okforth/1bICU/LU/LU.csv

Reference | Qty | Value | DNP | Exclude from BOM | Exclude from Board | Exclude from Simulation | Exclude from Position Files | Footprint | Datasheet
Q10,Q11,Q12,Q13,Q14,Q15,Q16,Q17,Q18,Q19,Q20,Q21,Q22,Q23,Q24,Q25,Q26,Q28,Q29,Q30,Q31,Q32,Q33,Q34,Q35,Q36,Q37,Q38,Q39,Q40,Q41,Q42,Q43,Q44,Q45,Q46,Q47,Q48,Q49,Q50 | 40 | NPN |  |  |  |  | ${EXCLUDE_FROM_POS_FILES} |  | https://ngspice.sourceforge.io/docs/ngspice-html-manual/manual.xhtml#cha_BJTs
R14,R16,R17,R19,R20,R21,R23,R25,R26,R27,R29,R31,R32,R34,R36,R37,R39,R43,R45,R47,R48,R50,R52,R53,R54,R56,R58,R59,R60,R62,R64,R65,R67,R69,R70,R72,R74,R75,R76,R78 | 40 | 22k |  |  |  |  | ${EXCLUDE_FROM_POS_FILES}
R15,R18,R22,R24,R28,R30,R33,R35,R38,R40,R44,R46,R49,R51,R55,R57,R61,R63,R66,R68,R71,R73,R77,R79 | 24 | 4.7k |  |  |  |  | ${EXCLUDE_FROM_POS_FILES}
