okforth/1bICU/main-list.csv

Reference | Qty | Value | DNP | Exclude from BOM | Exclude from Board | Exclude from Simulation | Exclude from Position Files | Footprint | Datasheet
D1,D2,D3 | 3 | YELLOW |  |  |  |  | ${EXCLUDE_FROM_POS_FILES}
Q1,Q2,Q3,Q4,Q5,Q6,Q7,Q8,Q9,Q10,Q11,Q12,Q13,Q14,Q15,Q16,Q17,Q18,Q19,Q20,Q21,Q22,Q23,Q24,Q25,Q26,Q27,Q28,Q29,Q30,Q31,Q32,Q33,Q34,Q35,Q36,Q37,Q38,Q39,Q40,Q41,Q42,Q43,Q44,Q45,Q46,Q47,Q48,Q49,Q50,Q51,Q52,Q53,Q54,Q55,Q56,Q57,Q58,Q59,Q60,Q61,Q62,Q63,Q64,Q65,Q66,Q67,Q68,Q69,Q70,Q71,Q72,Q73,Q74,Q75,Q76,Q77,Q78,Q79,Q80,Q81,Q82,Q83,Q84,Q85,Q86,Q87,Q88,Q89,Q90,Q91,Q92,Q93,Q94,Q95,Q96,Q97,Q98,Q99,Q100,Q101,Q102,Q106,Q107,Q108,Q110,Q112,Q113,Q114,Q115,Q116,Q117,Q118,Q119,Q120,Q121,Q122,Q129,Q130,Q131,Q132,Q133,Q134,Q135,Q136,Q137,Q138,Q139,Q140,Q141,Q143,Q147,Q148,Q149,Q150,Q151,Q152,Q153,Q154,Q155,Q156,Q161,Q163,Q164,Q165,Q166,Q167,Q168,Q169,Q170,Q171,Q172,Q173,Q174,Q175,Q176,Q177,Q178,Q179,Q180,Q181,Q182,Q183,Q245,Q246,Q261,Q262,Q263,Q264,Q265,Q266,Q267,Q268,Q269,Q270,Q272,Q273,Q274,Q275,Q276,Q277,Q278,Q279,Q280,Q281,Q282,Q283,Q285,Q286,Q287,Q290,Q291,Q292,Q295,Q296,Q297,Q299,Q300,Q301,Q302,Q303,Q304,Q305,Q306,Q307,Q308,Q309,Q310,Q311,Q312,Q313,Q314,Q315,Q316,Q317,Q318,Q319,Q320,Q321,Q322,Q323,Q324,Q325,Q326,Q327,Q328,Q329,Q330,Q331,Q332,Q333,Q334,Q335,Q336,Q337,Q338,Q339,Q340,Q341,Q342,Q343,Q344,Q345,Q346,Q347,Q348 | 246 | NPN |  |  |  |  | ${EXCLUDE_FROM_POS_FILES} |  | https://ngspice.sourceforge.io/docs/ngspice-html-manual/manual.xhtml#cha_BJTs
R1,R2,R3,R4,R5,R6,R7,R8,R13,R14,R15,R16,R29,R30,R31,R32,R33,R34,R35,R36,R38,R41,R42,R43,R44,R45,R46,R47,R49,R51,R57,R58,R59,R60,R61,R62,R63,R64,R69,R70,R71,R72,R81,R83,R85,R86,R87,R88,R91,R92,R93,R94,R98,R100,R101,R102,R103,R104,R105,R106,R107,R108,R109,R113,R114,R115,R116,R121,R122,R123,R124,R125,R126,R130,R131,R132,R136,R137,R138,R140,R147,R148,R149,R150,R151,R152,R153,R154,R156,R159,R162,R165,R171,R172,R173,R174,R175,R176,R177,R178,R184,R185,R186,R187,R188,R197,R199,R201,R202,R203,R205,R207,R213,R215,R216,R217,R218,R219,R222,R224,R226,R244,R245,R247,R251,R252,R253,R255,R259,R260,R262,R266,R267,R269,R275,R280,R281,R282,R284,R286,R287,R289,R291,R293,R294,R296,R300,R302,R304,R305,R307,R309,R310,R312,R314,R315,R317,R319,R320,R322,R324,R325,R327,R329,R330,R332,R474,R475,R507,R511,R512,R513,R515,R519,R520,R522,R526,R527,R529,R531,R534,R535,R537,R541,R542,R543,R545,R546,R547,R556,R558,R560,R565,R566,R567,R569,R570,R572,R575,R579,R580,R582,R586,R587,R589,R591,R594,R595,R597,R599,R600,R602,R606,R607,R608,R610,R614,R615,R617,R621,R622,R624,R626,R627,R629,R630,R632,R634,R636,R637,R639,R643,R644,R645,R647,R651,R652,R654,R658,R659,R661,R663,R666,R667,R669,R673,R675,R676,R678 | 249 | 22k |  |  |  |  | ${EXCLUDE_FROM_POS_FILES}
R9,R10,R11,R12,R17,R18,R19,R20,R65,R66,R67,R68,R73,R74,R75,R76,R246,R248,R261,R263,R506,R508,R521,R523,R536,R538,R581,R583,R601,R603,R616,R618,R638,R640,R653,R655 | 36 | 1k |  |  |  |  | ${EXCLUDE_FROM_POS_FILES}
R21,R22,R23,R24,R25,R26,R27,R28,R77,R78,R79,R142,R143,R144,R145,R146,R249,R250,R264,R265,R509,R510,R524,R525,R539,R540,R584,R585,R604,R605,R619,R620,R641,R642,R656,R657 | 36 | 10k |  |  |  |  | ${EXCLUDE_FROM_POS_FILES}
R37,R39,R40,R44,R45,R47,R48,R50,R52,R53,R54,R55,R56,R80,R82,R84,R89,R90,R95,R96,R97,R99,R110,R111,R112,R117,R118,R119,R120,R127,R128,R129,R133,R134,R135,R139,R141,R155,R157,R158,R160,R161,R163,R164,R166,R167,R168,R169,R170,R183,R193,R204,R206,R208,R214,R220,R221,R223,R225,R227,R254,R256,R257,R258,R268,R270,R271,R273,R283,R285,R288,R290,R292,R295,R297,R298,R299,R301,R303,R306,R308,R311,R313,R316,R318,R321,R323,R326,R328,R331,R333,R514,R516,R517,R518,R528,R530,R533,R550,R551,R552,R557,R559,R561,R571,R573,R574,R576,R577,R578,R588,R590,R592,R593,R596,R598,R609,R611,R612,R613,R623,R625,R628,R631,R633,R646,R648,R649,R650,R660,R662,R665,R668,R670,R671,R674,R677,R679 | 138 | 4.7k |  |  |  |  | ${EXCLUDE_FROM_POS_FILES}
R179,R180,R181,R182,R189,R190,R191,R192 | 8 | 2.2k |  |  |  |  | ${EXCLUDE_FROM_POS_FILES}
R635,R664,R672 | 3 | 220 |  |  |  |  | ${EXCLUDE_FROM_POS_FILES}
