okforth/1bICU/4x16 DEC/output.pdf

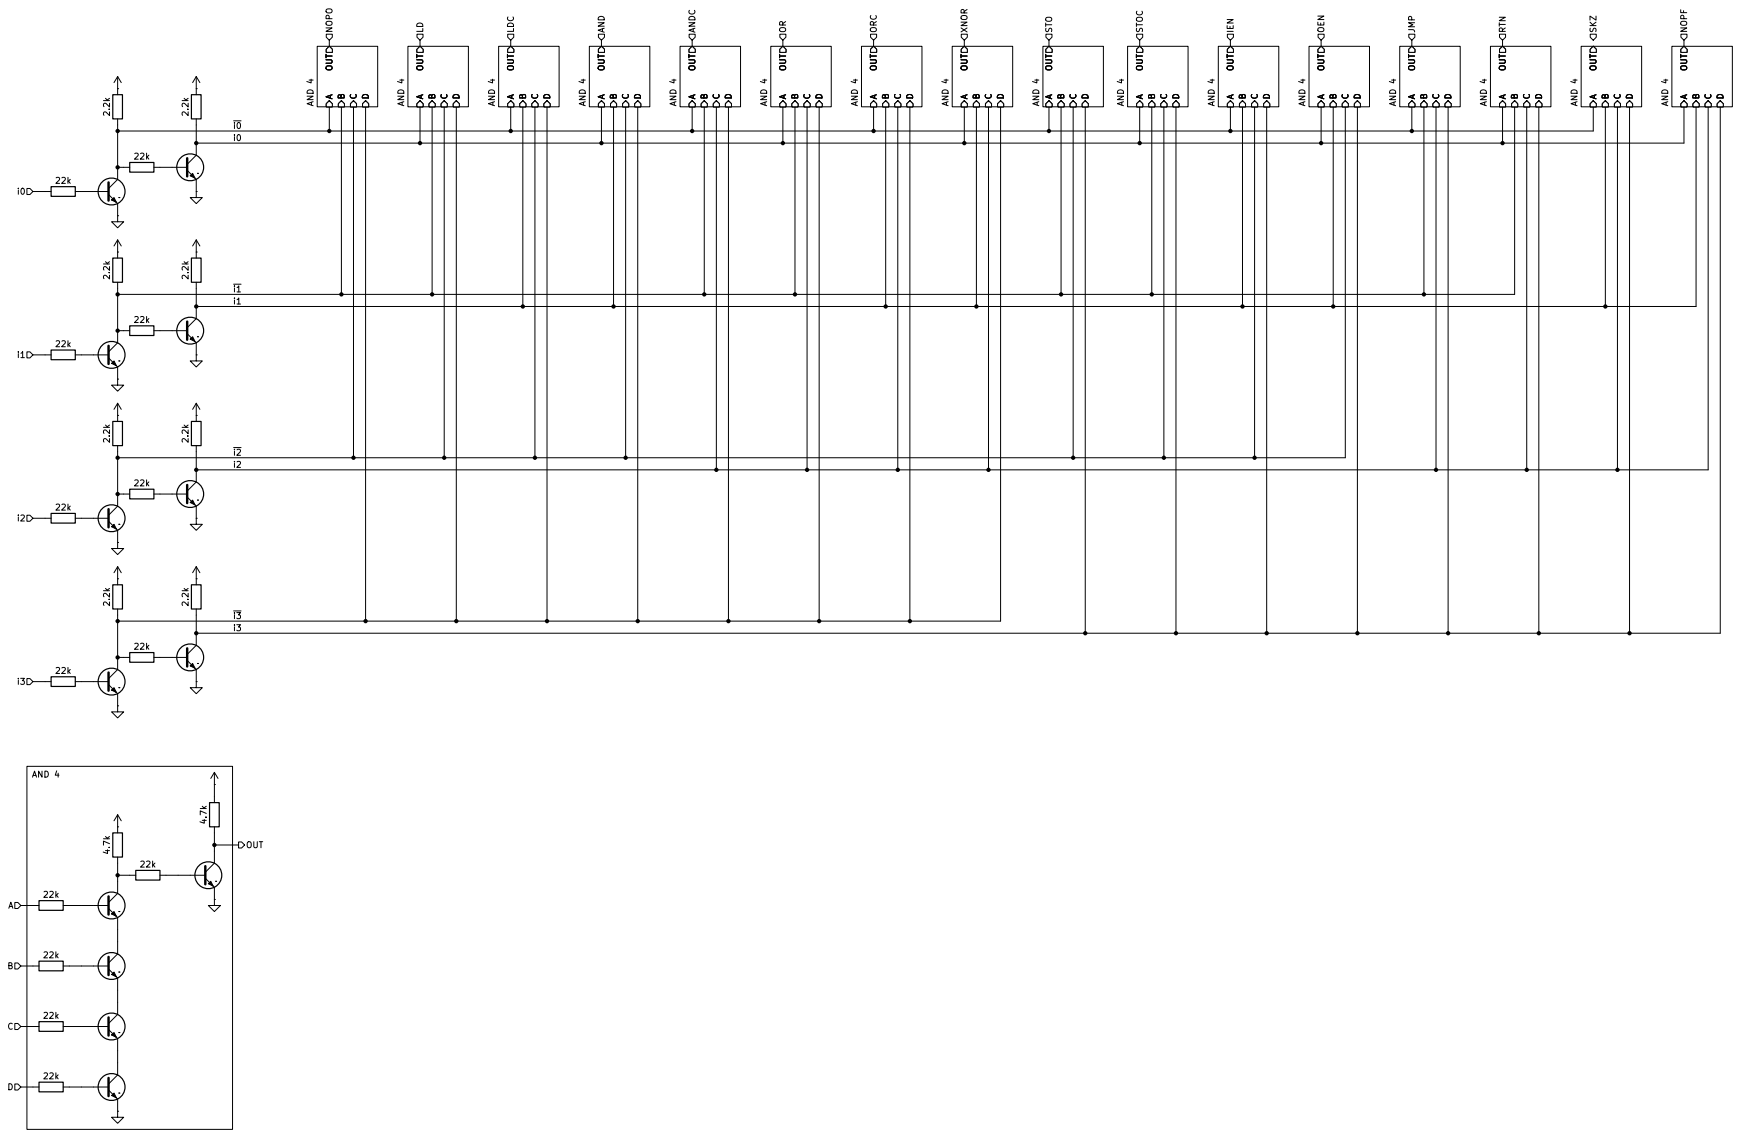
[picture p1: page 1]
