okforth/1bICU/DFF/output.pdf

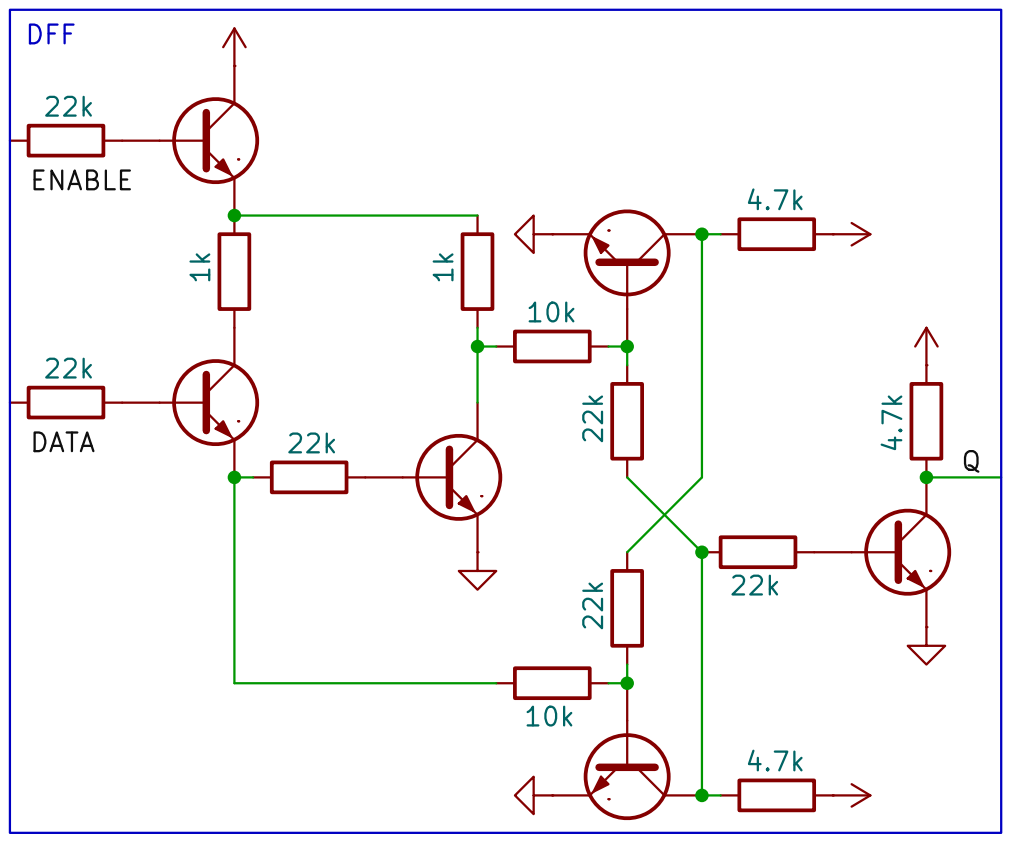
[picture p2: page 1]
