okforth/1bICU/INST REG/output.pdf

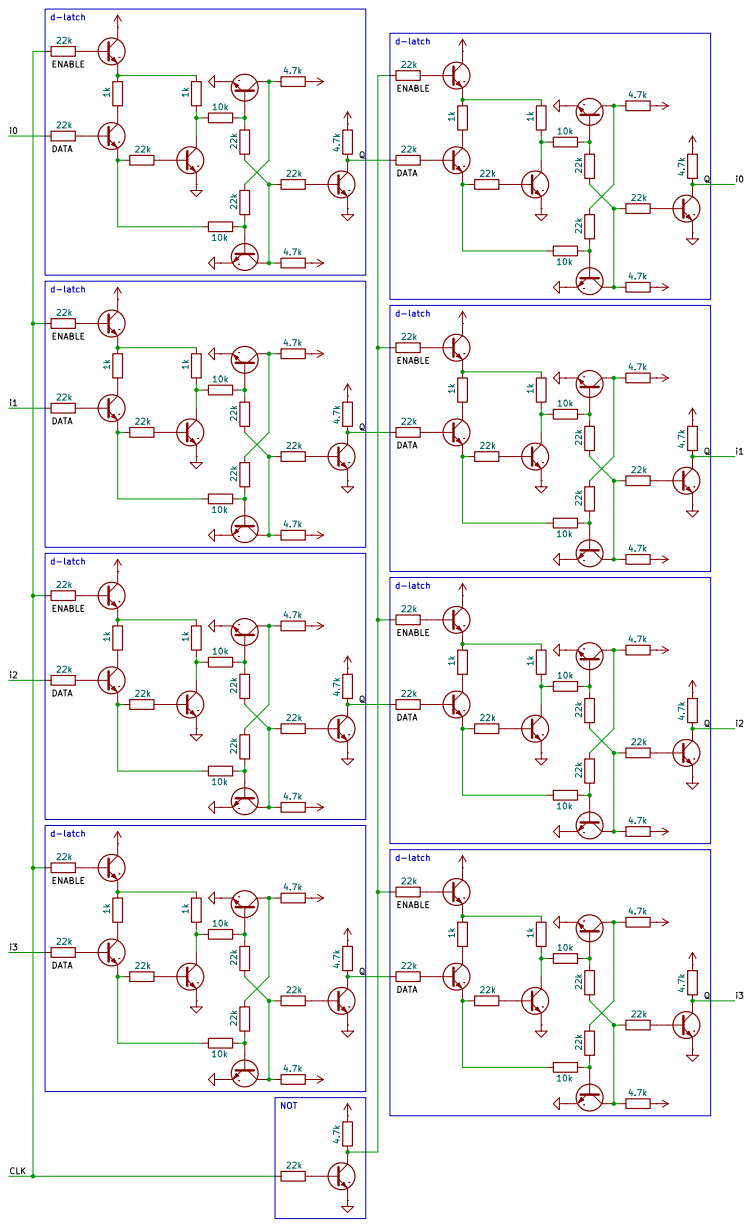
[picture p3: page 1]
