okforth/1bICU/LU/output.pdf

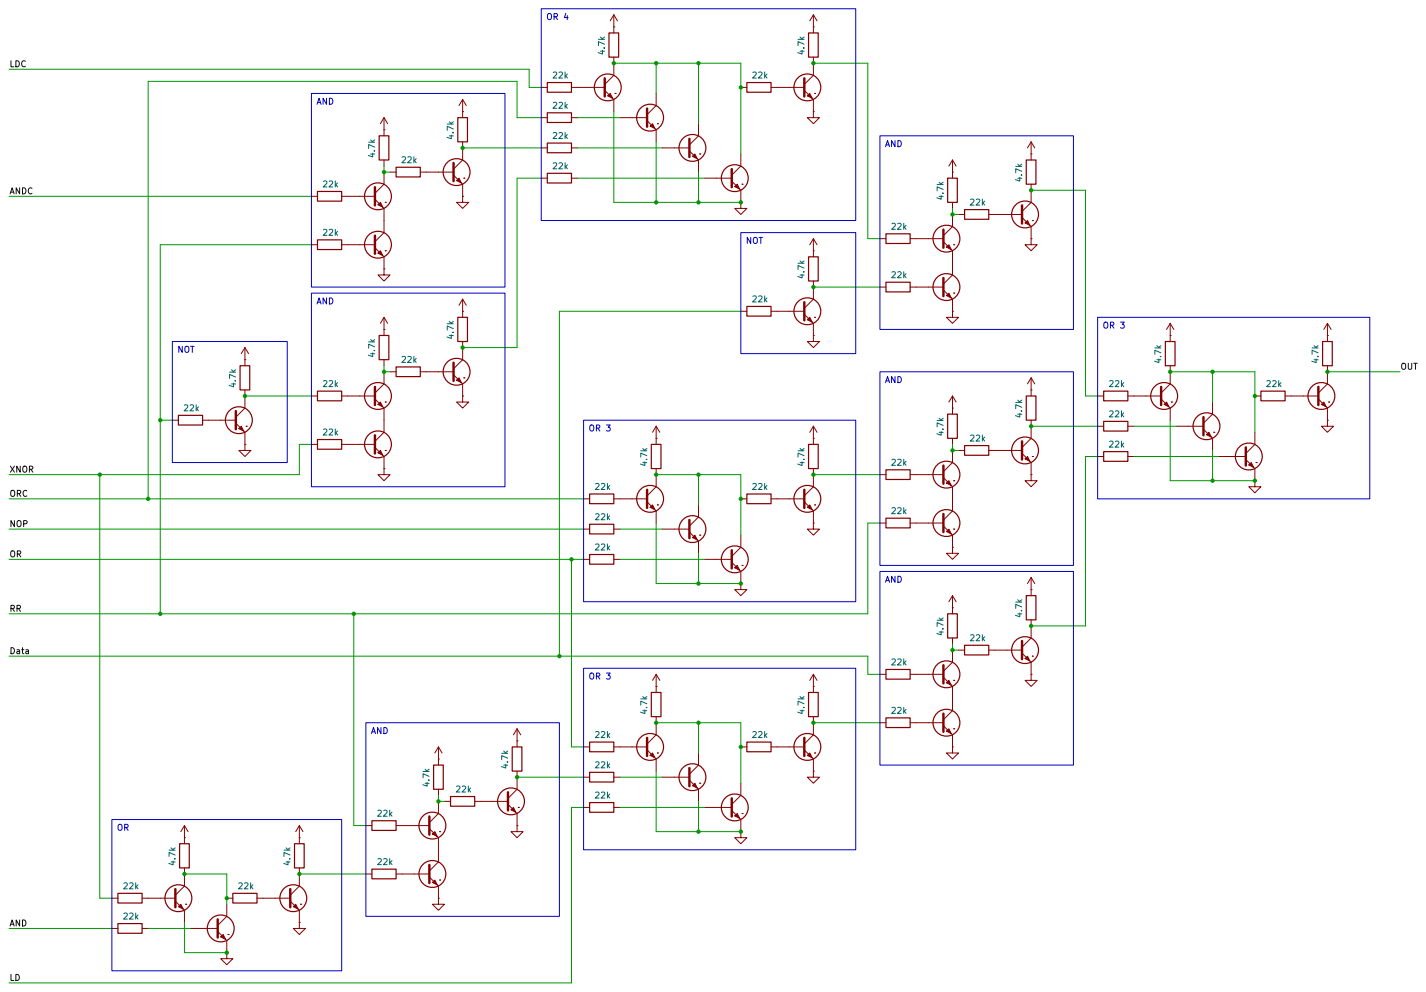
[picture p4: page 1]
