okforth/1bICU/(old)/1-bit adder/output.pdf

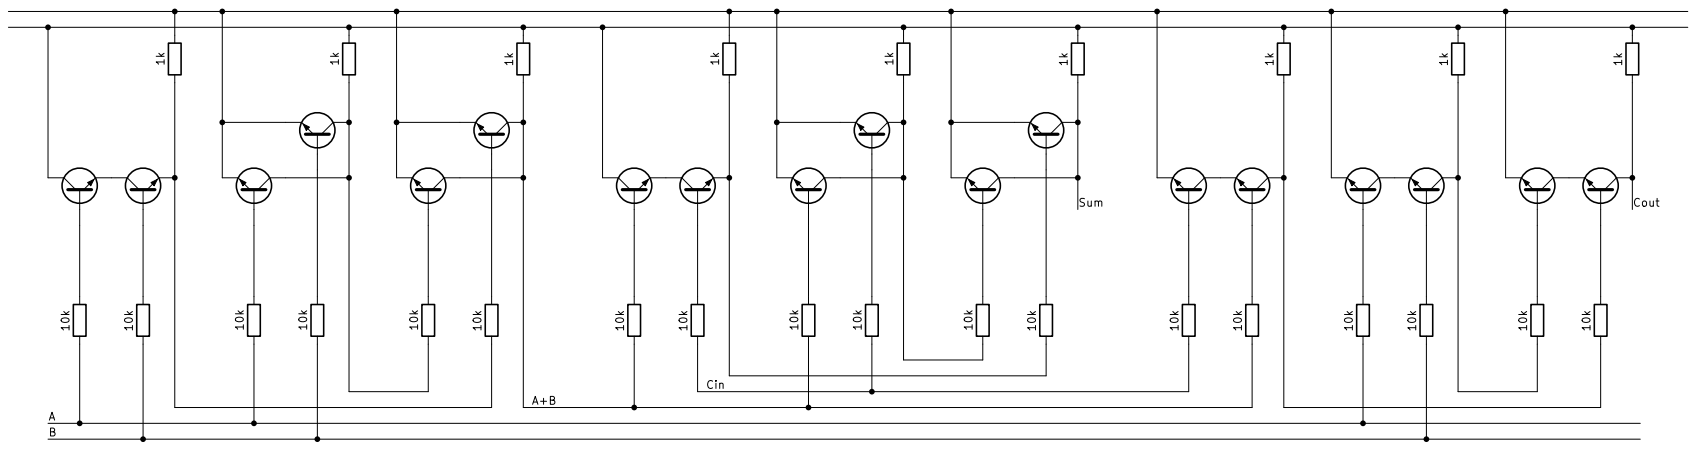
[picture p5: page 1]
