okforth/1bICU/4x16 DEC.kicad_sch

## KiCad design 4x16 DEC.kicad_sch (2026-10-11)

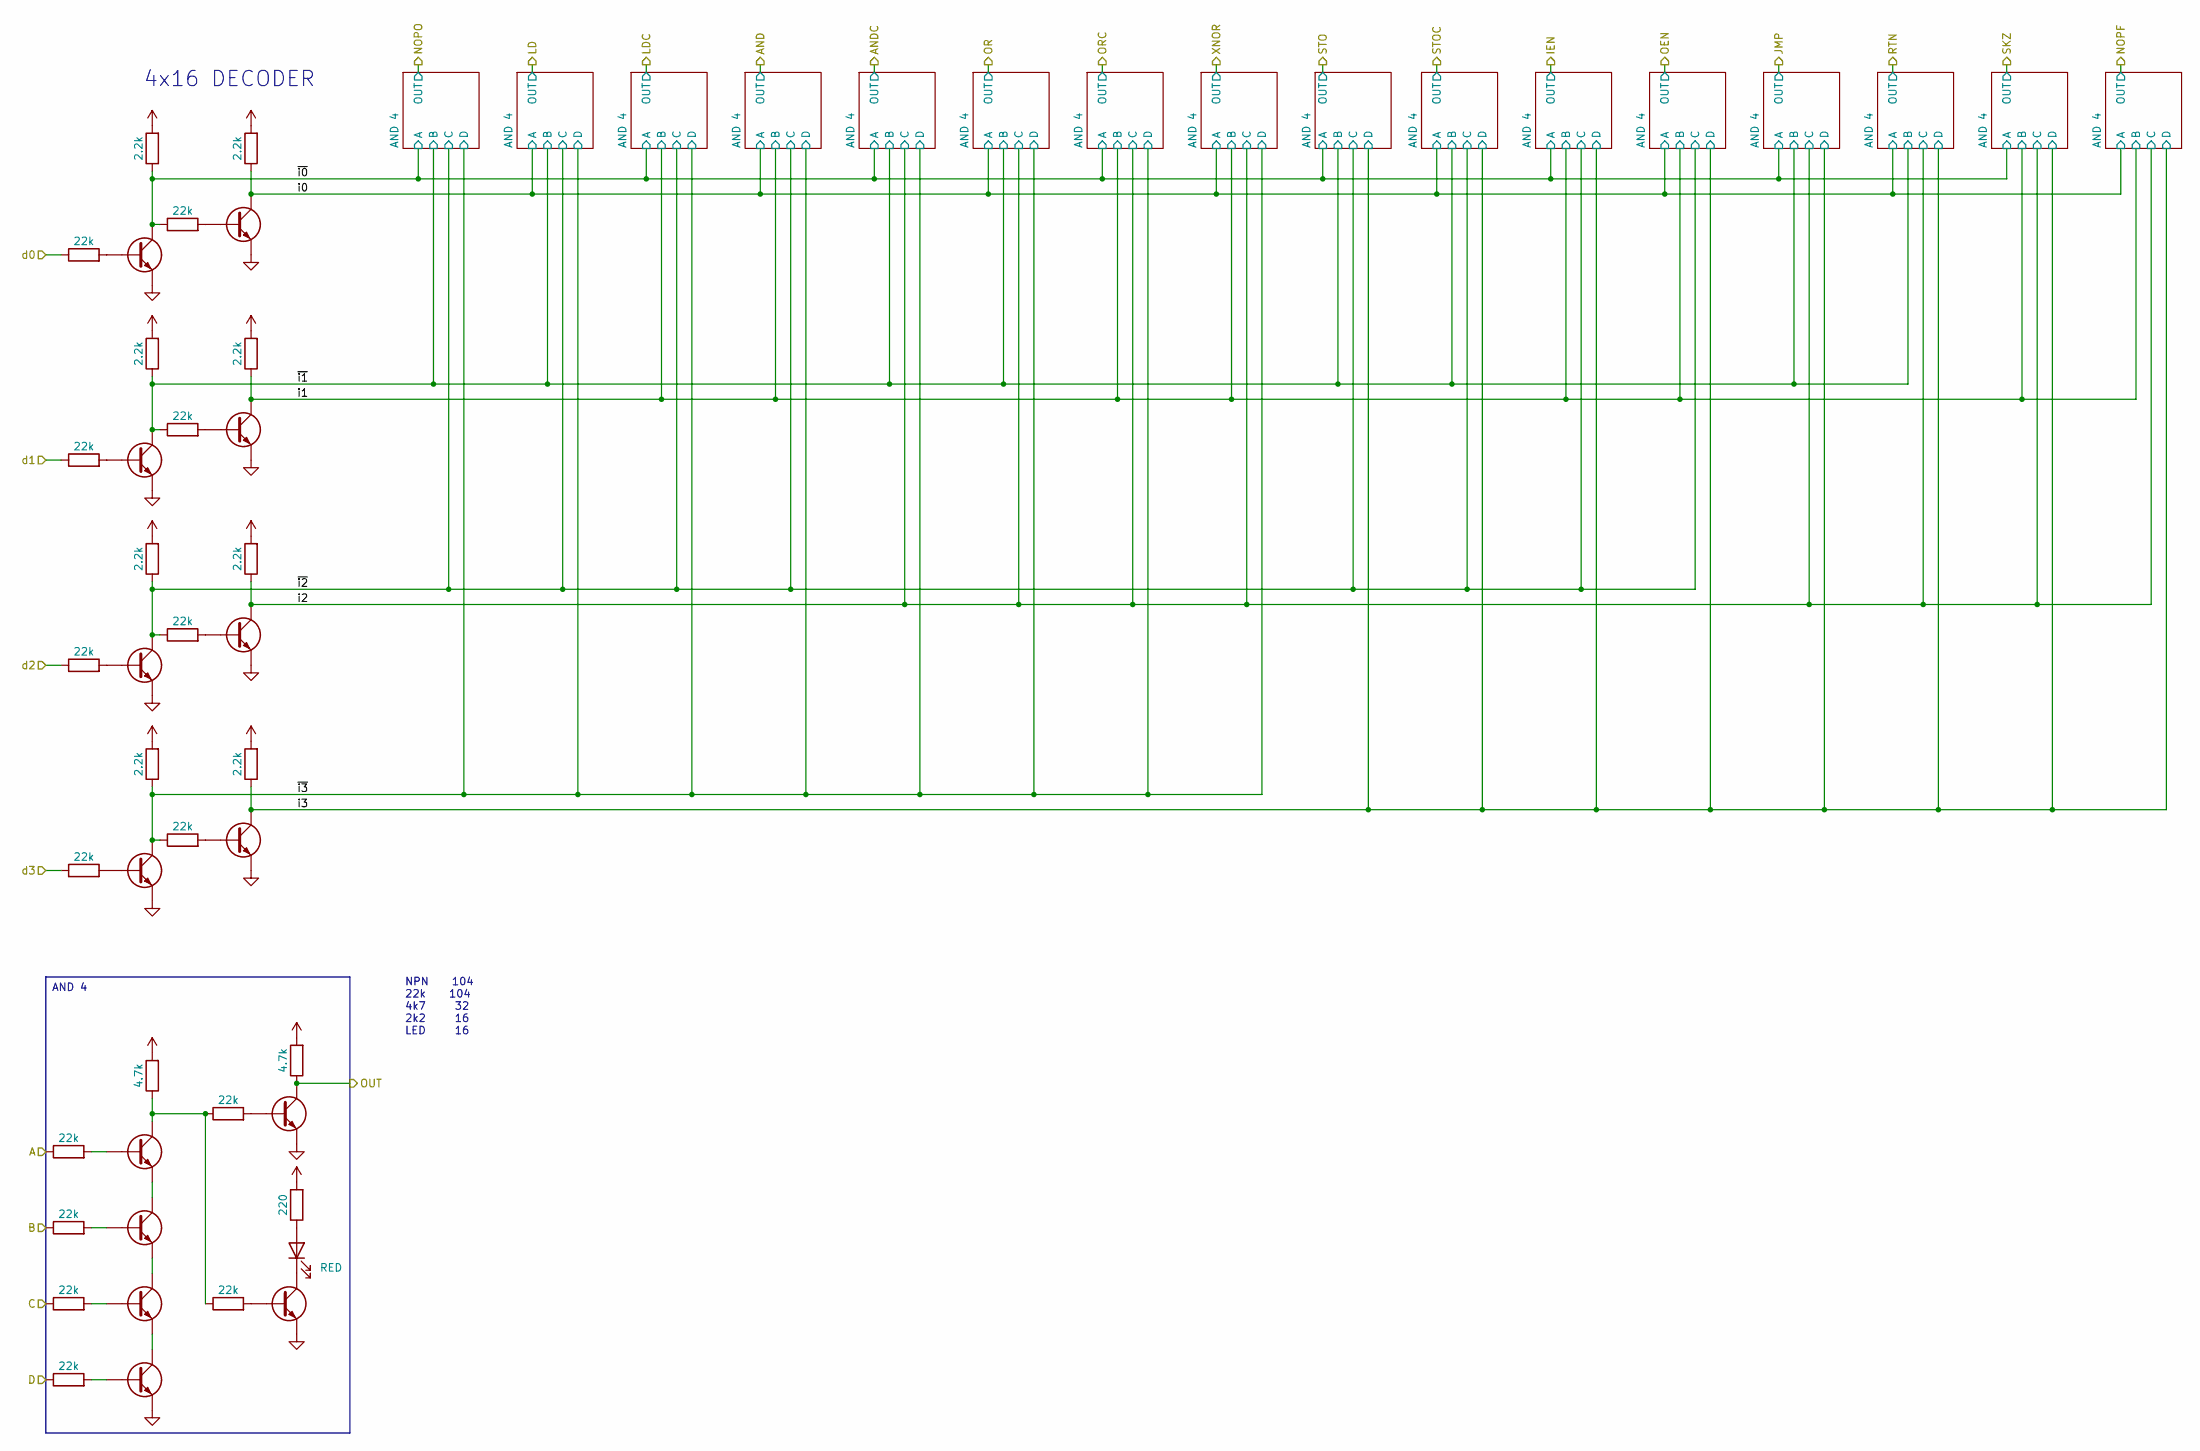
[picture p6: schematic 4x16 DEC.kicad_sch]

Parts:
D9: RED
Q90, Q91, Q92, Q93, Q94, Q95, Q96, Q97, Q98, Q99, Q100, Q101, Q102, Q103: NPN
R171, R172, R173, R174, R175, R176, R177, R178, R184, R185, R186, R187, R188, R200: 22k
R179, R180, R181, R182, R189, R190, R191, R192: 2.2k
R183, R193: 4.7k
R202: 220

Connections:
A: R171.1
B: R172.1
C: R173.1
D: R174.1
GND: Q90.3 (E), Q91.3 (E), Q92.3 (E), Q93.3 (E), Q97.3 (E), Q98.3 (E), Q99.3 (E), Q100.3 (E), Q101.3 (E), Q102.3 (E), Q103.3 (E)
unnamed: D9.1 (K), Q103.1 (C)
unnamed: D9.2 (A), R202.1
unnamed: Q90.2 (B), R175.2
unnamed: Q91.2 (B), R176.2
unnamed: Q92.2 (B), R177.2
unnamed: Q93.2 (B), R178.2
unnamed: Q94.1 (C), R183.1, R188.1, R200.1
unnamed: Q94.2 (B), R171.2
unnamed: Q94.3 (E), Q95.1 (C)
unnamed: Q95.2 (B), R172.2
unnamed: Q95.3 (E), Q96.1 (C)
unnamed: Q96.2 (B), R173.2
unnamed: Q96.3 (E), Q97.1 (C)
unnamed: Q97.2 (B), R174.2
unnamed: Q98.2 (B), R184.2
unnamed: Q99.2 (B), R185.2
unnamed: Q100.2 (B), R186.2
unnamed: Q101.2 (B), R187.2
unnamed: Q102.2 (B), R188.2
unnamed: Q103.2 (B), R200.2
OUT: Q102.1 (C), R193.1
VCC: R179.2, R180.2, R181.2, R182.2, R183.2, R189.2, R190.2, R191.2, R192.2, R193.2, R202.2
d0: R175.1
d1: R176.1
d2: R177.1
d3: R178.1
i0: Q98.1 (C), R189.1
i1: Q99.1 (C), R190.1
i2: Q100.1 (C), R191.1
i3: Q101.1 (C), R192.1
~i0: Q90.1 (C), R179.1, R184.1
~i1: Q91.1 (C), R180.1, R185.1
~i2: Q92.1 (C), R181.1, R186.1
~i3: Q93.1 (C), R182.1, R187.1

Notes on the sheet:
NPN 104 22k 104 4k7 32 2k2 16 LED 16
4x16 DECODER
AND 4
