okforth/1bICU/AND.kicad_sch

## KiCad design AND.kicad_sch (2026-10-11)

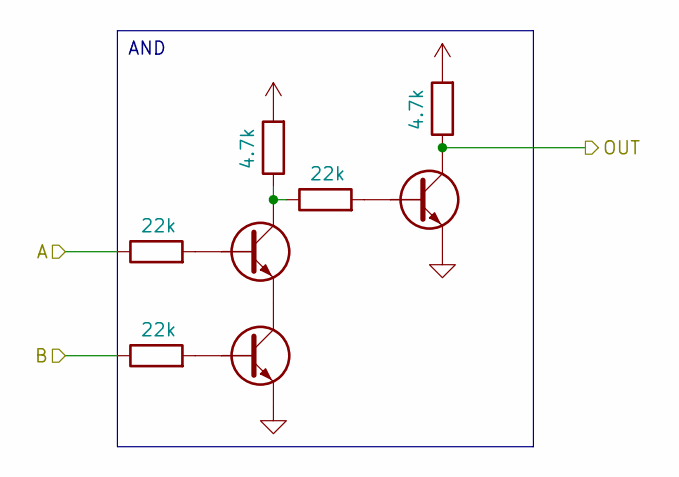
[picture p7: schematic AND.kicad_sch]

Parts:
Q197, Q198, Q199: NPN
R374, R375, R377: 22k
R376, R378: 4.7k

Connections:
+5V: R376.2, R378.2
A: R374.1
B: R375.1
GND: Q198.3 (E), Q199.3 (E)
unnamed: Q197.1 (C), R376.1, R377.1
unnamed: Q197.2 (B), R374.2
unnamed: Q197.3 (E), Q198.1 (C)
unnamed: Q198.2 (B), R375.2
unnamed: Q199.2 (B), R377.2
OUT: Q199.1 (C), R378.1

Notes on the sheet:
AND
