okforth/1bICU/BUFFER.kicad_sch

## KiCad design BUFFER.kicad_sch (2026-10-11)

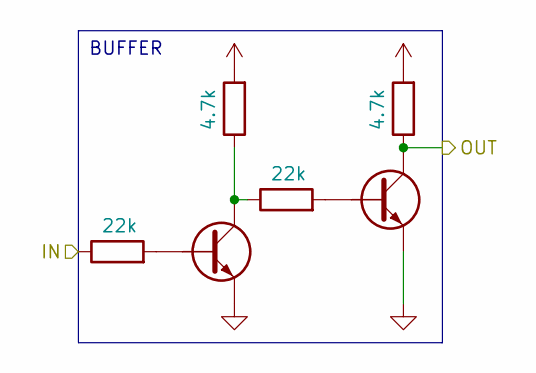
[picture p8: schematic BUFFER.kicad_sch]

Parts:
Q107, Q108: NPN
R205, R207: 22k
R206, R208: 4.7k

Connections:
+5V: R206.2, R208.2
GND: Q107.3 (E), Q108.3 (E)
IN: R205.1
unnamed: Q107.1 (C), R206.1, R207.1
unnamed: Q107.2 (B), R205.2
unnamed: Q108.2 (B), R207.2
OUT: Q108.1 (C), R208.1

Notes on the sheet:
BUFFER
