okforth/1bICU/DFF.kicad_sch

## KiCad design DFF.kicad_sch (2026-10-11)

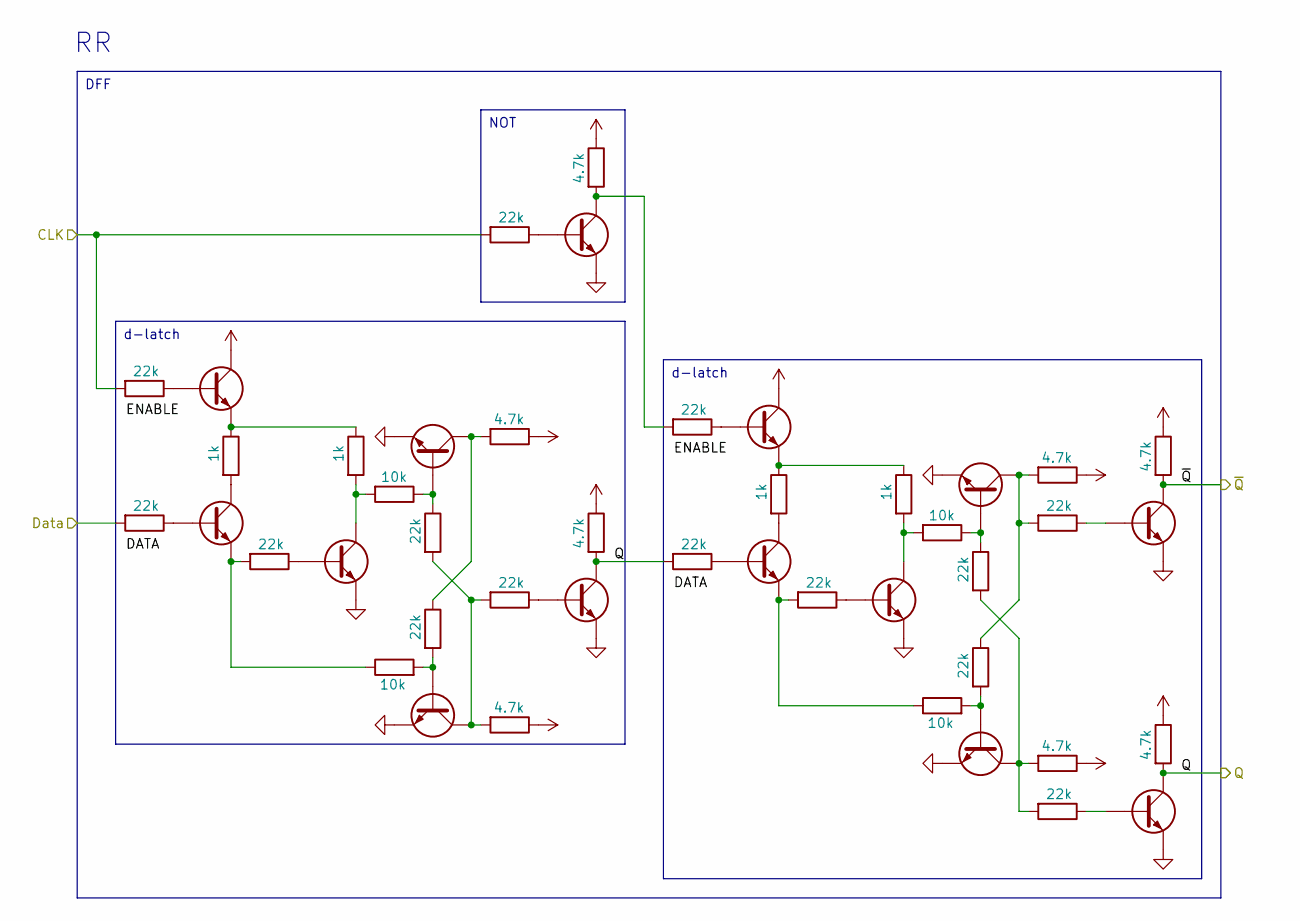
[picture p9: schematic DFF.kicad_sch]

Parts:
Q129, Q130, Q131, Q132, Q133, Q134, Q135, Q136, Q137, Q138, Q139, Q140, Q141, Q143: NPN
R244, R245, R247, R251, R252, R253, R255, R259, R260, R262, R266, R267, R269, R275: 22k
R246, R248, R261, R263: 1k
R249, R250, R264, R265: 10k
R254, R256, R257, R258, R268, R270, R271, R273: 4.7k

Connections:
CLK: R244.2, R253.2
Data: R245.2
GND: Q131.3 (E), Q132.3 (E), Q133.3 (E), Q134.3 (E), Q135.3 (E), Q138.3 (E), Q139.3 (E), Q140.3 (E), Q141.3 (E), Q143.3 (E)
unnamed: Q129.2 (B), R244.1
unnamed: Q129.3 (E), R246.1, R248.1
unnamed: Q130.1 (C), R246.2
unnamed: Q130.2 (B), R245.1
unnamed: Q130.3 (E), R247.2, R250.1
unnamed: Q131.1 (C), R248.2, R249.2
unnamed: Q131.2 (B), R247.1
unnamed: Q132.1 (C), R252.1, R254.2
unnamed: Q132.2 (B), R249.1, R251.1
unnamed: Q133.1 (C), R251.2, R255.2, R256.2
unnamed: Q133.2 (B), R250.2, R252.2
unnamed: Q134.1 (C), R257.2, R259.2
unnamed: Q134.2 (B), R253.1
unnamed: Q135.2 (B), R255.1
unnamed: Q136.2 (B), R259.1
unnamed: Q136.3 (E), R261.1, R263.1
unnamed: Q137.1 (C), R261.2
unnamed: Q137.2 (B), R260.1
unnamed: Q137.3 (E), R262.2, R265.1
unnamed: Q138.1 (C), R263.2, R264.2
unnamed: Q138.2 (B), R262.1
unnamed: Q139.1 (C), R267.1, R268.2, R275.2
unnamed: Q139.2 (B), R264.1, R266.1
unnamed: Q140.1 (C), R266.2, R269.2, R270.2
unnamed: Q140.2 (B), R265.2, R267.2
unnamed: Q141.2 (B), R269.1
unnamed: Q143.2 (B), R275.1
Q: Q135.1 (C), Q141.1 (C), R258.2, R260.2, R271.2
VCC: Q129.1 (C), Q136.1 (C), R254.1, R256.1, R257.1, R258.1, R268.1, R270.1, R271.1, R273.1
~Q: Q143.1 (C), R273.2

Notes on the sheet:
DFF
d-latch
NOT
