okforth/1bICU/Flag O Unit.kicad_sch

## KiCad design Flag O Unit.kicad_sch (2026-10-11)

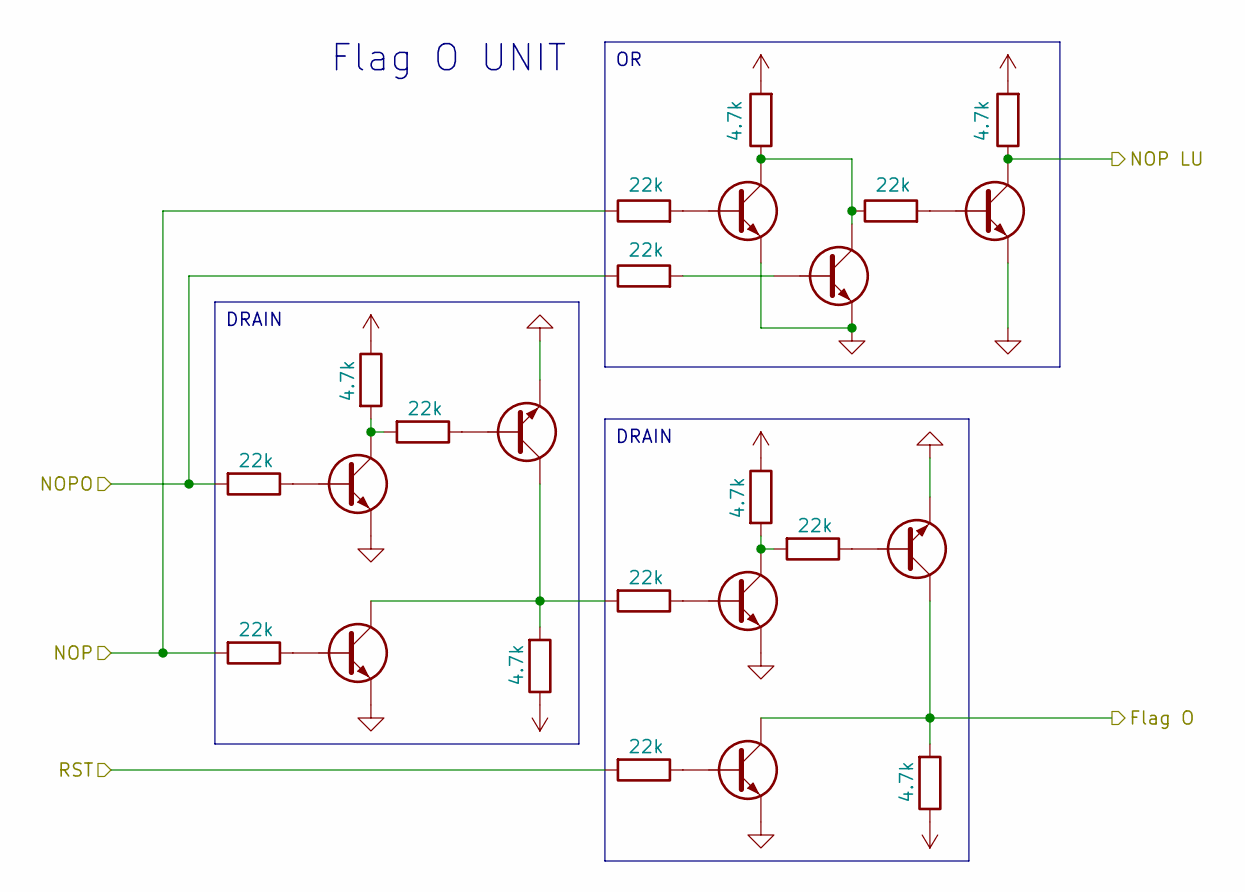
[picture p10: schematic Flag O Unit.kicad_sch]

Parts:
Q179, Q180, Q181, Q320, Q344, Q345, Q346, Q347, Q348: NPN
R324, R325, R327, R627, R634, R673, R675, R676, R678: 22k
R326, R328, R671, R674, R677, R679: 4.7k

Connections:
+5V: R326.2, R328.2
Flag O: Q347.1 (C), Q348.1 (C), R679.2
GND: Q179.3 (E), Q180.3 (E), Q181.3 (E), Q320.3 (E), Q344.3 (E), Q345.3 (E), Q346.3 (E), Q347.3 (E), Q348.3 (E)
NOP: R324.1, R634.2
NOP LU: Q181.1 (C), R328.1
NOPO: R325.1, R627.2
unnamed: Q179.1 (C), Q180.1 (C), R326.1, R327.1
unnamed: Q179.2 (B), R324.2
unnamed: Q180.2 (B), R325.2
unnamed: Q181.2 (B), R327.2
unnamed: Q320.1 (C), R671.2, R673.2
unnamed: Q320.2 (B), R627.1
unnamed: Q344.1 (C), Q345.1 (C), R674.2, R675.2
unnamed: Q344.2 (B), R634.1
unnamed: Q345.2 (B), R673.1
unnamed: Q346.1 (C), R677.2, R678.2
unnamed: Q346.2 (B), R675.1
unnamed: Q347.2 (B), R676.1
unnamed: Q348.2 (B), R678.1
RST: R676.2
VCC: R671.1, R674.1, R677.1, R679.1

Notes on the sheet:
Flag O UNIT
DRAIN
