okforth/1bICU/IEN Unit.kicad_sch

## KiCad design IEN Unit.kicad_sch (2026-10-11)

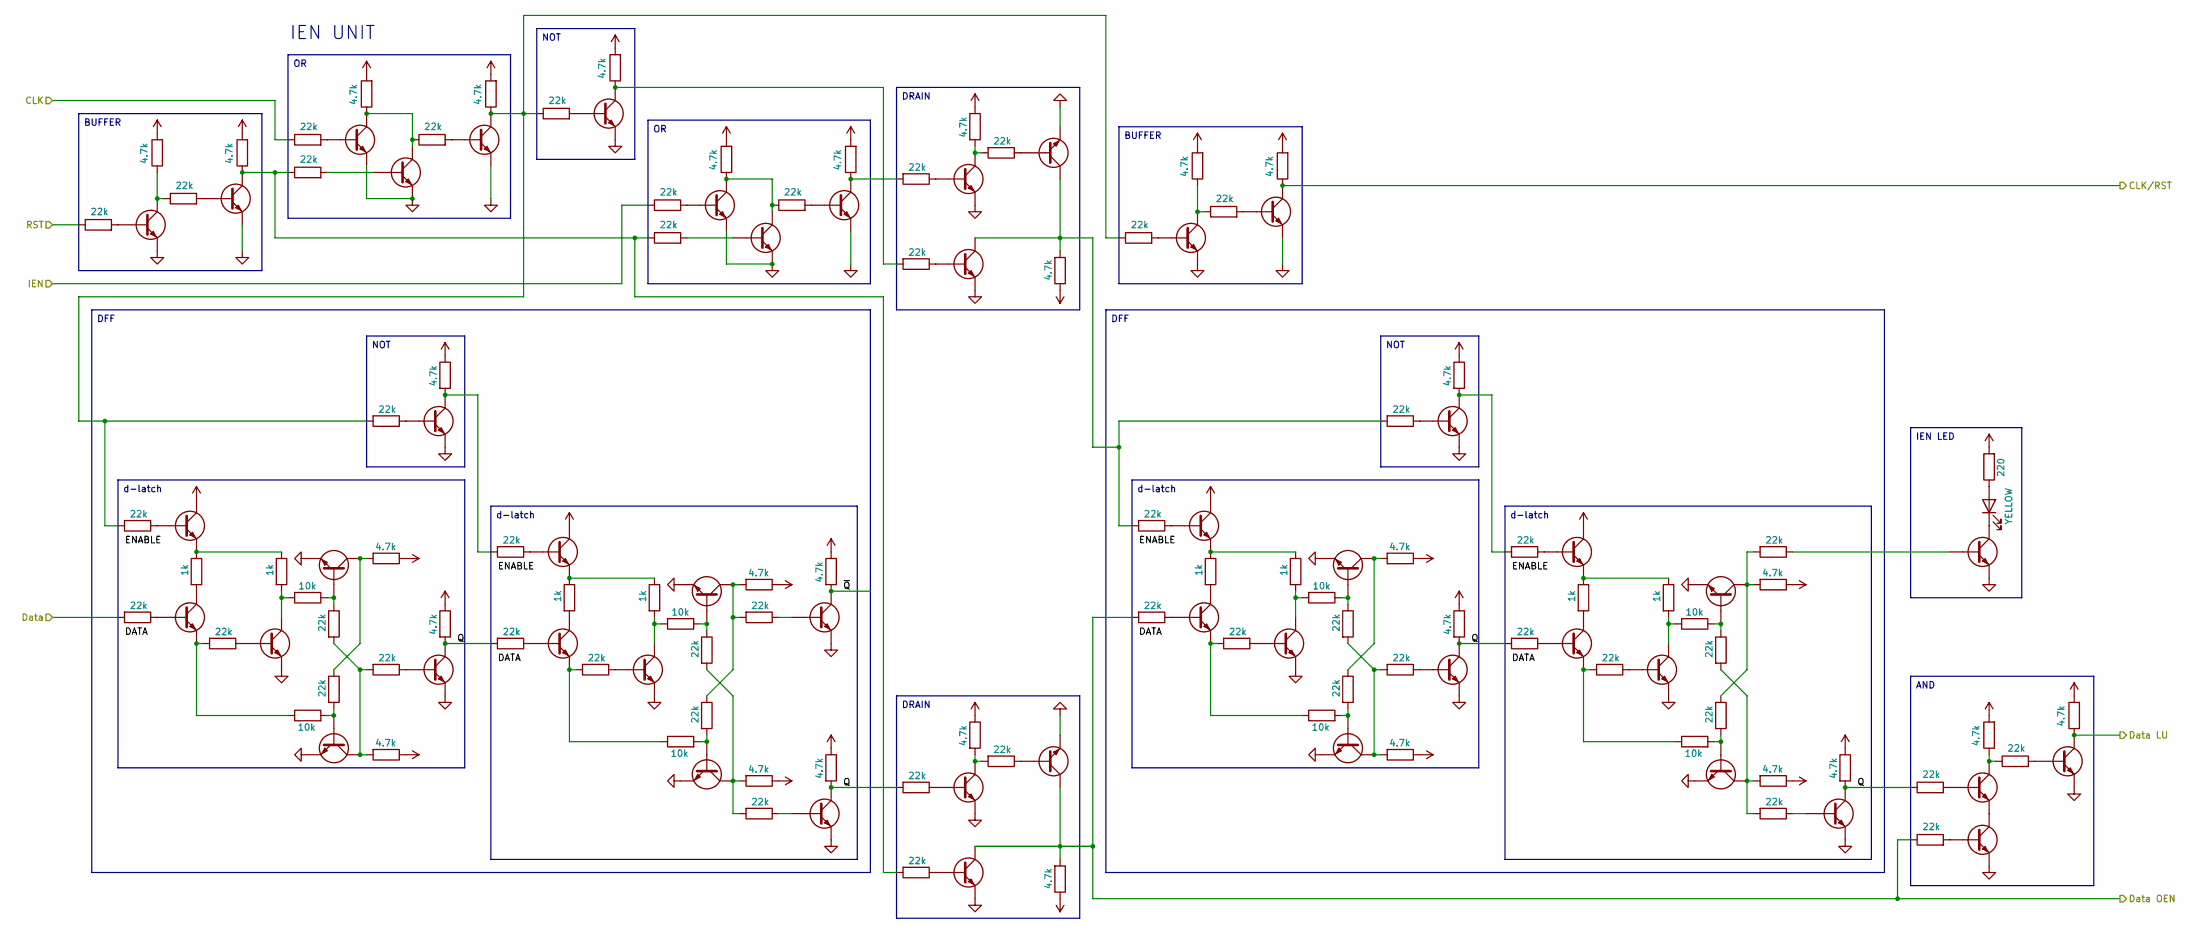
[picture p11: schematic IEN Unit.kicad_sch]

Parts:
D1: YELLOW
Q108, Q116, Q117, Q119, Q120, Q121, Q122, Q171, Q172, Q182, Q183, Q273, Q274, Q275, Q276, Q277, Q278, Q279, Q280, Q281, Q282, Q283, Q287, Q292, Q297, Q302, Q303, Q304, Q305, Q306, Q307, Q308, Q309, Q310, Q311, Q312, Q313, Q314, Q315, Q316, Q317, Q318, Q319, Q321, Q322, Q323, Q324, Q325: NPN
R207, R219, R222, R224, R226, R309, R310, R312, R329, R330, R332, R534, R535, R537, R541, R542, R543, R547, R560, R567, R575, R579, R580, R582, R586, R587, R589, R591, R594, R595, R597, R599, R600, R602, R606, R607, R608, R610, R614, R615, R617, R621, R622, R624, R626, R629, R630, R632: 22k
R208, R221, R223, R225, R227, R311, R313, R331, R333, R552, R561, R574, R576, R577, R578, R588, R590, R592, R593, R596, R598, R609, R611, R612, R613, R623, R625, R628, R631, R633: 4.7k
R536, R538, R581, R583, R601, R603, R616, R618: 1k
R539, R540, R584, R585, R604, R605, R619, R620: 10k
R635: 220

Connections:
+5V: R208.2, R221.2, R223.2, R225.2, R227.2, R311.2, R313.2, R331.2, R333.2, R631.2, R633.2
CLK: R329.1
CLK/RST: Q117.1 (C), R223.1
Data: R535.2
Data LU: Q324.1 (C), R633.1
Data OEN: Q306.1 (C), Q307.1 (C), R598.2, R600.2, R630.1
GND: Q108.3 (E), Q116.3 (E), Q117.3 (E), Q119.3 (E), Q120.3 (E), Q121.3 (E), Q122.3 (E), Q171.3 (E), Q172.3 (E), Q182.3 (E), Q183.3 (E), Q275.3 (E), Q276.3 (E), Q277.3 (E), Q278.3 (E), Q279.3 (E), Q282.3 (E), Q283.3 (E), Q287.3 (E), Q292.3 (E), Q297.3 (E), Q302.3 (E), Q303.3 (E), Q304.3 (E), Q305.3 (E), Q306.3 (E), Q307.3 (E), Q310.3 (E), Q311.3 (E), Q312.3 (E), Q313.3 (E), Q314.3 (E), Q317.3 (E), Q318.3 (E), Q319.3 (E), Q321.3 (E), Q323.3 (E), Q324.3 (E), Q325.3 (E)
IEN: R309.1
unnamed: D1.1 (K), Q325.1 (C)
unnamed: D1.2 (A), R635.1
unnamed: Q108.1 (C), R208.1, R567.2
unnamed: Q108.2 (B), R207.2
unnamed: Q116.1 (C), R221.1, R222.1
unnamed: Q116.2 (B), R219.2
unnamed: Q117.2 (B), R222.2
unnamed: Q119.1 (C), R225.1, R226.1
unnamed: Q119.2 (B), R224.2
unnamed: Q120.1 (C), R227.1, R310.1, R330.1, R595.2
unnamed: Q120.2 (B), R226.2
unnamed: Q121.1 (C), Q171.1 (C), R311.1, R312.1
unnamed: Q121.2 (B), R309.2
unnamed: Q122.1 (C), Q182.1 (C), R331.1, R332.1
unnamed: Q122.2 (B), R329.2
unnamed: Q171.2 (B), R310.2
unnamed: Q172.1 (C), R313.1, R547.2
unnamed: Q172.2 (B), R312.2
unnamed: Q182.2 (B), R330.2
unnamed: Q183.1 (C), R207.1, R219.1, R333.1, R534.2, R543.2
unnamed: Q183.2 (B), R332.2
unnamed: Q273.2 (B), R534.1
unnamed: Q273.3 (E), R536.1, R538.1
unnamed: Q274.1 (C), R536.2
unnamed: Q274.2 (B), R535.1
unnamed: Q274.3 (E), R537.2, R540.1
unnamed: Q275.1 (C), R538.2, R539.2
unnamed: Q275.2 (B), R537.1
unnamed: Q276.1 (C), R542.1, R574.2
unnamed: Q276.2 (B), R539.1, R541.1
unnamed: Q277.1 (C), R541.2, R575.2, R576.2
unnamed: Q277.2 (B), R540.2, R542.2
unnamed: Q278.1 (C), R577.2, R579.2
unnamed: Q278.2 (B), R543.1
unnamed: Q279.2 (B), R575.1
unnamed: Q280.2 (B), R579.1
unnamed: Q280.3 (E), R581.1, R583.1
unnamed: Q281.1 (C), R581.2
unnamed: Q281.2 (B), R580.1
unnamed: Q281.3 (E), R582.2, R585.1
unnamed: Q282.1 (C), R583.2, R584.2
unnamed: Q282.2 (B), R582.1
unnamed: Q283.1 (C), R587.1, R588.2, R589.2
unnamed: Q283.2 (B), R584.1, R586.1
unnamed: Q287.1 (C), R552.2, R560.2
unnamed: Q287.2 (B), R547.1
unnamed: Q292.1 (C), Q297.1 (C), R561.2, R599.2, R608.2
unnamed: Q292.2 (B), R560.1
unnamed: Q297.2 (B), R567.1
unnamed: Q302.1 (C), R586.2, R590.2, R591.2
unnamed: Q302.2 (B), R585.2, R587.2
unnamed: Q303.2 (B), R589.1
unnamed: Q304.2 (B), R591.1
unnamed: Q305.1 (C), R596.2, R597.2
unnamed: Q305.2 (B), R594.1
unnamed: Q306.2 (B), R595.1
unnamed: Q307.2 (B), R597.1
unnamed: Q308.2 (B), R599.1
unnamed: Q308.3 (E), R601.1, R603.1
unnamed: Q309.1 (C), R601.2
unnamed: Q309.2 (B), R600.1
unnamed: Q309.3 (E), R602.2, R605.1
unnamed: Q310.1 (C), R603.2, R604.2
unnamed: Q310.2 (B), R602.1
unnamed: Q311.1 (C), R607.1, R609.2
unnamed: Q311.2 (B), R604.1, R606.1
unnamed: Q312.1 (C), R606.2, R610.2, R611.2
unnamed: Q312.2 (B), R605.2, R607.2
unnamed: Q313.1 (C), R612.2, R614.2
unnamed: Q313.2 (B), R608.1
unnamed: Q314.2 (B), R610.1
unnamed: Q315.2 (B), R614.1
unnamed: Q315.3 (E), R616.1, R618.1
unnamed: Q316.1 (C), R616.2
unnamed: Q316.2 (B), R615.1
unnamed: Q316.3 (E), R617.2, R620.1
unnamed: Q317.1 (C), R618.2, R619.2
unnamed: Q317.2 (B), R617.1
unnamed: Q318.1 (C), R622.1, R623.2, R624.2
unnamed: Q318.2 (B), R619.1, R621.1
unnamed: Q319.1 (C), R621.2, R625.2, R626.2
unnamed: Q319.2 (B), R620.2, R622.2
unnamed: Q321.2 (B), R626.1
unnamed: Q322.1 (C), R631.1, R632.1
unnamed: Q322.2 (B), R629.2
unnamed: Q322.3 (E), Q323.1 (C)
unnamed: Q323.2 (B), R630.2
unnamed: Q324.2 (B), R632.2
unnamed: Q325.2 (B), R624.1
Q: Q279.1 (C), Q304.1 (C), Q314.1 (C), Q321.1 (C), R578.2, R580.2, R593.2, R594.2, R613.2, R615.2, R628.2, R629.1
RST: R224.1
VCC: Q273.1 (C), Q280.1 (C), Q308.1 (C), Q315.1 (C), R552.1, R561.1, R574.1, R576.1, R577.1, R578.1, R588.1, R590.1, R592.1, R593.1, R596.1, R598.1, R609.1, R611.1, R612.1, R613.1, R623.1, R625.1, R628.1, R635.2
~Q: Q303.1 (C), R592.2

Notes on the sheet:
IEN UNIT
DRAIN
BUFFER
IEN LED
DFF
d-latch
NOT
AND
