okforth/1bICU/INST REG.kicad_sch

## KiCad design INST REG.kicad_sch (2026-10-11)

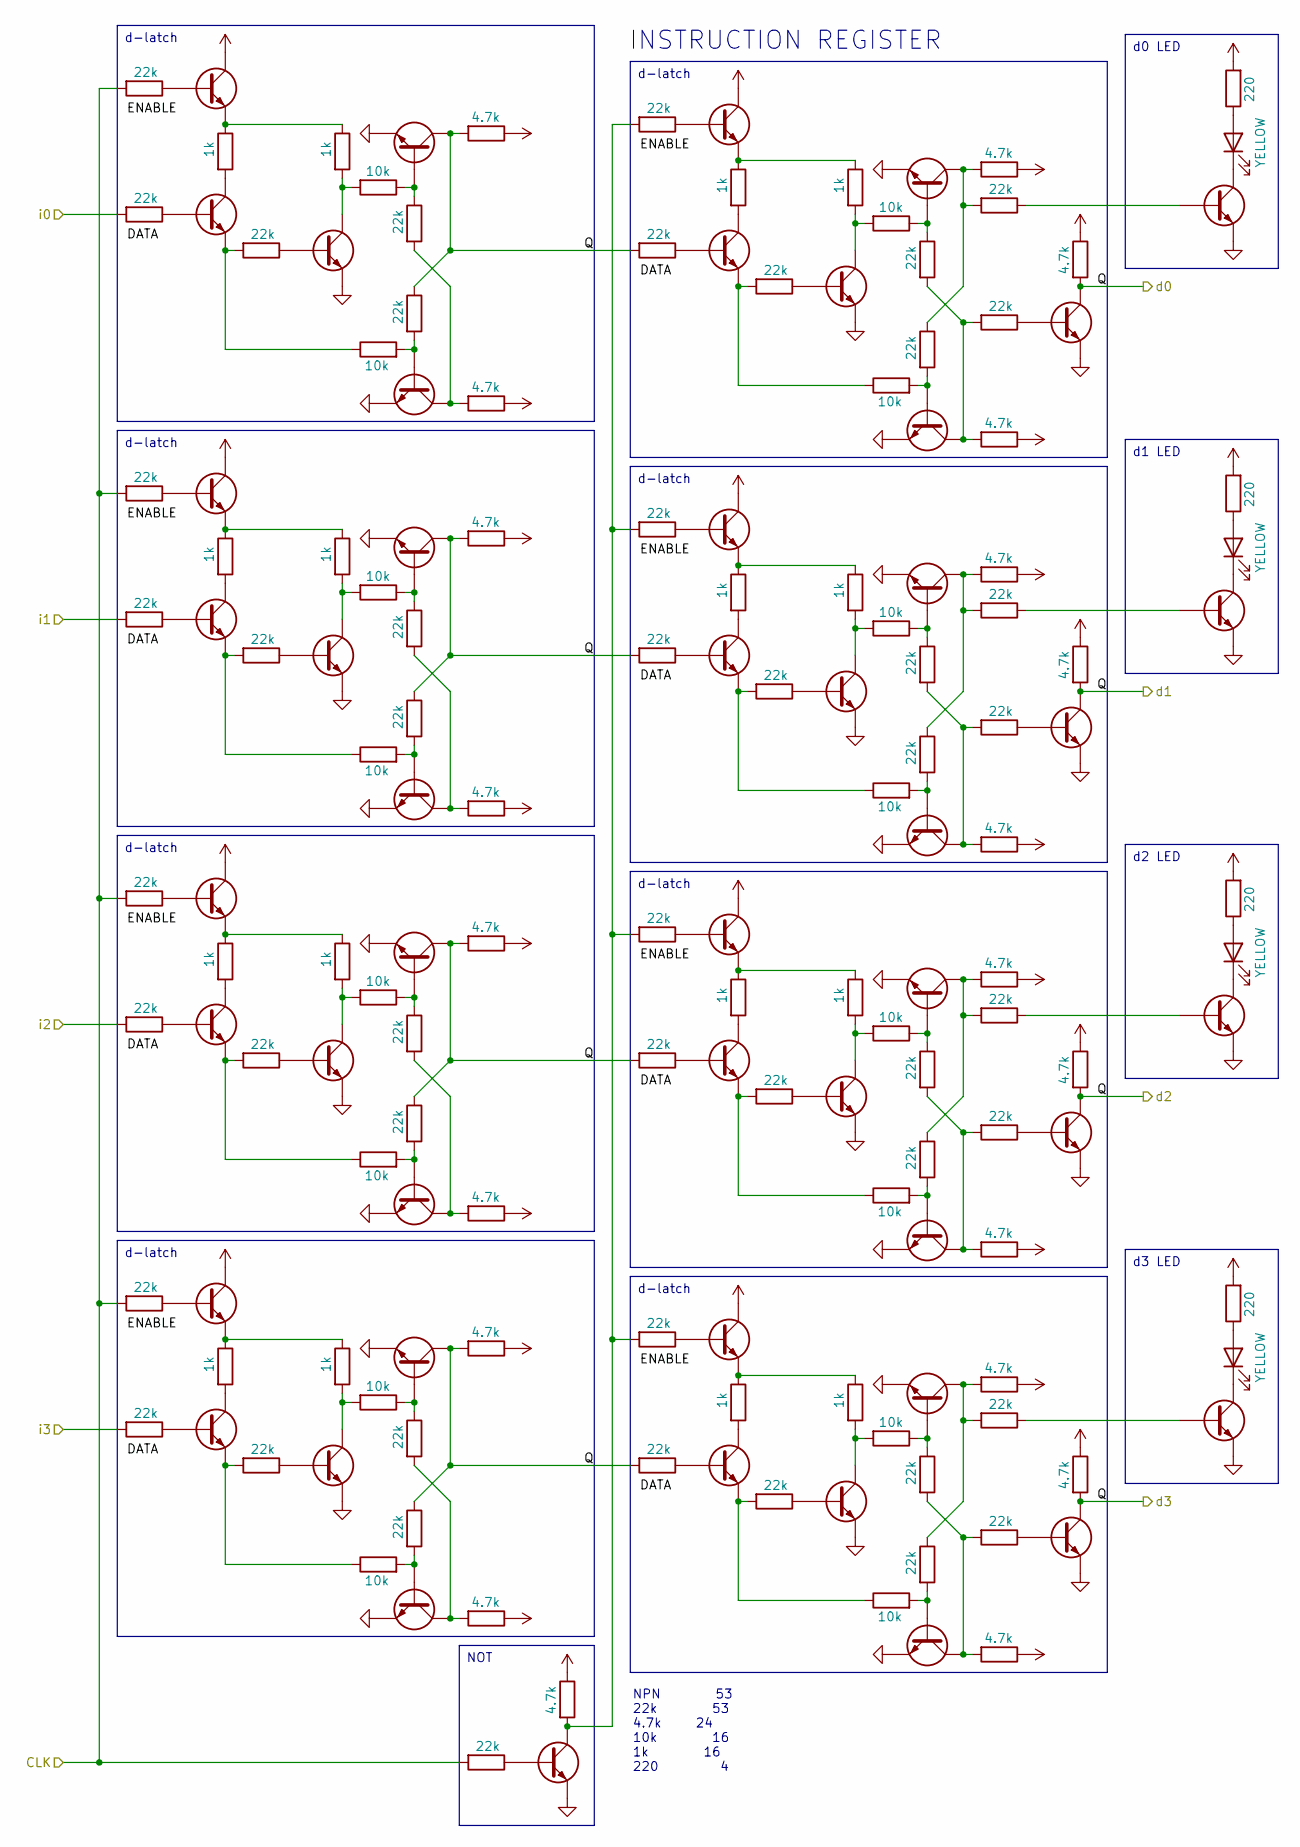
[picture p12: schematic INST REG.kicad_sch]

Parts:
D5, D6, D7, D8: YELLOW
Q1, Q2, Q3, Q4, Q5, Q6, Q7, Q8, Q9, Q10, Q11, Q12, Q13, Q14, Q15, Q16, Q17, Q18, Q19, Q20, Q25, Q26, Q28, Q29, Q30, Q31, Q32, Q33, Q34, Q35, Q36, Q37, Q38, Q39, Q40, Q41, Q42, Q43, Q44, Q45, Q46, Q47, Q48, Q49, Q50, Q350, Q351, Q352, Q353: NPN
R1, R2, R3, R4, R5, R6, R7, R8, R13, R14, R15, R16, R29, R30, R31, R32, R33, R34, R35, R36, R51, R57, R58, R59, R60, R61, R62, R63, R64, R69, R70, R71, R72, R147, R148, R149, R150, R151, R152, R153, R154, R156, R159, R162, R165, R194, R195, R196, R198: 22k
R9, R10, R11, R12, R17, R18, R19, R20, R65, R66, R67, R68, R73, R74, R75, R76: 1k
R21, R22, R23, R24, R25, R26, R27, R28, R77, R78, R79, R142, R143, R144, R145, R146: 10k
R37, R39, R40, R44, R45, R47, R48, R50, R56, R155, R157, R158, R160, R161, R163, R164, R166, R167, R168, R169, R170: 4.7k
R681, R682, R683, R684: 220

Connections:
CLK: R1.2, R3.2, R5.2, R7.2, R51.2
GND: Q9.3 (E), Q10.3 (E), Q11.3 (E), Q12.3 (E), Q13.3 (E), Q14.3 (E), Q15.3 (E), Q16.3 (E), Q17.3 (E), Q18.3 (E), Q19.3 (E), Q20.3 (E), Q25.3 (E), Q35.3 (E), Q36.3 (E), Q37.3 (E), Q38.3 (E), Q39.3 (E), Q40.3 (E), Q41.3 (E), Q42.3 (E), Q43.3 (E), Q44.3 (E), Q45.3 (E), Q46.3 (E), Q47.3 (E), Q48.3 (E), Q49.3 (E), Q50.3 (E), Q350.3 (E), Q351.3 (E), Q352.3 (E), Q353.3 (E)
unnamed: D5.1 (K), Q350.1 (C)
unnamed: D5.2 (A), R681.1
unnamed: D6.1 (K), Q351.1 (C)
unnamed: D6.2 (A), R682.1
unnamed: D7.1 (K), Q352.1 (C)
unnamed: D7.2 (A), R683.1
unnamed: D8.1 (K), Q353.1 (C)
unnamed: D8.2 (A), R684.1
unnamed: Q1.2 (B), R1.1
unnamed: Q1.3 (E), R9.1, R17.1
unnamed: Q2.1 (C), R9.2
unnamed: Q2.2 (B), R2.1
unnamed: Q2.3 (E), R13.2, R22.1
unnamed: Q3.2 (B), R3.1
unnamed: Q3.3 (E), R10.1, R18.1
unnamed: Q4.1 (C), R10.2
unnamed: Q4.2 (B), R4.1
unnamed: Q4.3 (E), R14.2, R24.1
unnamed: Q5.2 (B), R5.1
unnamed: Q5.3 (E), R11.1, R19.1
unnamed: Q6.1 (C), R11.2
unnamed: Q6.2 (B), R6.1
unnamed: Q6.3 (E), R15.2, R26.1
unnamed: Q7.2 (B), R7.1
unnamed: Q7.3 (E), R12.1, R20.1
unnamed: Q8.1 (C), R12.2
unnamed: Q8.2 (B), R8.1
unnamed: Q8.3 (E), R16.2, R28.1
unnamed: Q9.1 (C), R17.2, R21.2
unnamed: Q9.2 (B), R13.1
unnamed: Q10.1 (C), R18.2, R23.2
unnamed: Q10.2 (B), R14.1
unnamed: Q11.1 (C), R19.2, R25.2
unnamed: Q11.2 (B), R15.1
unnamed: Q12.1 (C), R20.2, R27.2
unnamed: Q12.2 (B), R16.1
unnamed: Q13.2 (B), R21.1, R29.1
unnamed: Q14.1 (C), R29.2, R39.2
unnamed: Q14.2 (B), R22.2, R30.2
unnamed: Q15.2 (B), R23.1, R31.1
unnamed: Q16.1 (C), R31.2, R44.2
unnamed: Q16.2 (B), R24.2, R32.2
unnamed: Q17.2 (B), R25.1, R33.1
unnamed: Q18.1 (C), R33.2, R47.2
unnamed: Q18.2 (B), R26.2, R34.2
unnamed: Q19.2 (B), R27.1, R35.1
unnamed: Q20.1 (C), R35.2, R50.2
unnamed: Q20.2 (B), R28.2, R36.2
unnamed: Q25.1 (C), R56.2, R57.2, R59.2, R61.2, R63.2
unnamed: Q25.2 (B), R51.1
unnamed: Q26.2 (B), R57.1
unnamed: Q26.3 (E), R65.1, R73.1
unnamed: Q28.1 (C), R65.2
unnamed: Q28.2 (B), R58.1
unnamed: Q28.3 (E), R69.2, R78.1
unnamed: Q29.2 (B), R59.1
unnamed: Q29.3 (E), R66.1, R74.1
unnamed: Q30.1 (C), R66.2
unnamed: Q30.2 (B), R60.1
unnamed: Q30.3 (E), R70.2, R142.1
unnamed: Q31.2 (B), R61.1
unnamed: Q31.3 (E), R67.1, R75.1
unnamed: Q32.1 (C), R67.2
unnamed: Q32.2 (B), R62.1
unnamed: Q32.3 (E), R71.2, R144.1
unnamed: Q33.2 (B), R63.1
unnamed: Q33.3 (E), R68.1, R76.1
unnamed: Q34.1 (C), R68.2
unnamed: Q34.2 (B), R64.1
unnamed: Q34.3 (E), R72.2, R146.1
unnamed: Q35.1 (C), R73.2, R77.2
unnamed: Q35.2 (B), R69.1
unnamed: Q36.1 (C), R74.2, R79.2
unnamed: Q36.2 (B), R70.1
unnamed: Q37.1 (C), R75.2, R143.2
unnamed: Q37.2 (B), R71.1
unnamed: Q38.1 (C), R76.2, R145.2
unnamed: Q38.2 (B), R72.1
unnamed: Q39.1 (C), R148.1, R155.2, R194.2
unnamed: Q39.2 (B), R77.1, R147.1
unnamed: Q40.1 (C), R147.2, R156.2, R157.2
unnamed: Q40.2 (B), R78.2, R148.2
unnamed: Q41.1 (C), R150.1, R158.2, R195.2
unnamed: Q41.2 (B), R79.1, R149.1
unnamed: Q42.1 (C), R149.2, R159.2, R160.2
unnamed: Q42.2 (B), R142.2, R150.2
unnamed: Q43.1 (C), R152.1, R161.2, R196.2
unnamed: Q43.2 (B), R143.1, R151.1
unnamed: Q44.1 (C), R151.2, R162.2, R163.2
unnamed: Q44.2 (B), R144.2, R152.2
unnamed: Q45.1 (C), R154.1, R164.2, R198.2
unnamed: Q45.2 (B), R145.1, R153.1
unnamed: Q46.1 (C), R153.2, R165.2, R166.2
unnamed: Q46.2 (B), R146.2, R154.2
unnamed: Q47.2 (B), R156.1
unnamed: Q48.2 (B), R159.1
unnamed: Q49.2 (B), R162.1
unnamed: Q50.2 (B), R165.1
unnamed: Q350.2 (B), R194.1
unnamed: Q351.2 (B), R195.1
unnamed: Q352.2 (B), R196.1
unnamed: Q353.2 (B), R198.1
VCC: Q1.1 (C), Q3.1 (C), Q5.1 (C), Q7.1 (C), Q26.1 (C), Q29.1 (C), Q31.1 (C), Q33.1 (C), R37.1, R39.1, R40.1, R44.1, R45.1, R47.1, R48.1, R50.1, R56.1, R155.1, R157.1, R158.1, R160.1, R161.1, R163.1, R164.1, R166.1, R167.1, R168.1, R169.1, R170.1, R681.2, R682.2, R683.2, R684.2
d0: Q13.1 (C), Q15.1 (C), Q17.1 (C), Q19.1 (C), Q47.1 (C), Q48.1 (C), Q49.1 (C), Q50.1 (C), R30.1, R32.1, R34.1, R36.1, R37.2, R40.2, R45.2, R48.2, R58.2, R60.2, R62.2, R64.2, R167.2, R168.2, R169.2, R170.2
i0: R2.2
i1: R4.2
i2: R6.2
i3: R8.2

Notes on the sheet:
NPN 53 22k 53 4.7k 24 10k 16 1k 16 220 4
INSTRUCTION REGISTER
d3 LED
NOT
d-latch
d1 LED
d2 LED
d0 LED
