okforth/1bICU/LOW.kicad_sch

## KiCad design LOW.kicad_sch (2026-10-11)

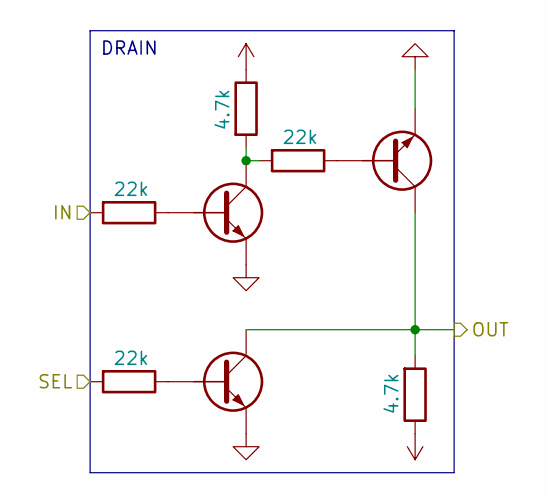
[picture p13: schematic LOW.kicad_sch]

Parts:
Q285, Q290, Q295: NPN
R545, R556, R565: 22k
R550, R557: 4.7k

Connections:
GND: Q285.3 (E), Q290.3 (E), Q295.3 (E)
IN: R545.2
unnamed: Q285.1 (C), R550.2, R556.2
unnamed: Q285.2 (B), R545.1
unnamed: Q290.2 (B), R556.1
unnamed: Q295.2 (B), R565.1
OUT: Q290.1 (C), Q295.1 (C), R557.2
SEL: R565.2
VCC: R550.1, R557.1

Notes on the sheet:
DRAIN
