okforth/1bICU/LU.kicad_sch

## KiCad design LU.kicad_sch (2026-10-11)

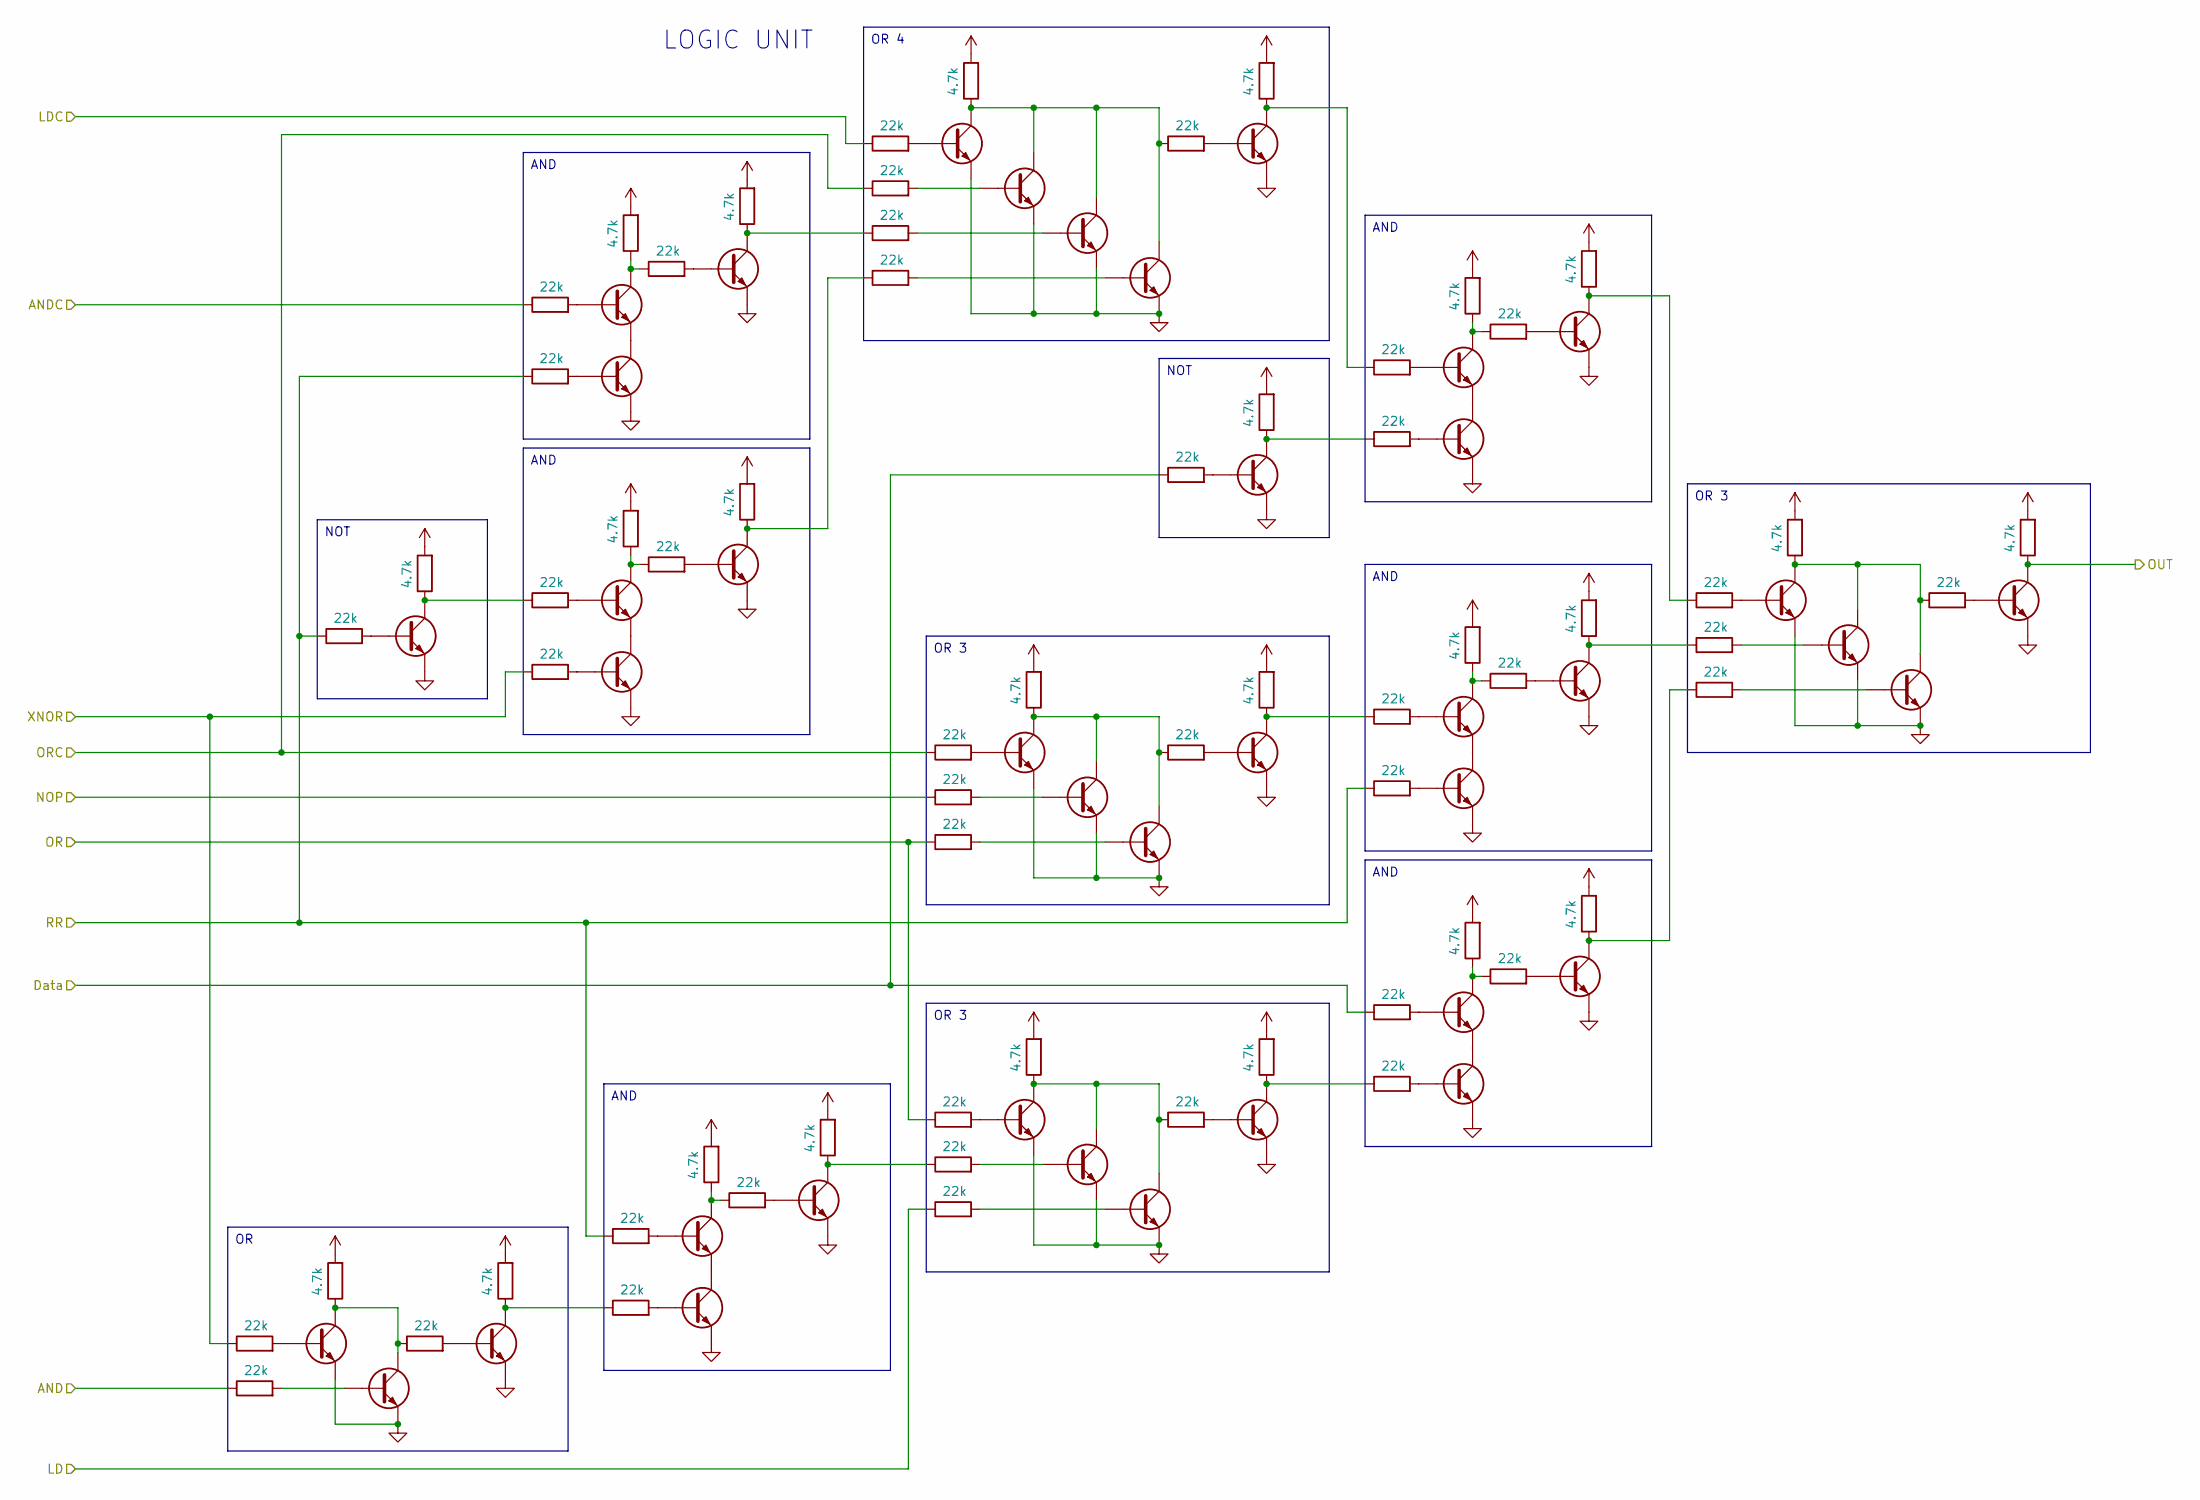
[picture p14: schematic LU.kicad_sch]

Parts:
Q27, Q51, Q52, Q53, Q54, Q55, Q56, Q57, Q58, Q59, Q60, Q61, Q62, Q63, Q64, Q65, Q66, Q67, Q68, Q69, Q70, Q71, Q72, Q73, Q74, Q75, Q76, Q77, Q78, Q79, Q80, Q81, Q82, Q83, Q84, Q85, Q86, Q87, Q88, Q89: NPN
R41, R42, R81, R83, R85, R86, R87, R88, R91, R92, R93, R94, R98, R100, R101, R102, R103, R104, R105, R106, R107, R108, R109, R113, R114, R115, R116, R121, R122, R123, R124, R125, R126, R130, R131, R132, R136, R137, R138, R140: 22k
R80, R82, R84, R89, R90, R95, R96, R97, R99, R110, R111, R112, R117, R118, R119, R120, R127, R128, R129, R133, R134, R135, R139, R141: 4.7k

Connections:
+5V: R80.2, R82.2, R84.2, R89.2, R90.2, R95.2, R96.2, R97.2, R99.2, R110.2, R111.2, R112.2, R117.2, R118.2, R119.2, R120.2, R127.2, R128.2, R129.2, R133.2, R134.2, R135.2, R139.2, R141.2
AND: R42.1
ANDC: R85.1
Data: R114.1, R125.1
GND: Q27.3 (E), Q51.3 (E), Q52.3 (E), Q53.3 (E), Q55.3 (E), Q57.3 (E), Q59.3 (E), Q60.3 (E), Q61.3 (E), Q62.3 (E), Q63.3 (E), Q64.3 (E), Q65.3 (E), Q66.3 (E), Q67.3 (E), Q68.3 (E), Q69.3 (E), Q70.3 (E), Q71.3 (E), Q72.3 (E), Q73.3 (E), Q74.3 (E), Q75.3 (E), Q76.3 (E), Q78.3 (E), Q80.3 (E), Q82.3 (E), Q83.3 (E), Q84.3 (E), Q85.3 (E), Q86.3 (E), Q87.3 (E), Q88.3 (E), Q89.3 (E)
LD: R109.1
LDC: R100.1
NOP: R105.1
unnamed: Q27.1 (C), Q51.1 (C), R80.1, R83.1
unnamed: Q27.2 (B), R41.2
unnamed: Q51.2 (B), R42.2
unnamed: Q52.1 (C), R82.1, R87.1
unnamed: Q52.2 (B), R81.2
unnamed: Q53.1 (C), R84.1, R92.1
unnamed: Q53.2 (B), R83.2
unnamed: Q54.1 (C), R89.1, R93.1
unnamed: Q54.2 (B), R85.2
unnamed: Q54.3 (E), Q55.1 (C)
unnamed: Q55.2 (B), R86.2
unnamed: Q56.1 (C), R90.1, R94.1
unnamed: Q56.2 (B), R87.2
unnamed: Q56.3 (E), Q57.1 (C)
unnamed: Q57.2 (B), R88.2
unnamed: Q58.1 (C), R95.1, R98.1
unnamed: Q58.2 (B), R91.2
unnamed: Q58.3 (E), Q59.1 (C)
unnamed: Q59.2 (B), R92.2
unnamed: Q60.1 (C), R96.1, R102.1
unnamed: Q60.2 (B), R93.2
unnamed: Q61.1 (C), R97.1, R103.1
unnamed: Q61.2 (B), R94.2
unnamed: Q62.1 (C), R99.1, R108.1
unnamed: Q62.2 (B), R98.2
unnamed: Q63.1 (C), Q64.1 (C), Q67.1 (C), Q70.1 (C), R110.1, R113.1
unnamed: Q63.2 (B), R100.2
unnamed: Q64.2 (B), R101.2
unnamed: Q65.1 (C), Q68.1 (C), Q71.1 (C), R111.1, R115.1
unnamed: Q65.2 (B), R104.2
unnamed: Q66.1 (C), Q69.1 (C), Q72.1 (C), R112.1, R116.1
unnamed: Q66.2 (B), R107.2
unnamed: Q67.2 (B), R102.2
unnamed: Q68.2 (B), R105.2
unnamed: Q69.2 (B), R108.2
unnamed: Q70.2 (B), R103.2
unnamed: Q71.2 (B), R106.2
unnamed: Q72.2 (B), R109.2
unnamed: Q73.1 (C), R117.1, R121.1
unnamed: Q73.2 (B), R113.2
unnamed: Q74.1 (C), R118.1, R122.1
unnamed: Q74.2 (B), R114.2
unnamed: Q75.1 (C), R119.1, R123.1
unnamed: Q75.2 (B), R115.2
unnamed: Q76.1 (C), R120.1, R126.1
unnamed: Q76.2 (B), R116.2
unnamed: Q77.1 (C), R127.1, R130.1
unnamed: Q77.2 (B), R121.2
unnamed: Q77.3 (E), Q78.1 (C)
unnamed: Q78.2 (B), R122.2
unnamed: Q79.1 (C), R128.1, R131.1
unnamed: Q79.2 (B), R123.2
unnamed: Q79.3 (E), Q80.1 (C)
unnamed: Q80.2 (B), R124.2
unnamed: Q81.1 (C), R129.1, R132.1
unnamed: Q81.2 (B), R125.2
unnamed: Q81.3 (E), Q82.1 (C)
unnamed: Q82.2 (B), R126.2
unnamed: Q83.1 (C), R133.1, R136.1
unnamed: Q83.2 (B), R130.2
unnamed: Q84.1 (C), R134.1, R137.1
unnamed: Q84.2 (B), R131.2
unnamed: Q85.1 (C), R135.1, R138.1
unnamed: Q85.2 (B), R132.2
unnamed: Q86.1 (C), Q87.1 (C), Q88.1 (C), R139.1, R140.1
unnamed: Q86.2 (B), R136.2
unnamed: Q87.2 (B), R137.2
unnamed: Q88.2 (B), R138.2
unnamed: Q89.2 (B), R140.2
OR: R106.1, R107.1
ORC: R101.1, R104.1
OUT: Q89.1 (C), R141.1
RR: R81.1, R86.1, R91.1, R124.1
XNOR: R41.1, R88.1

Notes on the sheet:
LOGIC UNIT
OR 3
NOT
AND
OR 4
