okforth/1bICU/MUX.kicad_sch

## KiCad design MUX.kicad_sch (2026-10-11)

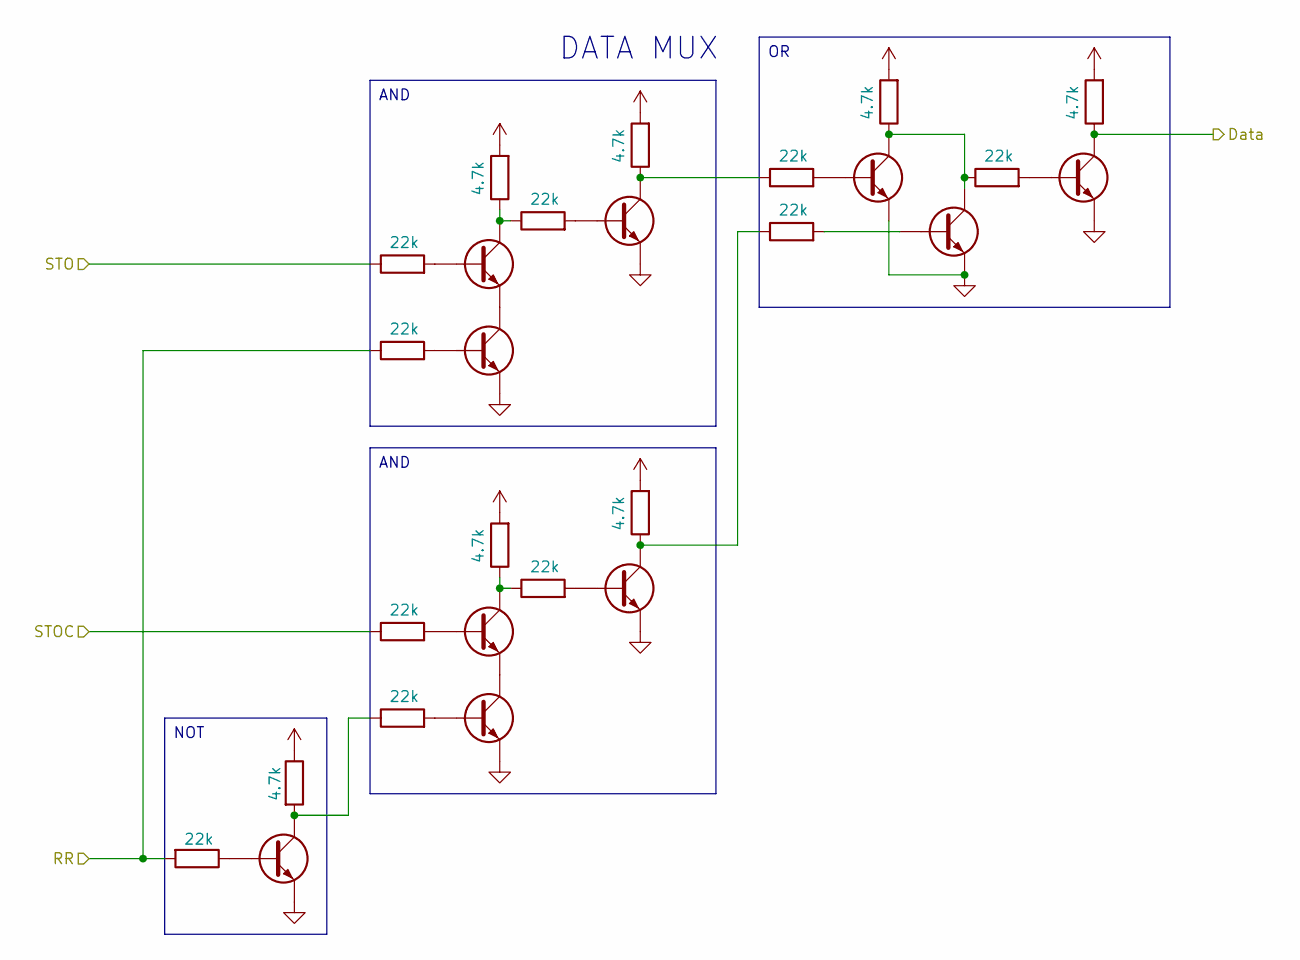
[picture p15: schematic MUX.kicad_sch]

Parts:
Q147, Q148, Q149, Q150, Q151, Q152, Q153, Q154, Q155, Q156: NPN
R281, R282, R284, R286, R287, R289, R291, R293, R294, R296: 22k
R283, R285, R288, R290, R292, R295, R297: 4.7k

Connections:
+5V: R283.2, R285.2, R288.2, R290.2, R295.2, R297.2
Data: Q152.1 (C), R290.1
GND: Q148.3 (E), Q149.3 (E), Q150.3 (E), Q151.3 (E), Q152.3 (E), Q153.3 (E), Q155.3 (E), Q156.3 (E)
unnamed: Q147.1 (C), R283.1, R284.1
unnamed: Q147.2 (B), R281.2
unnamed: Q147.3 (E), Q148.1 (C)
unnamed: Q148.2 (B), R282.2
unnamed: Q149.1 (C), R285.1, R286.1
unnamed: Q149.2 (B), R284.2
unnamed: Q150.1 (C), Q151.1 (C), R288.1, R289.1
unnamed: Q150.2 (B), R286.2
unnamed: Q151.2 (B), R287.2
unnamed: Q152.2 (B), R289.2
unnamed: Q153.1 (C), R292.2, R294.1
unnamed: Q153.2 (B), R291.1
unnamed: Q154.1 (C), R295.1, R296.1
unnamed: Q154.2 (B), R293.2
unnamed: Q154.3 (E), Q155.1 (C)
unnamed: Q155.2 (B), R294.2
unnamed: Q156.1 (C), R287.1, R297.1
unnamed: Q156.2 (B), R296.2
RR: R282.1, R291.2
STO: R281.1
STOC: R293.1
VCC: R292.1

Notes on the sheet:
DATA MUX
AND
NOT
