okforth/1bICU/NOP Unit.kicad_sch

## KiCad design NOP Unit.kicad_sch (2026-10-11)

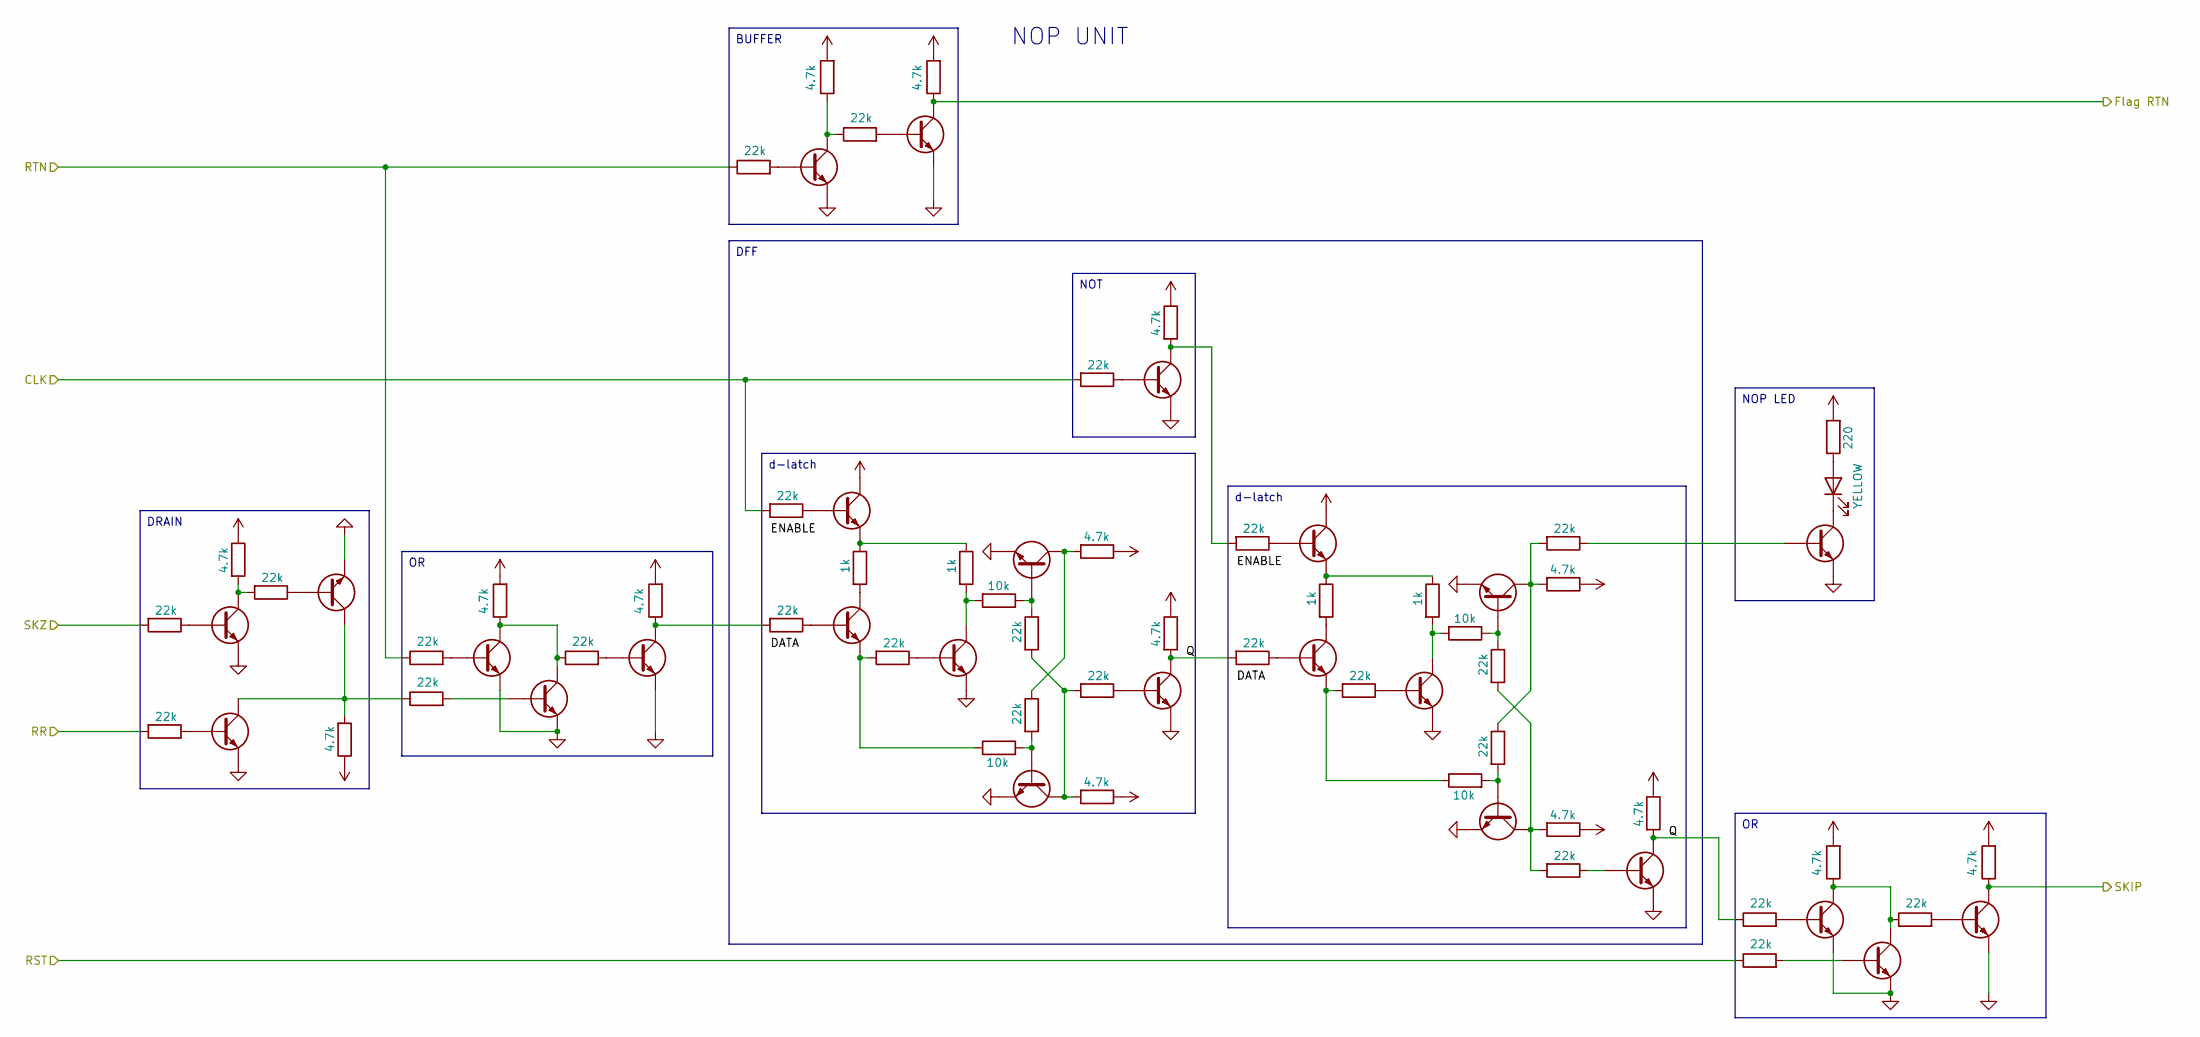
[picture p16: schematic NOP Unit.kicad_sch]

Parts:
D3: YELLOW
Q113, Q115, Q165, Q166, Q167, Q168, Q169, Q170, Q245, Q246, Q261, Q262, Q263, Q264, Q265, Q266, Q267, Q268, Q269, Q270, Q272, Q299, Q300, Q301, Q338: NPN
R213, R215, R280, R300, R302, R304, R305, R307, R474, R475, R507, R511, R512, R513, R515, R519, R520, R522, R526, R527, R529, R531, R569, R570, R572: 22k
R214, R220, R301, R303, R306, R308, R514, R516, R517, R518, R528, R530, R533, R571, R573: 4.7k
R506, R508, R521, R523: 1k
R509, R510, R524, R525: 10k
R664: 220

Connections:
+5V: R214.2, R220.2, R301.2, R303.2, R306.2, R308.2
CLK: R474.2, R513.2
Flag RTN: Q115.1 (C), R220.1
GND: Q113.3 (E), Q115.3 (E), Q165.3 (E), Q166.3 (E), Q167.3 (E), Q168.3 (E), Q169.3 (E), Q170.3 (E), Q261.3 (E), Q262.3 (E), Q263.3 (E), Q264.3 (E), Q265.3 (E), Q268.3 (E), Q269.3 (E), Q270.3 (E), Q272.3 (E), Q299.3 (E), Q300.3 (E), Q301.3 (E), Q338.3 (E)
unnamed: D3.1 (K), Q338.1 (C)
unnamed: D3.2 (A), R664.1
unnamed: Q113.1 (C), R214.1, R215.1
unnamed: Q113.2 (B), R213.2
unnamed: Q115.2 (B), R215.2
unnamed: Q165.1 (C), Q166.1 (C), R301.1, R302.1
unnamed: Q165.2 (B), R280.2
unnamed: Q166.2 (B), R300.2
unnamed: Q167.1 (C), R303.1, R475.2
unnamed: Q167.2 (B), R302.2
unnamed: Q168.1 (C), Q169.1 (C), R306.1, R307.1
unnamed: Q168.2 (B), R304.2
unnamed: Q169.2 (B), R305.2
unnamed: Q170.2 (B), R307.2
unnamed: Q245.2 (B), R474.1
unnamed: Q245.3 (E), R506.1, R508.1
unnamed: Q246.1 (C), R506.2
unnamed: Q246.2 (B), R475.1
unnamed: Q246.3 (E), R507.2, R510.1
unnamed: Q261.1 (C), R508.2, R509.2
unnamed: Q261.2 (B), R507.1
unnamed: Q262.1 (C), R512.1, R514.2
unnamed: Q262.2 (B), R509.1, R511.1
unnamed: Q263.1 (C), R511.2, R515.2, R516.2
unnamed: Q263.2 (B), R510.2, R512.2
unnamed: Q264.1 (C), R517.2, R519.2
unnamed: Q264.2 (B), R513.1
unnamed: Q265.2 (B), R515.1
unnamed: Q266.2 (B), R519.1
unnamed: Q266.3 (E), R521.1, R523.1
unnamed: Q267.1 (C), R521.2
unnamed: Q267.2 (B), R520.1
unnamed: Q267.3 (E), R522.2, R525.1
unnamed: Q268.1 (C), R523.2, R524.2
unnamed: Q268.2 (B), R522.1
unnamed: Q269.1 (C), R527.1, R528.2, R529.2
unnamed: Q269.2 (B), R524.1, R526.1
unnamed: Q270.1 (C), R526.2, R530.2, R531.2
unnamed: Q270.2 (B), R525.2, R527.2
unnamed: Q272.2 (B), R531.1
unnamed: Q299.1 (C), R571.2, R572.2
unnamed: Q299.2 (B), R569.1
unnamed: Q300.1 (C), Q301.1 (C), R300.1, R573.2
unnamed: Q300.2 (B), R570.1
unnamed: Q301.2 (B), R572.1
unnamed: Q338.2 (B), R529.1
Q: Q265.1 (C), Q272.1 (C), R304.1, R518.2, R520.2, R533.2
RR: R570.2
RST: R305.1
RTN: R213.1, R280.1
SKIP: Q170.1 (C), R308.1
SKZ: R569.2
VCC: Q245.1 (C), Q266.1 (C), R514.1, R516.1, R517.1, R518.1, R528.1, R530.1, R533.1, R571.1, R573.1, R664.2

Notes on the sheet:
NOP UNIT
NOT
d-latch
DFF
DRAIN
NOP LED
BUFFER
