okforth/1bICU/NOPEN.kicad_sch

## KiCad design NOPEN.kicad_sch (2026-10-11)

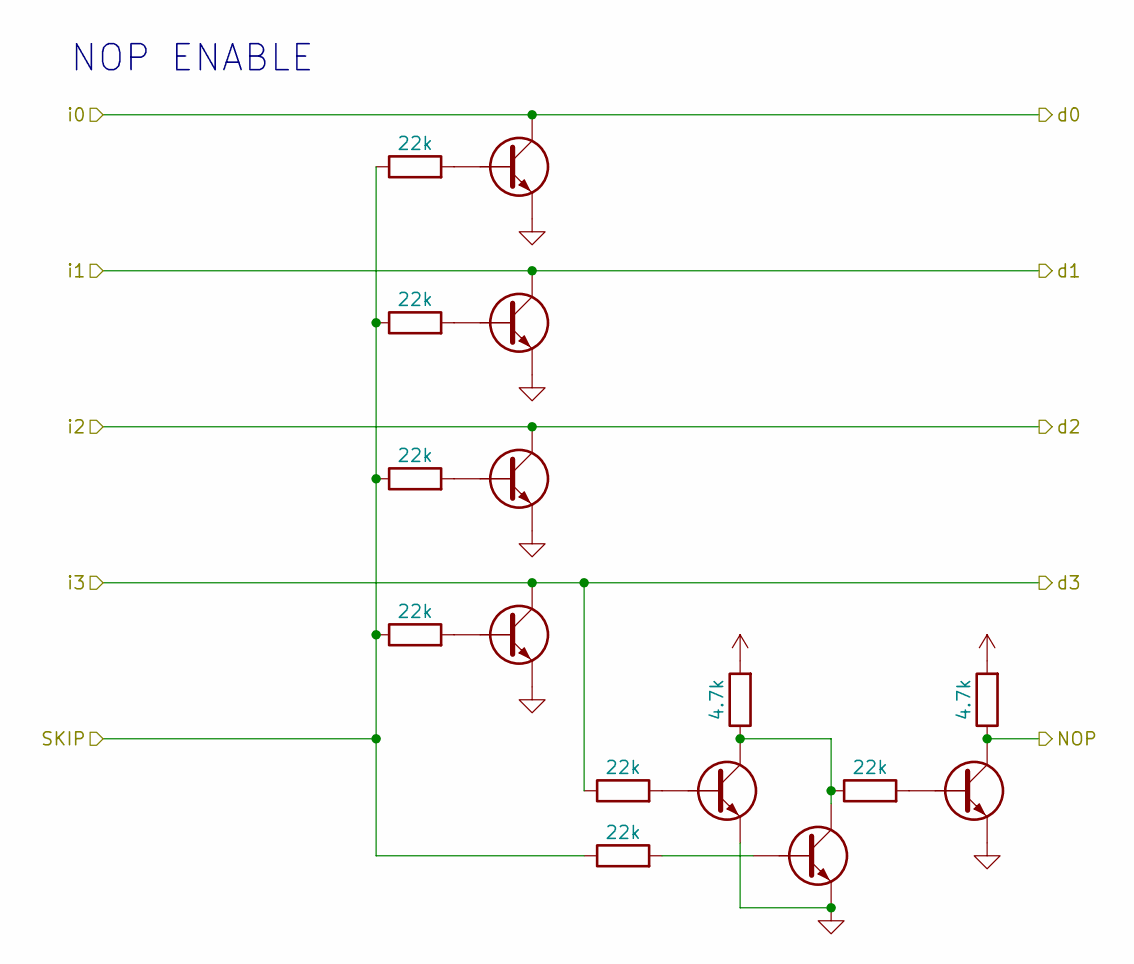
[picture p17: schematic NOPEN.kicad_sch]

Parts:
Q110, Q112, Q114, Q118, Q161, Q163, Q164: NPN
R197, R199, R201, R203, R216, R217, R218: 22k
R298, R299: 4.7k

Connections:
GND: Q110.3 (E), Q112.3 (E), Q114.3 (E), Q118.3 (E), Q161.3 (E), Q163.3 (E), Q164.3 (E)
NOP: Q164.1 (C), R299.1
unnamed: Q110.2 (B), R197.2
unnamed: Q112.2 (B), R199.2
unnamed: Q114.2 (B), R201.2
unnamed: Q118.2 (B), R203.2
unnamed: Q161.1 (C), Q163.1 (C), R218.1, R298.1
unnamed: Q161.2 (B), R216.2
unnamed: Q163.2 (B), R217.2
unnamed: Q164.2 (B), R218.2
SKIP: R197.1, R199.1, R201.1, R203.1, R216.1
VCC: R298.2, R299.2
d0: Q110.1 (C)
d1: Q112.1 (C)
d2: Q114.1 (C)
d3: Q118.1 (C), R217.1

Notes on the sheet:
NOP ENABLE
