okforth/1bICU/NOT.kicad_sch

## KiCad design NOT.kicad_sch (2026-10-11)

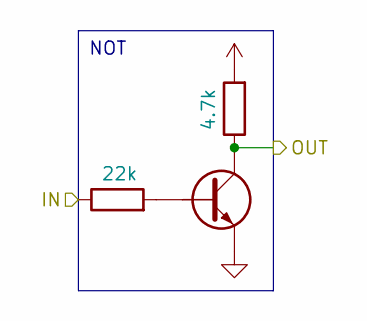
[picture p18: schematic NOT.kicad_sch]

Parts:
Q106: NPN
R202: 22k
R204: 4.7k

Connections:
+5V: R204.2
GND: Q106.3 (E)
IN: R202.1
unnamed: Q106.2 (B), R202.2
OUT: Q106.1 (C), R204.1

Notes on the sheet:
NOT
