okforth/1bICU/OEN Unit.kicad_sch

## KiCad design OEN Unit.kicad_sch (2026-10-11)

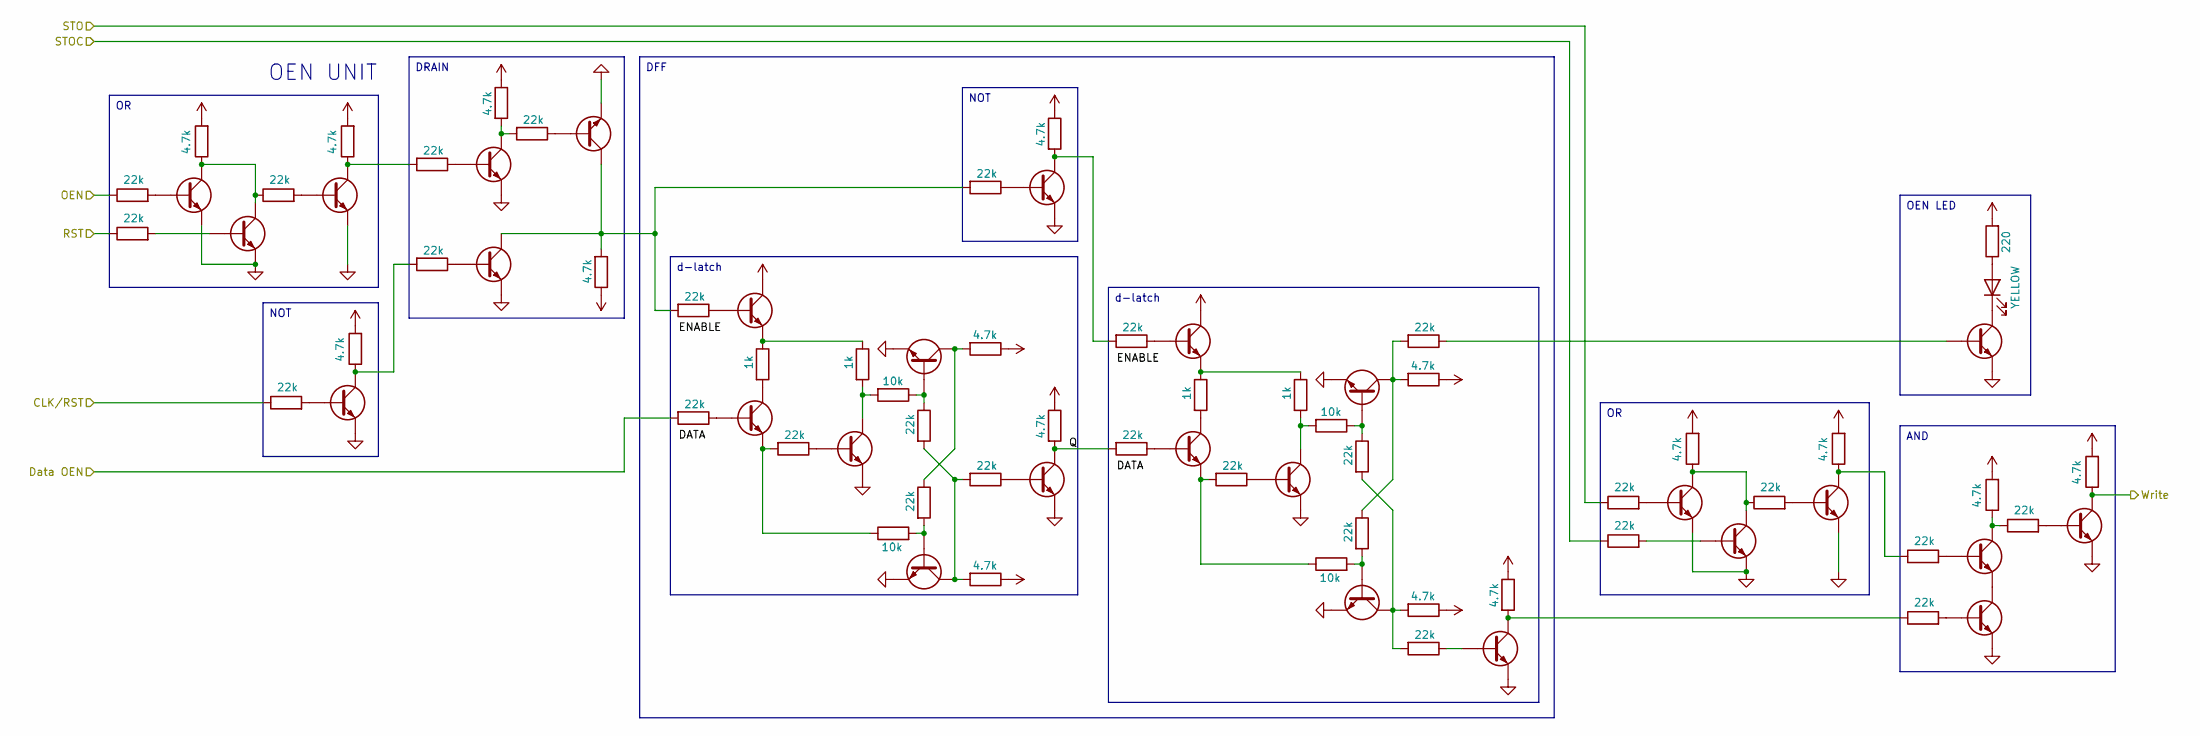
[picture p19: schematic OEN Unit.kicad_sch]

Parts:
D2: YELLOW
Q107, Q173, Q174, Q175, Q176, Q177, Q178, Q286, Q291, Q296, Q326, Q327, Q328, Q329, Q330, Q331, Q332, Q333, Q334, Q335, Q336, Q337, Q339, Q340, Q341, Q342, Q343: NPN
R205, R314, R315, R317, R319, R320, R322, R546, R558, R566, R636, R637, R639, R643, R644, R645, R647, R651, R652, R654, R658, R659, R661, R663, R666, R667, R669: 22k
R206, R316, R318, R321, R323, R551, R559, R646, R648, R649, R650, R660, R662, R665, R668, R670: 4.7k
R638, R640, R653, R655: 1k
R641, R642, R656, R657: 10k
R672: 220

Connections:
+5V: R206.2, R316.2, R318.2, R321.2, R323.2, R668.2, R670.2
CLK/RST: R205.1
Data OEN: R637.2
GND: Q107.3 (E), Q173.3 (E), Q174.3 (E), Q175.3 (E), Q176.3 (E), Q177.3 (E), Q178.3 (E), Q286.3 (E), Q291.3 (E), Q296.3 (E), Q328.3 (E), Q329.3 (E), Q330.3 (E), Q331.3 (E), Q332.3 (E), Q335.3 (E), Q336.3 (E), Q337.3 (E), Q339.3 (E), Q341.3 (E), Q342.3 (E), Q343.3 (E)
unnamed: D2.1 (K), Q343.1 (C)
unnamed: D2.2 (A), R672.1
unnamed: Q107.1 (C), R206.1, R566.2
unnamed: Q107.2 (B), R205.2
unnamed: Q173.1 (C), Q174.1 (C), R316.1, R317.1
unnamed: Q173.2 (B), R314.2
unnamed: Q174.2 (B), R315.2
unnamed: Q175.1 (C), R318.1, R546.2
unnamed: Q175.2 (B), R317.2
unnamed: Q176.1 (C), Q177.1 (C), R321.1, R322.1
unnamed: Q176.2 (B), R319.2
unnamed: Q177.2 (B), R320.2
unnamed: Q178.1 (C), R323.1, R666.1
unnamed: Q178.2 (B), R322.2
unnamed: Q286.1 (C), R551.2, R558.2
unnamed: Q286.2 (B), R546.1
unnamed: Q291.1 (C), Q296.1 (C), R559.2, R636.2, R645.2
unnamed: Q291.2 (B), R558.1
unnamed: Q296.2 (B), R566.1
unnamed: Q326.2 (B), R636.1
unnamed: Q326.3 (E), R638.1, R640.1
unnamed: Q327.1 (C), R638.2
unnamed: Q327.2 (B), R637.1
unnamed: Q327.3 (E), R639.2, R642.1
unnamed: Q328.1 (C), R640.2, R641.2
unnamed: Q328.2 (B), R639.1
unnamed: Q329.1 (C), R644.1, R646.2
unnamed: Q329.2 (B), R641.1, R643.1
unnamed: Q330.1 (C), R643.2, R647.2, R648.2
unnamed: Q330.2 (B), R642.2, R644.2
unnamed: Q331.1 (C), R649.2, R651.2
unnamed: Q331.2 (B), R645.1
unnamed: Q332.2 (B), R647.1
unnamed: Q333.2 (B), R651.1
unnamed: Q333.3 (E), R653.1, R655.1
unnamed: Q334.1 (C), R653.2
unnamed: Q334.2 (B), R652.1
unnamed: Q334.3 (E), R654.2, R657.1
unnamed: Q335.1 (C), R655.2, R656.2
unnamed: Q335.2 (B), R654.1
unnamed: Q336.1 (C), R659.1, R660.2, R661.2
unnamed: Q336.2 (B), R656.1, R658.1
unnamed: Q337.1 (C), R658.2, R662.2, R663.2
unnamed: Q337.2 (B), R657.2, R659.2
unnamed: Q339.1 (C), R665.2, R667.1
unnamed: Q339.2 (B), R663.1
unnamed: Q340.1 (C), R668.1, R669.1
unnamed: Q340.2 (B), R666.2
unnamed: Q340.3 (E), Q341.1 (C)
unnamed: Q341.2 (B), R667.2
unnamed: Q342.2 (B), R669.2
unnamed: Q343.2 (B), R661.1
OEN: R314.1
Q: Q332.1 (C), R650.2, R652.2
RST: R315.1
STO: R319.1
STOC: R320.1
VCC: Q326.1 (C), Q333.1 (C), R551.1, R559.1, R646.1, R648.1, R649.1, R650.1, R660.1, R662.1, R665.1, R672.2
Write: Q342.1 (C), R670.1

Notes on the sheet:
OEN UNIT
AND
DRAIN
NOT
OEN LED
DFF
d-latch
