okforth/1bICU/OR.kicad_sch

## KiCad design OR.kicad_sch (2026-10-11)

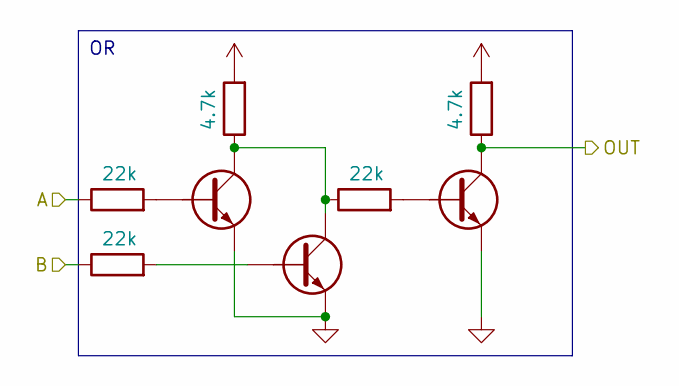
[picture p20: schematic OR.kicad_sch]

Parts:
Q142, Q144, Q145: NPN
R235, R236, R238: 22k
R237, R239: 4.7k

Connections:
+5V: R237.2, R239.2
A: R235.1
B: R236.1
GND: Q142.3 (E), Q144.3 (E), Q145.3 (E)
unnamed: Q142.1 (C), Q144.1 (C), R237.1, R238.1
unnamed: Q142.2 (B), R235.2
unnamed: Q144.2 (B), R236.2
unnamed: Q145.2 (B), R238.2
OUT: Q145.1 (C), R239.1
