okforth/1bICU/RR Unit.kicad_sch

## KiCad design RR Unit.kicad_sch (2026-10-11)

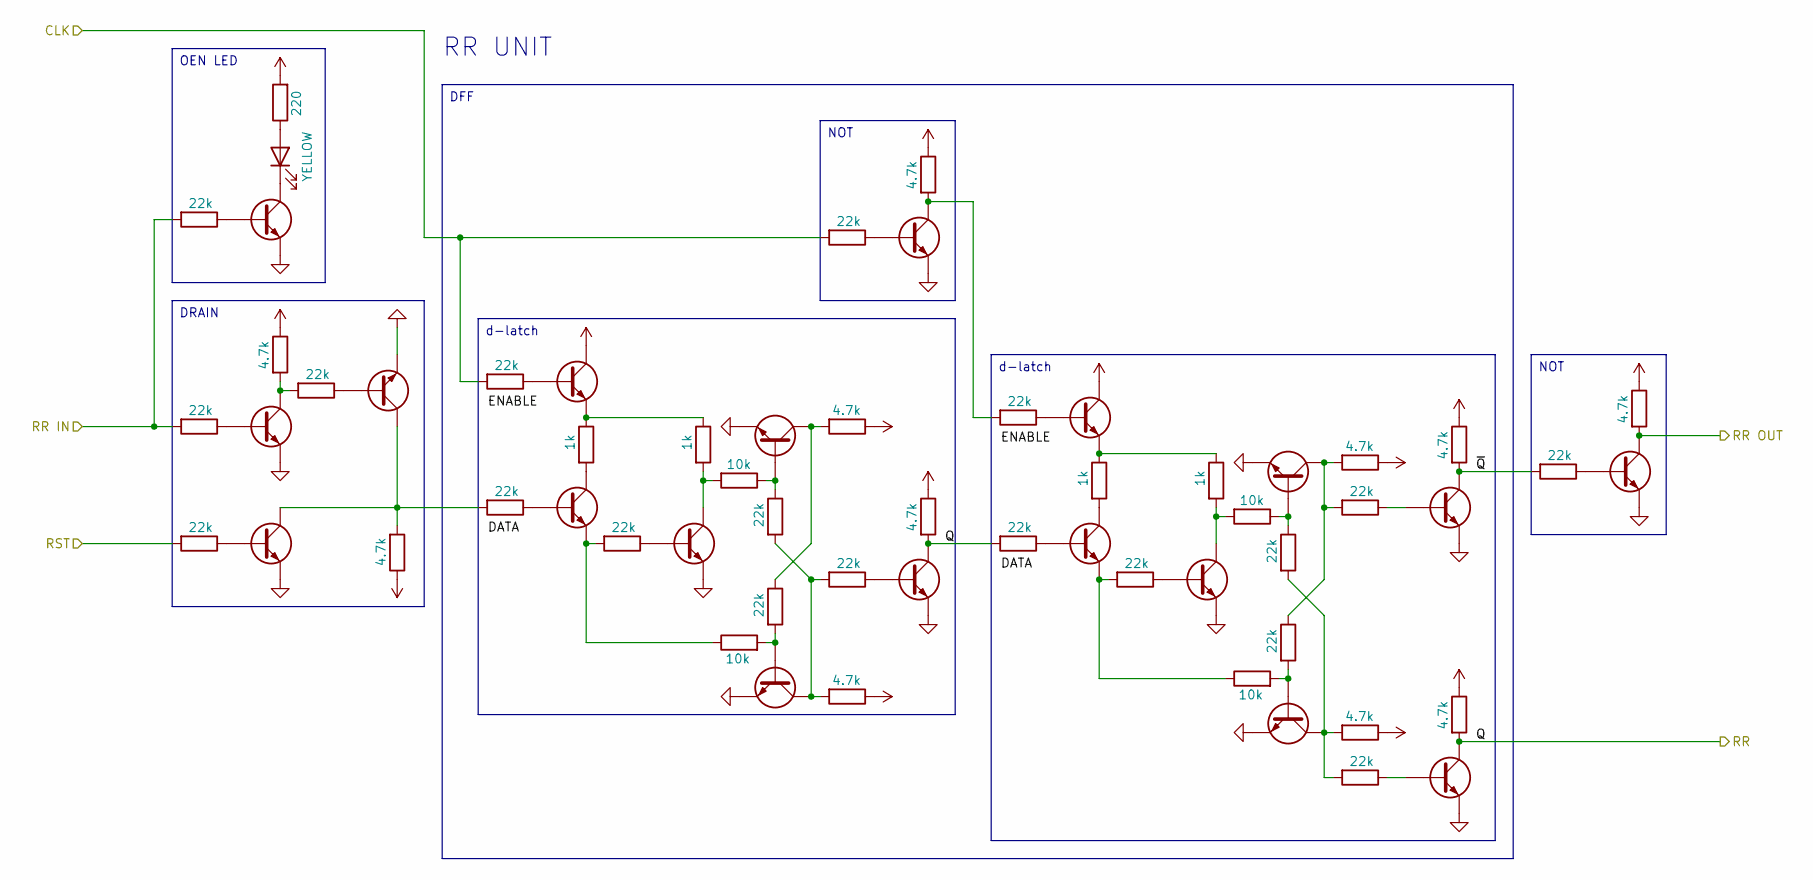
[picture p21: schematic RR Unit.kicad_sch]

Parts:
D4: YELLOW
Q142, Q144, Q145, Q146, Q157, Q158, Q159, Q160, Q162, Q184, Q185, Q186, Q187, Q188, Q190, Q288, Q293, Q298, Q349: NPN
R272, R274, R277, R335, R336, R337, R339, R343, R344, R346, R350, R351, R353, R355, R360, R548, R549, R562, R568: 22k
R276, R278, R345, R347: 1k
R279, R334, R348, R349: 10k
R338, R340, R341, R342, R352, R354, R356, R357, R361, R553, R563: 4.7k
R680: 220

Connections:
CLK: R272.2, R337.2
GND: Q145.3 (E), Q146.3 (E), Q157.3 (E), Q158.3 (E), Q159.3 (E), Q184.3 (E), Q185.3 (E), Q186.3 (E), Q187.3 (E), Q188.3 (E), Q190.3 (E), Q288.3 (E), Q293.3 (E), Q298.3 (E), Q349.3 (E)
unnamed: D4.1 (K), Q349.1 (C)
unnamed: D4.2 (A), R680.1
unnamed: Q142.2 (B), R272.1
unnamed: Q142.3 (E), R276.1, R278.1
unnamed: Q144.1 (C), R276.2
unnamed: Q144.2 (B), R274.1
unnamed: Q144.3 (E), R277.2, R334.1
unnamed: Q145.1 (C), R278.2, R279.2
unnamed: Q145.2 (B), R277.1
unnamed: Q146.1 (C), R336.1, R338.2
unnamed: Q146.2 (B), R279.1, R335.1
unnamed: Q157.1 (C), R335.2, R339.2, R340.2
unnamed: Q157.2 (B), R334.2, R336.2
unnamed: Q158.1 (C), R341.2, R343.2
unnamed: Q158.2 (B), R337.1
unnamed: Q159.2 (B), R339.1
unnamed: Q160.2 (B), R343.1
unnamed: Q160.3 (E), R345.1, R347.1
unnamed: Q162.1 (C), R345.2
unnamed: Q162.2 (B), R344.1
unnamed: Q162.3 (E), R346.2, R349.1
unnamed: Q184.1 (C), R347.2, R348.2
unnamed: Q184.2 (B), R346.1
unnamed: Q185.1 (C), R351.1, R352.2, R353.2
unnamed: Q185.2 (B), R348.1, R350.1
unnamed: Q186.1 (C), R350.2, R354.2, R355.2
unnamed: Q186.2 (B), R349.2, R351.2
unnamed: Q187.2 (B), R353.1
unnamed: Q188.2 (B), R355.1
unnamed: Q190.2 (B), R360.1
unnamed: Q288.1 (C), R553.2, R562.2
unnamed: Q288.2 (B), R548.1
unnamed: Q293.1 (C), Q298.1 (C), R274.2, R563.2
unnamed: Q293.2 (B), R562.1
unnamed: Q298.2 (B), R568.1
unnamed: Q349.2 (B), R549.1
Q: Q159.1 (C), Q188.1 (C), R342.2, R344.2, R357.2
RR IN: R548.2, R549.2
RR OUT: Q190.1 (C), R361.2
RST: R568.2
VCC: Q142.1 (C), Q160.1 (C), R338.1, R340.1, R341.1, R342.1, R352.1, R354.1, R356.1, R357.1, R361.1, R553.1, R563.1, R680.2
~Q: Q187.1 (C), R356.2, R360.2

Notes on the sheet:
RR UNIT
DFF
OEN LED
DRAIN
NOT
d-latch
