okforth/1bICU/Skip Unit.kicad_sch

## KiCad design Skip Unit.kicad_sch (2026-10-11)

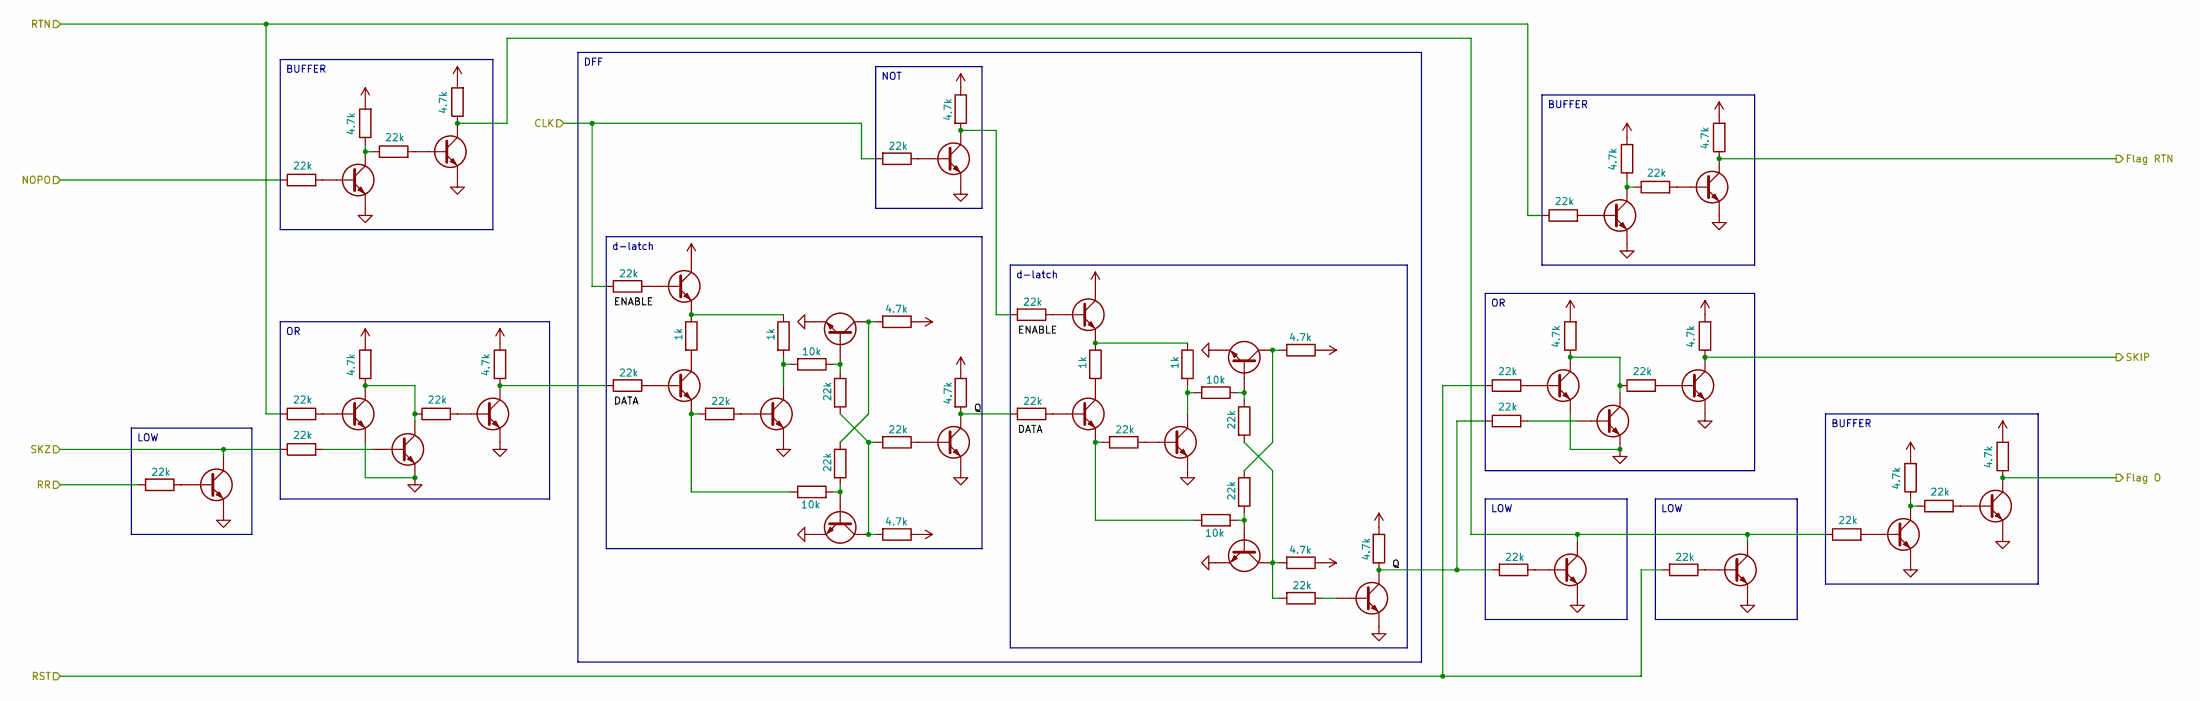
[picture p22: schematic Skip Unit.kicad_sch]

Parts:
Q113, Q115, Q116, Q117, Q163, Q164, Q165, Q166, Q167, Q168, Q169, Q170, Q263, Q264, Q265, Q266, Q267, Q268, Q269, Q270, Q271, Q272, Q273, Q274, Q276, Q277, Q278, Q279: NPN
R213, R216, R218, R280, R298, R300, R303, R306, R307, R309, R311, R313, R508, R509, R511, R515, R516, R517, R519, R523, R524, R526, R530, R531, R535, R538, R539, R540: 22k
R214, R217, R299, R301, R302, R305, R308, R310, R312, R314, R518, R520, R521, R522, R532, R534, R537: 4.7k
R510, R512, R525, R527: 1k
R513, R514, R528, R529: 10k

Connections:
+5V: R214.2, R217.2, R299.2, R301.2, R302.2, R305.2, R308.2, R310.2, R312.2, R314.2
CLK: R508.2, R517.2
Flag O: Q117.1 (C), R305.1
Flag RTN: Q170.1 (C), R314.1
GND: Q113.3 (E), Q115.3 (E), Q116.3 (E), Q117.3 (E), Q163.3 (E), Q164.3 (E), Q165.3 (E), Q166.3 (E), Q167.3 (E), Q168.3 (E), Q169.3 (E), Q170.3 (E), Q265.3 (E), Q266.3 (E), Q267.3 (E), Q268.3 (E), Q269.3 (E), Q272.3 (E), Q273.3 (E), Q274.3 (E), Q276.3 (E), Q277.3 (E), Q278.3 (E), Q279.3 (E)
NOPO: R213.1
unnamed: Q113.1 (C), R214.1, R216.1
unnamed: Q113.2 (B), R213.2
unnamed: Q115.1 (C), Q278.1 (C), Q279.1 (C), R217.1, R218.1
unnamed: Q115.2 (B), R216.2
unnamed: Q116.1 (C), R302.1, R303.1
unnamed: Q116.2 (B), R218.2
unnamed: Q117.2 (B), R303.2
unnamed: Q163.1 (C), Q164.1 (C), R299.1, R300.1
unnamed: Q163.2 (B), R280.2
unnamed: Q164.2 (B), R298.2
unnamed: Q165.1 (C), R301.1, R509.2
unnamed: Q165.2 (B), R300.2
unnamed: Q166.1 (C), Q167.1 (C), R308.1, R309.1
unnamed: Q166.2 (B), R306.2
unnamed: Q167.2 (B), R307.2
unnamed: Q168.2 (B), R309.2
unnamed: Q169.1 (C), R312.1, R313.1
unnamed: Q169.2 (B), R311.2
unnamed: Q170.2 (B), R313.2
unnamed: Q263.2 (B), R508.1
unnamed: Q263.3 (E), R510.1, R512.1
unnamed: Q264.1 (C), R510.2
unnamed: Q264.2 (B), R509.1
unnamed: Q264.3 (E), R511.2, R514.1
unnamed: Q265.1 (C), R512.2, R513.2
unnamed: Q265.2 (B), R511.1
unnamed: Q266.1 (C), R516.1, R518.2
unnamed: Q266.2 (B), R513.1, R515.1
unnamed: Q267.1 (C), R515.2, R519.2, R520.2
unnamed: Q267.2 (B), R514.2, R516.2
unnamed: Q268.1 (C), R521.2, R523.2
unnamed: Q268.2 (B), R517.1
unnamed: Q269.2 (B), R519.1
unnamed: Q270.2 (B), R523.1
unnamed: Q270.3 (E), R525.1, R527.1
unnamed: Q271.1 (C), R525.2
unnamed: Q271.2 (B), R524.1
unnamed: Q271.3 (E), R526.2, R529.1
unnamed: Q272.1 (C), R527.2, R528.2
unnamed: Q272.2 (B), R526.1
unnamed: Q273.1 (C), R531.1, R532.2
unnamed: Q273.2 (B), R528.1, R530.1
unnamed: Q274.1 (C), R530.2, R534.2, R535.2
unnamed: Q274.2 (B), R529.2, R531.2
unnamed: Q276.2 (B), R535.1
unnamed: Q277.2 (B), R538.1
unnamed: Q278.2 (B), R539.1
unnamed: Q279.2 (B), R540.1
Q: Q269.1 (C), Q276.1 (C), R307.1, R522.2, R524.2, R537.2, R539.2
RR: R538.2
RST: R306.1, R540.2
RTN: R280.1, R311.1
SKIP: Q168.1 (C), R310.1
SKZ: Q277.1 (C), R298.1
VCC: Q263.1 (C), Q270.1 (C), R518.1, R520.1, R521.1, R522.1, R532.1, R534.1, R537.1

Notes on the sheet:
d-latch
BUFFER
LOW
DFF
NOT
