okforth/1bICU/instruction_register_(manhattan).kicad_sch

## KiCad design instruction_register_(manhattan).kicad_sch (2026-10-11)

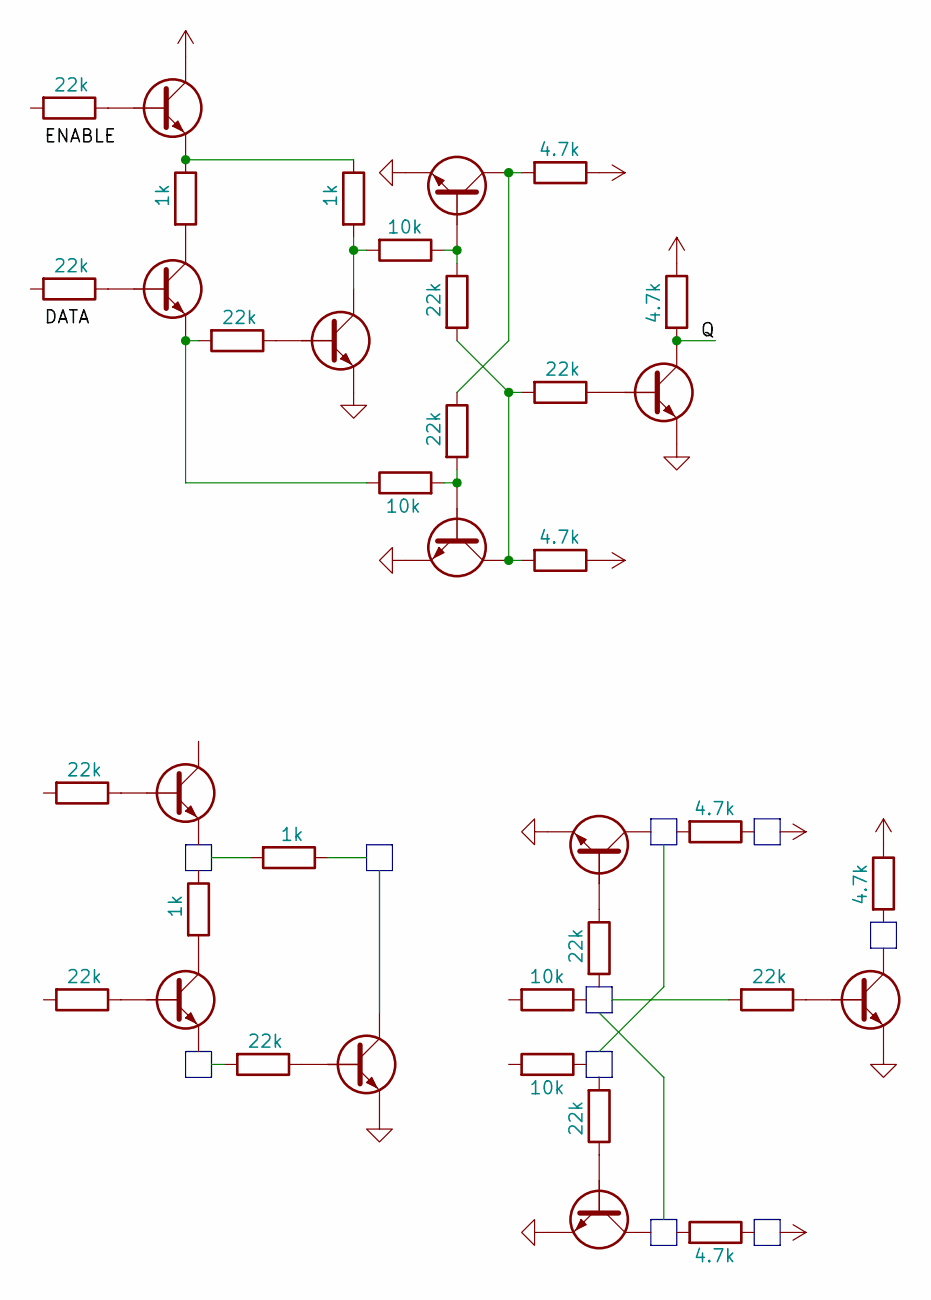
[picture p23: schematic instruction_register_(manhattan).kicad_sch]

Parts:
Q247, Q248, Q249, Q250, Q271, Q284, Q285, Q289, Q290, Q294, Q295, Q354: NPN
R476, R477, R478, R479, R480, R544, R555, R556, R565, R695, R698, R699: 22k
R532, R545, R557, R688: 1k
R550, R554, R690, R691: 10k
R564, R685, R687, R694, R696, R697: 4.7k

Connections:
GND: Q271.3 (E), Q284.3 (E), Q285.3 (E), Q289.3 (E), Q290.3 (E), Q294.3 (E), Q295.3 (E), Q354.3 (E)
unnamed: Q247.2 (B), R476.1
unnamed: Q247.3 (E), R532.1, R545.1
unnamed: Q248.1 (C), R532.2
unnamed: Q248.2 (B), R477.1
unnamed: Q248.3 (E), R544.2, R554.1
unnamed: Q249.2 (B), R478.1
unnamed: Q250.1 (C), R557.2
unnamed: Q250.2 (B), R479.1
unnamed: Q271.1 (C), R545.2, R550.2
unnamed: Q271.2 (B), R544.1
unnamed: Q284.1 (C), R556.1, R564.2
unnamed: Q284.2 (B), R550.1, R555.1
unnamed: Q285.1 (C), R555.2, R565.2, R685.2
unnamed: Q285.2 (B), R554.2, R556.2
unnamed: Q289.2 (B), R480.1
unnamed: Q290.2 (B), R565.1
unnamed: Q294.2 (B), R698.1
unnamed: Q295.2 (B), R699.1
unnamed: Q354.2 (B), R695.1
Q: Q290.1 (C), R687.2
VCC: Q247.1 (C), R564.1, R685.1, R687.1, R697.1
