okforth/1bICU/untitled.kicad_sch

## KiCad design untitled.kicad_sch (2026-10-11)

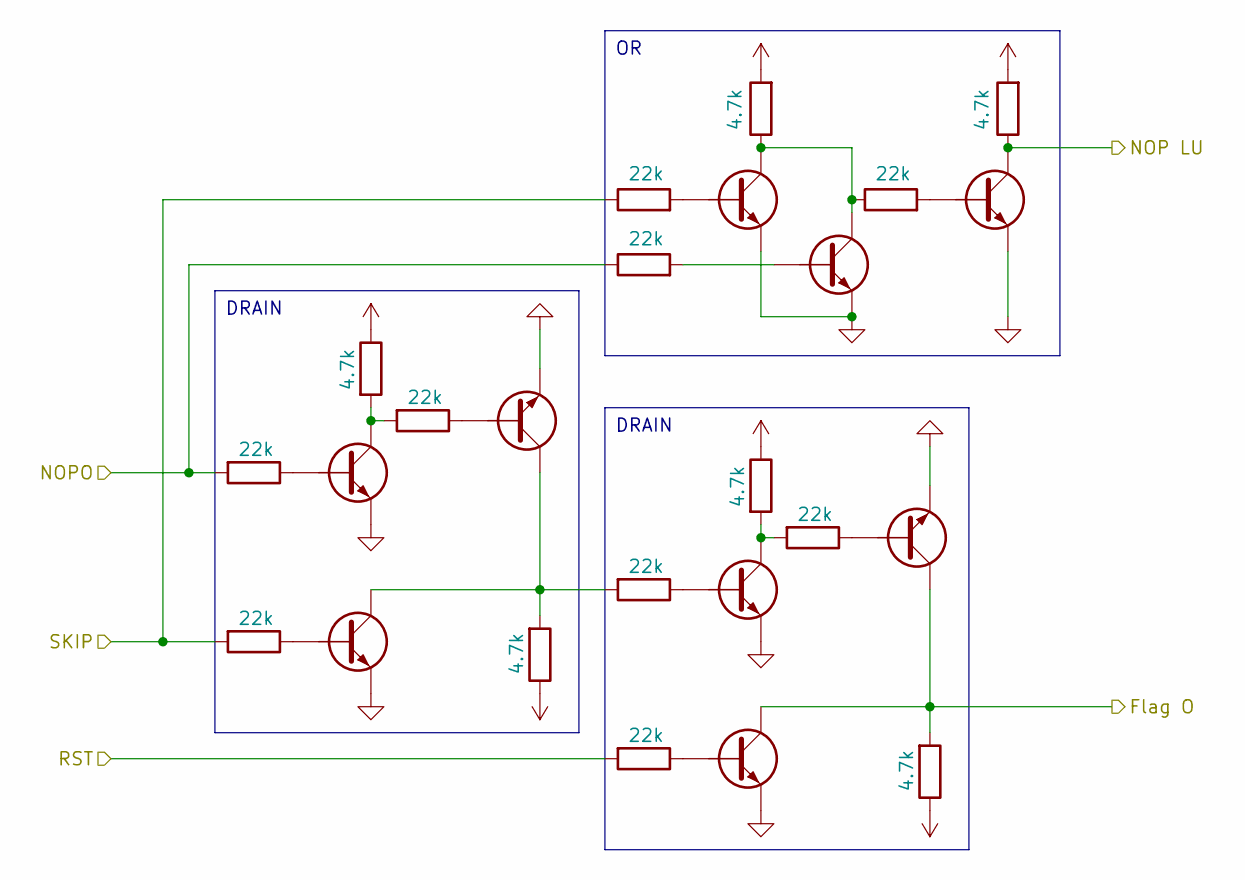
[picture p24: schematic untitled.kicad_sch]

Parts:
Q103, Q104, Q105, Q107, Q108, Q109, Q111, Q116, Q117: NPN
R194, R195, R198, R205, R206, R207, R208, R211, R212: 22k
R196, R200, R209, R210, R219, R221: 4.7k

Connections:
+5V: R209.2, R221.2
Flag O: Q109.1 (C), Q116.1 (C), R219.2
GND: Q103.3 (E), Q104.3 (E), Q105.3 (E), Q107.3 (E), Q108.3 (E), Q109.3 (E), Q111.3 (E), Q116.3 (E), Q117.3 (E)
NOP LU: Q117.1 (C), R221.1
NOPO: R194.2, R206.1
unnamed: Q103.1 (C), R196.2, R198.2
unnamed: Q103.2 (B), R194.1
unnamed: Q104.1 (C), Q105.1 (C), R200.2, R207.2
unnamed: Q104.2 (B), R195.1
unnamed: Q105.2 (B), R198.1
unnamed: Q107.1 (C), Q111.1 (C), R209.1, R212.1
unnamed: Q107.2 (B), R205.2
unnamed: Q108.1 (C), R210.2, R211.2
unnamed: Q108.2 (B), R207.1
unnamed: Q109.2 (B), R208.1
unnamed: Q111.2 (B), R206.2
unnamed: Q116.2 (B), R211.1
unnamed: Q117.2 (B), R212.2
RST: R208.2
SKIP: R195.2, R205.1
VCC: R196.1, R200.1, R210.1, R219.1

Notes on the sheet:
DRAIN
