okforth/1bICU/4x16 DEC/4x16 DEC.kicad_sch

## KiCad design 4x16 DEC/4x16 DEC.kicad_sch (2026-10-11)

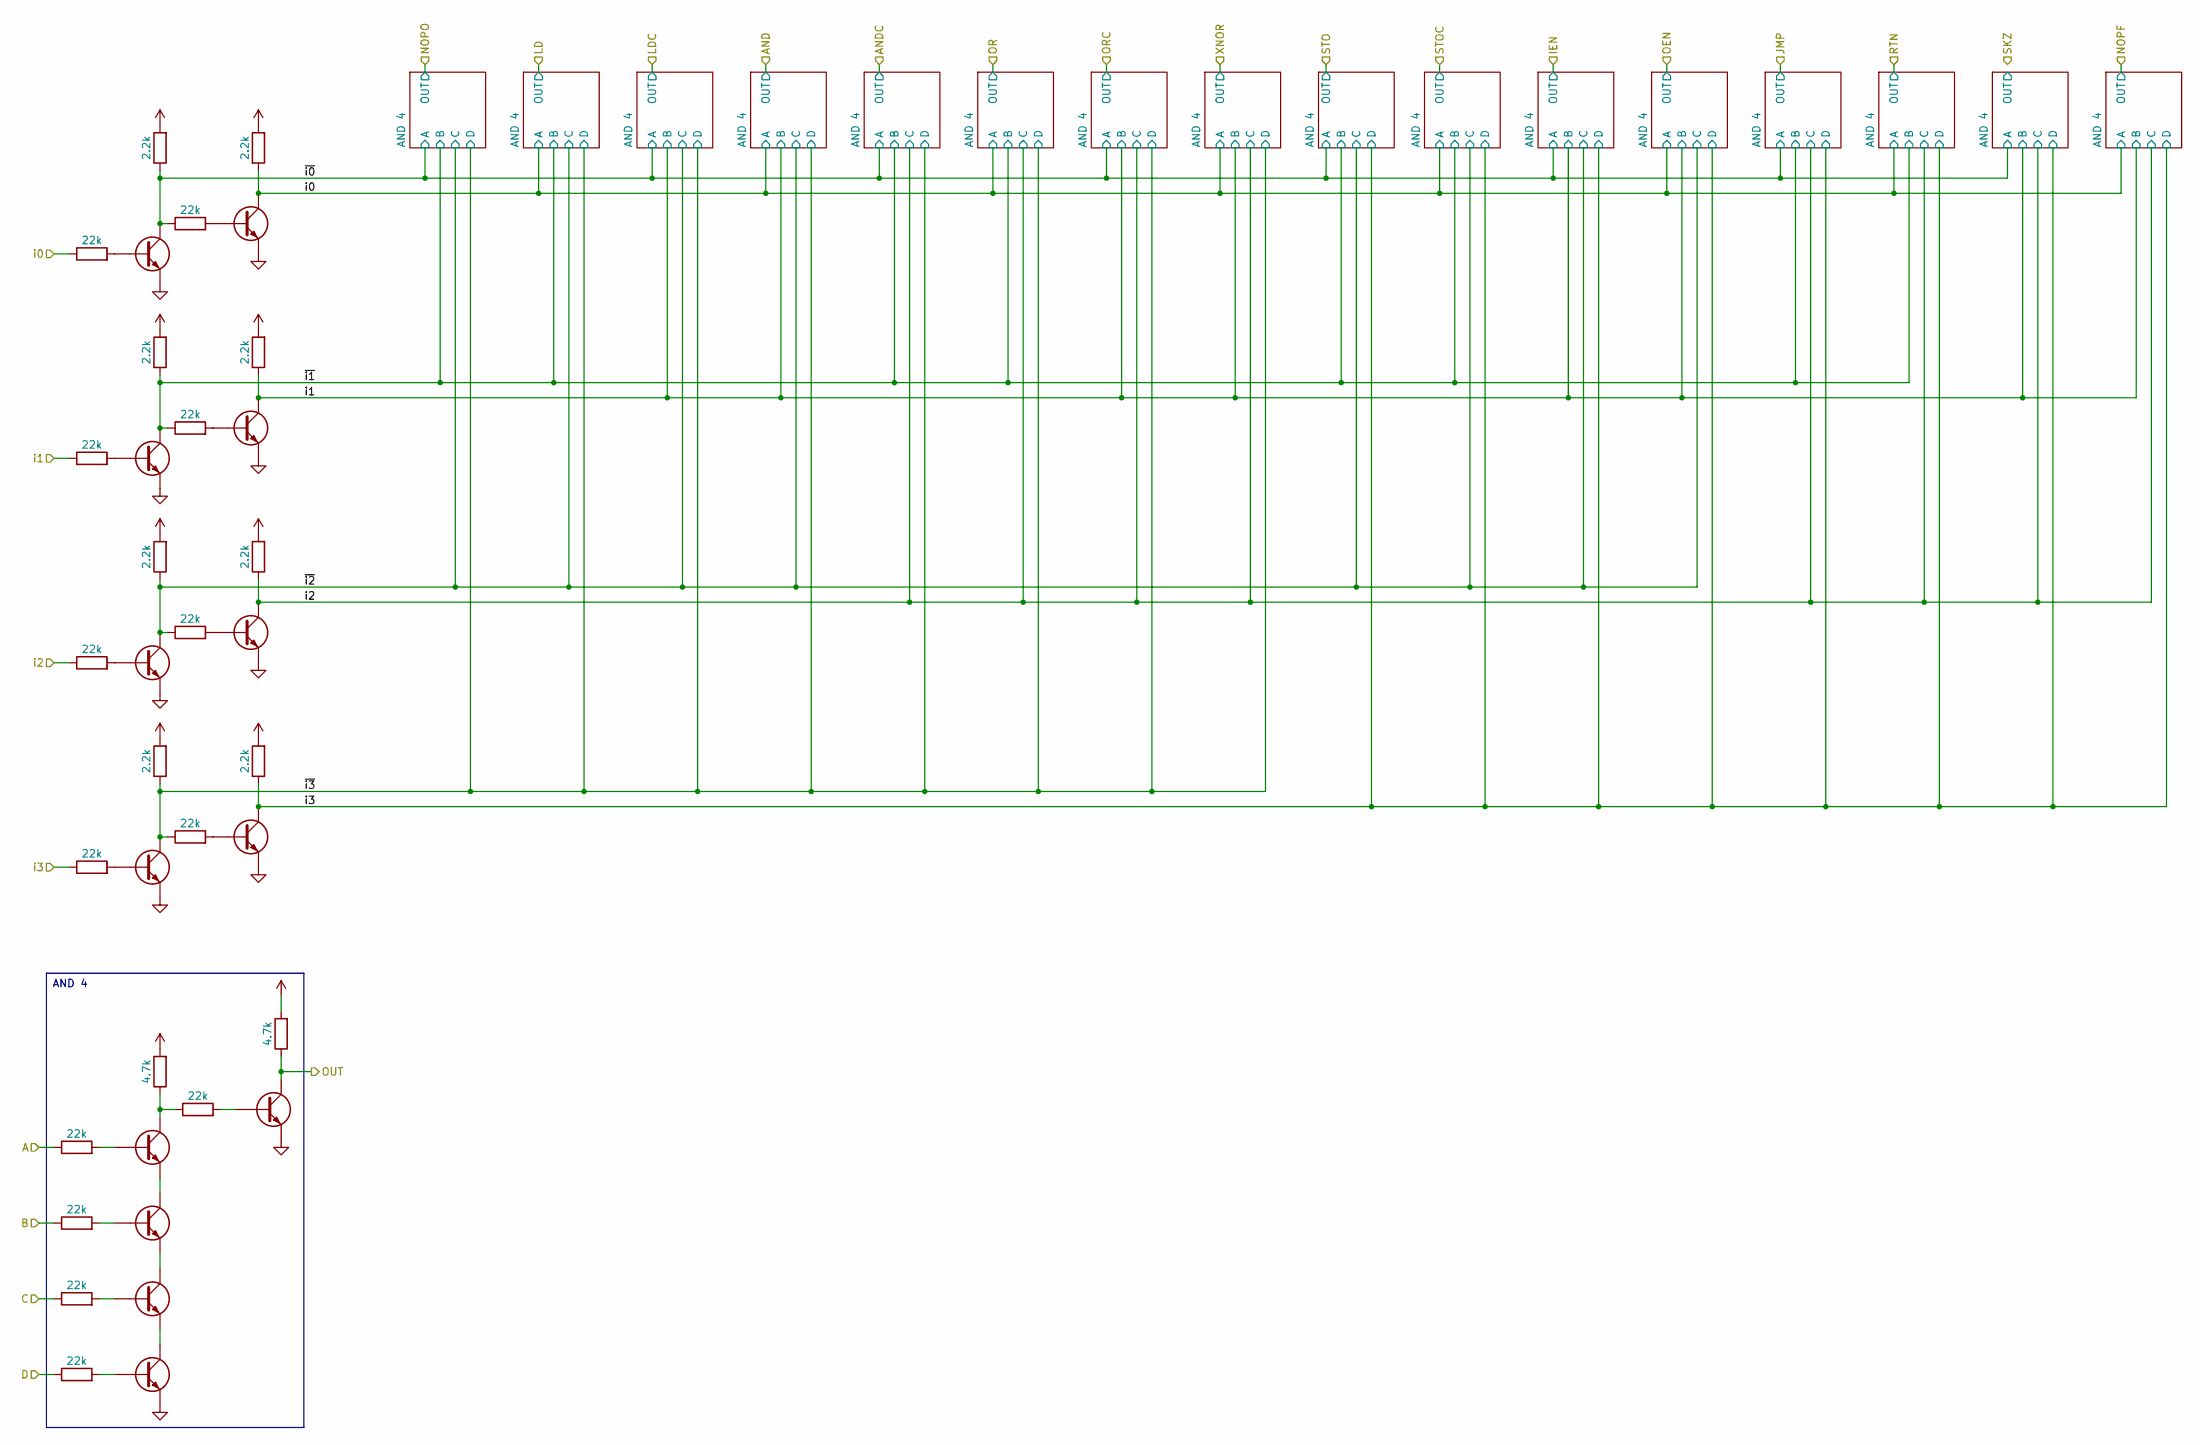
[picture p26: schematic 4x16 DEC.kicad_sch]

Parts:
Q7, Q82, Q83, Q84, Q85, Q86, Q87, Q88, Q89, Q90, Q91, Q92, Q93: NPN
R9, R116, R118, R120, R123, R124, R127, R128: 2.2k
R114, R115, R117, R119, R121, R122, R125, R126, R129, R130, R131, R132, R134: 22k
R133, R135: 4.7k

Connections:
A: R129.1
B: R130.1
C: R131.1
D: R132.1
GND: Q7.3 (E), Q82.3 (E), Q83.3 (E), Q84.3 (E), Q85.3 (E), Q86.3 (E), Q87.3 (E), Q88.3 (E), Q92.3 (E), Q93.3 (E)
unnamed: Q7.2 (B), R115.2
unnamed: Q82.2 (B), R114.2
unnamed: Q83.2 (B), R117.2
unnamed: Q84.2 (B), R119.2
unnamed: Q85.2 (B), R121.2
unnamed: Q86.2 (B), R122.2
unnamed: Q87.2 (B), R125.2
unnamed: Q88.2 (B), R126.2
unnamed: Q89.1 (C), R133.1, R134.1
unnamed: Q89.2 (B), R129.2
unnamed: Q89.3 (E), Q90.1 (C)
unnamed: Q90.2 (B), R130.2
unnamed: Q90.3 (E), Q91.1 (C)
unnamed: Q91.2 (B), R131.2
unnamed: Q91.3 (E), Q92.1 (C)
unnamed: Q92.2 (B), R132.2
unnamed: Q93.2 (B), R134.2
OUT: Q93.1 (C), R135.1
VCC: R9.2, R116.2, R118.2, R120.2, R123.2, R124.2, R127.2, R128.2, R133.2, R135.2
i0: Q7.1 (C), R114.1, R116.1
i1: Q84.1 (C), R117.1, R120.1
i2: Q87.1 (C), R121.1, R127.1
i3: Q88.1 (C), R122.1, R128.1
~i0: Q82.1 (C), R9.1, R115.1
~i1: Q83.1 (C), R118.1, R119.1
~i2: Q85.1 (C), R123.1, R125.1
~i3: Q86.1 (C), R124.1, R126.1

Notes on the sheet:
AND 4
