okforth/1bICU/4x16 DEC/AND 4.kicad_sch

## KiCad design 4x16 DEC/AND 4.kicad_sch (2026-10-11)

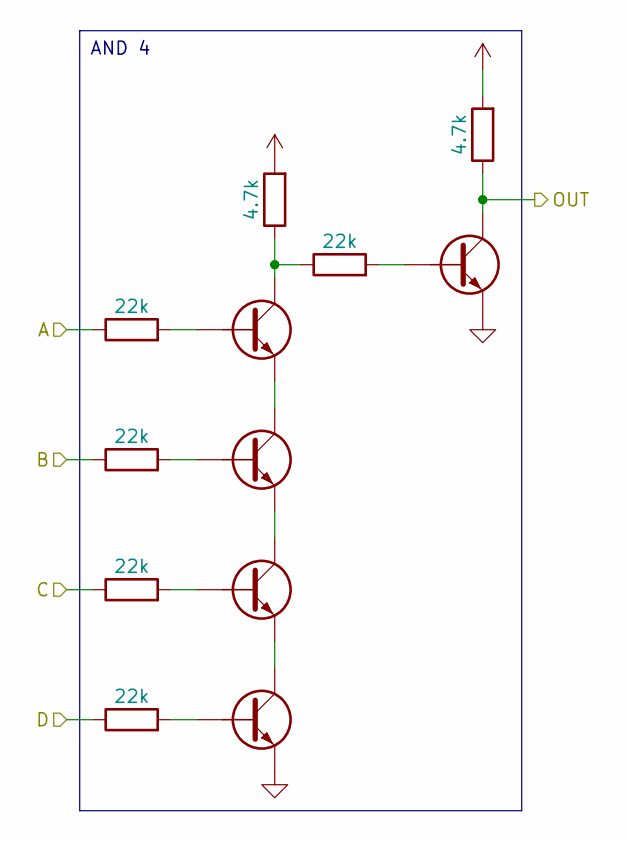
[picture p27: schematic AND 4.kicad_sch]

Parts:
Q32, Q33, Q34, Q35, Q36: NPN
R44, R45, R46, R47, R49: 22k
R48, R50: 4.7k

Connections:
A: R44.1
B: R45.1
C: R46.1
D: R47.1
GND: Q35.3 (E), Q36.3 (E)
unnamed: Q32.1 (C), R48.1, R49.1
unnamed: Q32.2 (B), R44.2
unnamed: Q32.3 (E), Q33.1 (C)
unnamed: Q33.2 (B), R45.2
unnamed: Q33.3 (E), Q34.1 (C)
unnamed: Q34.2 (B), R46.2
unnamed: Q34.3 (E), Q35.1 (C)
unnamed: Q35.2 (B), R47.2
unnamed: Q36.2 (B), R49.2
OUT: Q36.1 (C), R50.1
VCC: R48.2, R50.2

Notes on the sheet:
AND 4
