okforth/1bICU/DFF/d-latch.kicad_sch

## KiCad design DFF/d-latch.kicad_sch (2026-10-11)

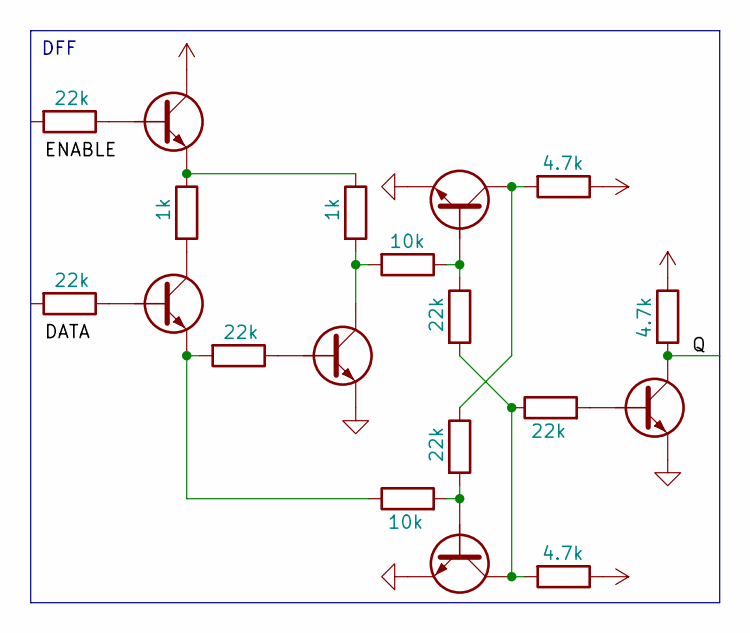
[picture p28: schematic d-latch.kicad_sch]

Parts:
Q1, Q2, Q3, Q4, Q5, Q6: NPN
R1, R2, R7, R8, R11, R13: 22k
R3, R6, R10: 4.7k
R4, R5: 10k
R9, R12: 1k

Connections:
GND: Q1.3 (E), Q2.3 (E), Q3.3 (E), Q6.3 (E)
unnamed: Q1.1 (C), R2.1, R3.2
unnamed: Q1.2 (B), R1.1, R4.1
unnamed: Q2.1 (C), R1.2, R6.2, R7.1
unnamed: Q2.2 (B), R2.2, R5.2
unnamed: Q3.1 (C), R4.2, R12.2
unnamed: Q3.2 (B), R8.1
unnamed: Q4.1 (C), R9.2
unnamed: Q4.2 (B), R11.1
unnamed: Q4.3 (E), R5.1, R8.2
unnamed: Q5.2 (B), R13.1
unnamed: Q5.3 (E), R9.1, R12.1
unnamed: Q6.2 (B), R7.2
Q: Q6.1 (C), R10.2
VCC: Q5.1 (C), R3.1, R6.1, R10.1

Notes on the sheet:
DFF
