okforth/1bICU/INST REG/INST REG.kicad_sch

## KiCad design INST REG/INST REG.kicad_sch (2026-10-11)

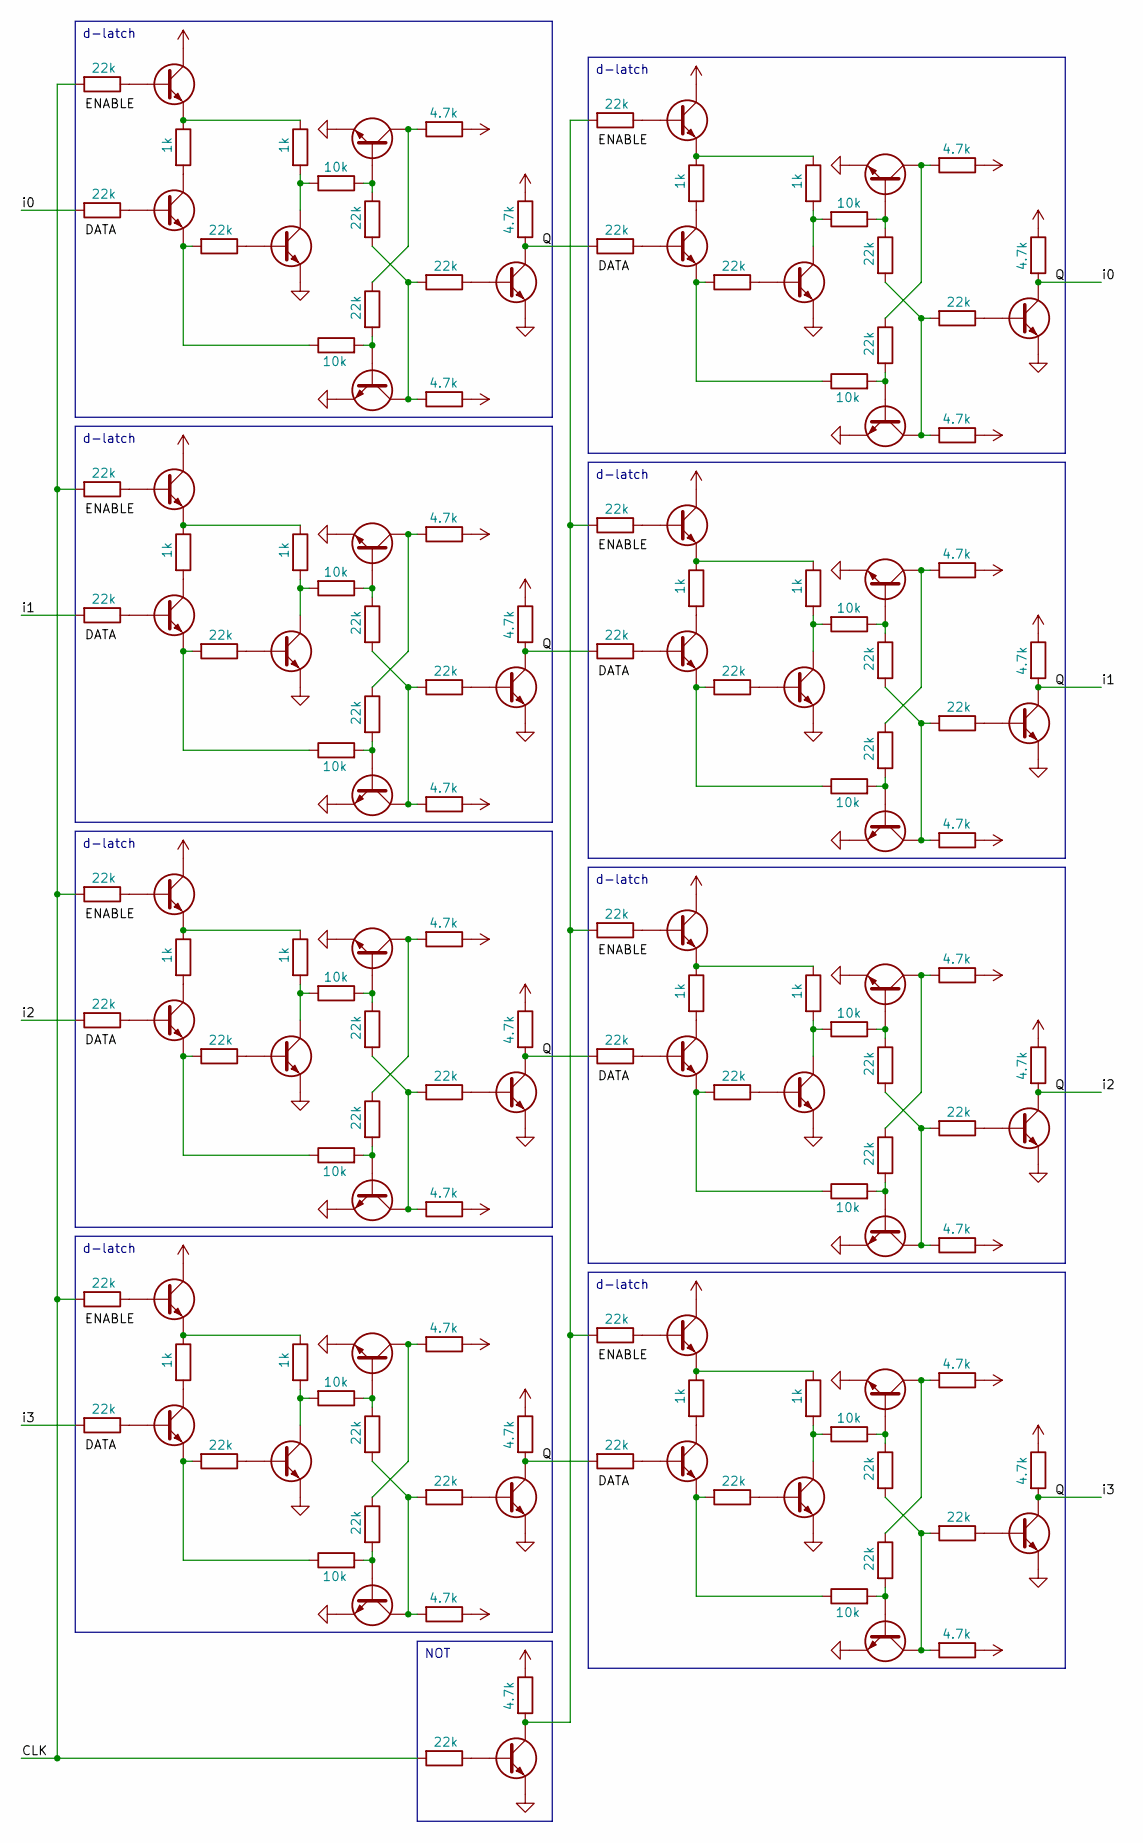
[picture p29: schematic INST REG.kicad_sch]

Parts:
Q1, Q2, Q3, Q4, Q5, Q6, Q7, Q8, Q9, Q10, Q11, Q12, Q13, Q14, Q15, Q16, Q17, Q18, Q19, Q20, Q21, Q22, Q23, Q24, Q25, Q26, Q27, Q28, Q29, Q30, Q31, Q32, Q33, Q34, Q35, Q36, Q37, Q38, Q39, Q40, Q41, Q42, Q43, Q44, Q45, Q46, Q47, Q48, Q49: NPN
R1, R2, R7, R8, R11, R13, R14, R15, R17, R21, R22, R24, R27, R28, R30, R34, R35, R37, R40, R41, R43, R47, R48, R50, R53, R54, R55, R56, R57, R58, R59, R60, R65, R66, R67, R68, R81, R82, R83, R84, R85, R86, R87, R88, R90, R93, R96, R99, R105: 22k
R3, R6, R10, R23, R25, R26, R36, R38, R39, R49, R51, R52, R89, R91, R92, R94, R95, R97, R98, R100, R101, R102, R103, R104, R106: 4.7k
R4, R5, R19, R20, R32, R33, R45, R46, R73, R74, R75, R76, R77, R78, R79, R80: 10k
R9, R12, R16, R18, R29, R31, R42, R44, R61, R62, R63, R64, R69, R70, R71, R72: 1k

Connections:
CLK: R13.2, R14.2, R27.2, R40.2, R105.2
GND: Q1.3 (E), Q2.3 (E), Q3.3 (E), Q6.3 (E), Q9.3 (E), Q10.3 (E), Q11.3 (E), Q12.3 (E), Q15.3 (E), Q16.3 (E), Q17.3 (E), Q18.3 (E), Q21.3 (E), Q22.3 (E), Q23.3 (E), Q24.3 (E), Q33.3 (E), Q34.3 (E), Q35.3 (E), Q36.3 (E), Q37.3 (E), Q38.3 (E), Q39.3 (E), Q40.3 (E), Q41.3 (E), Q42.3 (E), Q43.3 (E), Q44.3 (E), Q45.3 (E), Q46.3 (E), Q47.3 (E), Q48.3 (E), Q49.3 (E)
unnamed: Q1.1 (C), R2.1, R3.2
unnamed: Q1.2 (B), R1.1, R4.1
unnamed: Q2.1 (C), R1.2, R6.2, R7.2
unnamed: Q2.2 (B), R2.2, R5.2
unnamed: Q3.1 (C), R4.2, R12.2
unnamed: Q3.2 (B), R8.1
unnamed: Q4.1 (C), R9.2
unnamed: Q4.2 (B), R11.1
unnamed: Q4.3 (E), R5.1, R8.2
unnamed: Q5.2 (B), R13.1
unnamed: Q5.3 (E), R9.1, R12.1
unnamed: Q6.2 (B), R7.1
unnamed: Q7.2 (B), R14.1
unnamed: Q7.3 (E), R16.1, R18.1
unnamed: Q8.1 (C), R16.2
unnamed: Q8.2 (B), R15.1
unnamed: Q8.3 (E), R17.2, R20.1
unnamed: Q9.1 (C), R18.2, R19.2
unnamed: Q9.2 (B), R17.1
unnamed: Q10.1 (C), R22.1, R23.2
unnamed: Q10.2 (B), R19.1, R21.1
unnamed: Q11.1 (C), R21.2, R24.2, R25.2
unnamed: Q11.2 (B), R20.2, R22.2
unnamed: Q12.2 (B), R24.1
unnamed: Q13.2 (B), R27.1
unnamed: Q13.3 (E), R29.1, R31.1
unnamed: Q14.1 (C), R29.2
unnamed: Q14.2 (B), R28.1
unnamed: Q14.3 (E), R30.2, R33.1
unnamed: Q15.1 (C), R31.2, R32.2
unnamed: Q15.2 (B), R30.1
unnamed: Q16.1 (C), R35.1, R36.2
unnamed: Q16.2 (B), R32.1, R34.1
unnamed: Q17.1 (C), R34.2, R37.2, R38.2
unnamed: Q17.2 (B), R33.2, R35.2
unnamed: Q18.2 (B), R37.1
unnamed: Q19.2 (B), R40.1
unnamed: Q19.3 (E), R42.1, R44.1
unnamed: Q20.1 (C), R42.2
unnamed: Q20.2 (B), R41.1
unnamed: Q20.3 (E), R43.2, R46.1
unnamed: Q21.1 (C), R44.2, R45.2
unnamed: Q21.2 (B), R43.1
unnamed: Q22.1 (C), R48.1, R49.2
unnamed: Q22.2 (B), R45.1, R47.1
unnamed: Q23.1 (C), R47.2, R50.2, R51.2
unnamed: Q23.2 (B), R46.2, R48.2
unnamed: Q24.2 (B), R50.1
unnamed: Q25.2 (B), R53.1
unnamed: Q25.3 (E), R61.1, R69.1
unnamed: Q26.1 (C), R61.2
unnamed: Q26.2 (B), R54.1
unnamed: Q26.3 (E), R65.2, R74.1
unnamed: Q27.2 (B), R55.1
unnamed: Q27.3 (E), R62.1, R70.1
unnamed: Q28.1 (C), R62.2
unnamed: Q28.2 (B), R56.1
unnamed: Q28.3 (E), R66.2, R76.1
unnamed: Q29.2 (B), R57.1
unnamed: Q29.3 (E), R63.1, R71.1
unnamed: Q30.1 (C), R63.2
unnamed: Q30.2 (B), R58.1
unnamed: Q30.3 (E), R67.2, R78.1
unnamed: Q31.2 (B), R59.1
unnamed: Q31.3 (E), R64.1, R72.1
unnamed: Q32.1 (C), R64.2
unnamed: Q32.2 (B), R60.1
unnamed: Q32.3 (E), R68.2, R80.1
unnamed: Q33.1 (C), R69.2, R73.2
unnamed: Q33.2 (B), R65.1
unnamed: Q34.1 (C), R70.2, R75.2
unnamed: Q34.2 (B), R66.1
unnamed: Q35.1 (C), R71.2, R77.2
unnamed: Q35.2 (B), R67.1
unnamed: Q36.1 (C), R72.2, R79.2
unnamed: Q36.2 (B), R68.1
unnamed: Q37.1 (C), R82.1, R89.2
unnamed: Q37.2 (B), R73.1, R81.1
unnamed: Q38.1 (C), R81.2, R90.2, R91.2
unnamed: Q38.2 (B), R74.2, R82.2
unnamed: Q39.1 (C), R84.1, R92.2
unnamed: Q39.2 (B), R75.1, R83.1
unnamed: Q40.1 (C), R83.2, R93.2, R94.2
unnamed: Q40.2 (B), R76.2, R84.2
unnamed: Q41.1 (C), R86.1, R95.2
unnamed: Q41.2 (B), R77.1, R85.1
unnamed: Q42.1 (C), R85.2, R96.2, R97.2
unnamed: Q42.2 (B), R78.2, R86.2
unnamed: Q43.1 (C), R88.1, R98.2
unnamed: Q43.2 (B), R79.1, R87.1
unnamed: Q44.1 (C), R87.2, R99.2, R100.2
unnamed: Q44.2 (B), R80.2, R88.2
unnamed: Q45.2 (B), R90.1
unnamed: Q46.2 (B), R93.1
unnamed: Q47.2 (B), R96.1
unnamed: Q48.2 (B), R99.1
unnamed: Q49.1 (C), R53.2, R55.2, R57.2, R59.2, R106.2
unnamed: Q49.2 (B), R105.1
VCC: Q5.1 (C), Q7.1 (C), Q13.1 (C), Q19.1 (C), Q25.1 (C), Q27.1 (C), Q29.1 (C), Q31.1 (C), R3.1, R6.1, R10.1, R23.1, R25.1, R26.1, R36.1, R38.1, R39.1, R49.1, R51.1, R52.1, R89.1, R91.1, R92.1, R94.1, R95.1, R97.1, R98.1, R100.1, R101.1, R102.1, R103.1, R104.1, R106.1
i0: Q6.1 (C), Q12.1 (C), Q18.1 (C), Q24.1 (C), Q45.1 (C), Q46.1 (C), Q47.1 (C), Q48.1 (C), R10.2, R11.2, R15.2, R26.2, R28.2, R39.2, R41.2, R52.2, R54.2, R56.2, R58.2, R60.2, R101.2, R102.2, R103.2, R104.2

Notes on the sheet:
NOT
d-latch
