okforth/1bICU/LU/LU.kicad_sch

## KiCad design LU/LU.kicad_sch (2026-10-11)

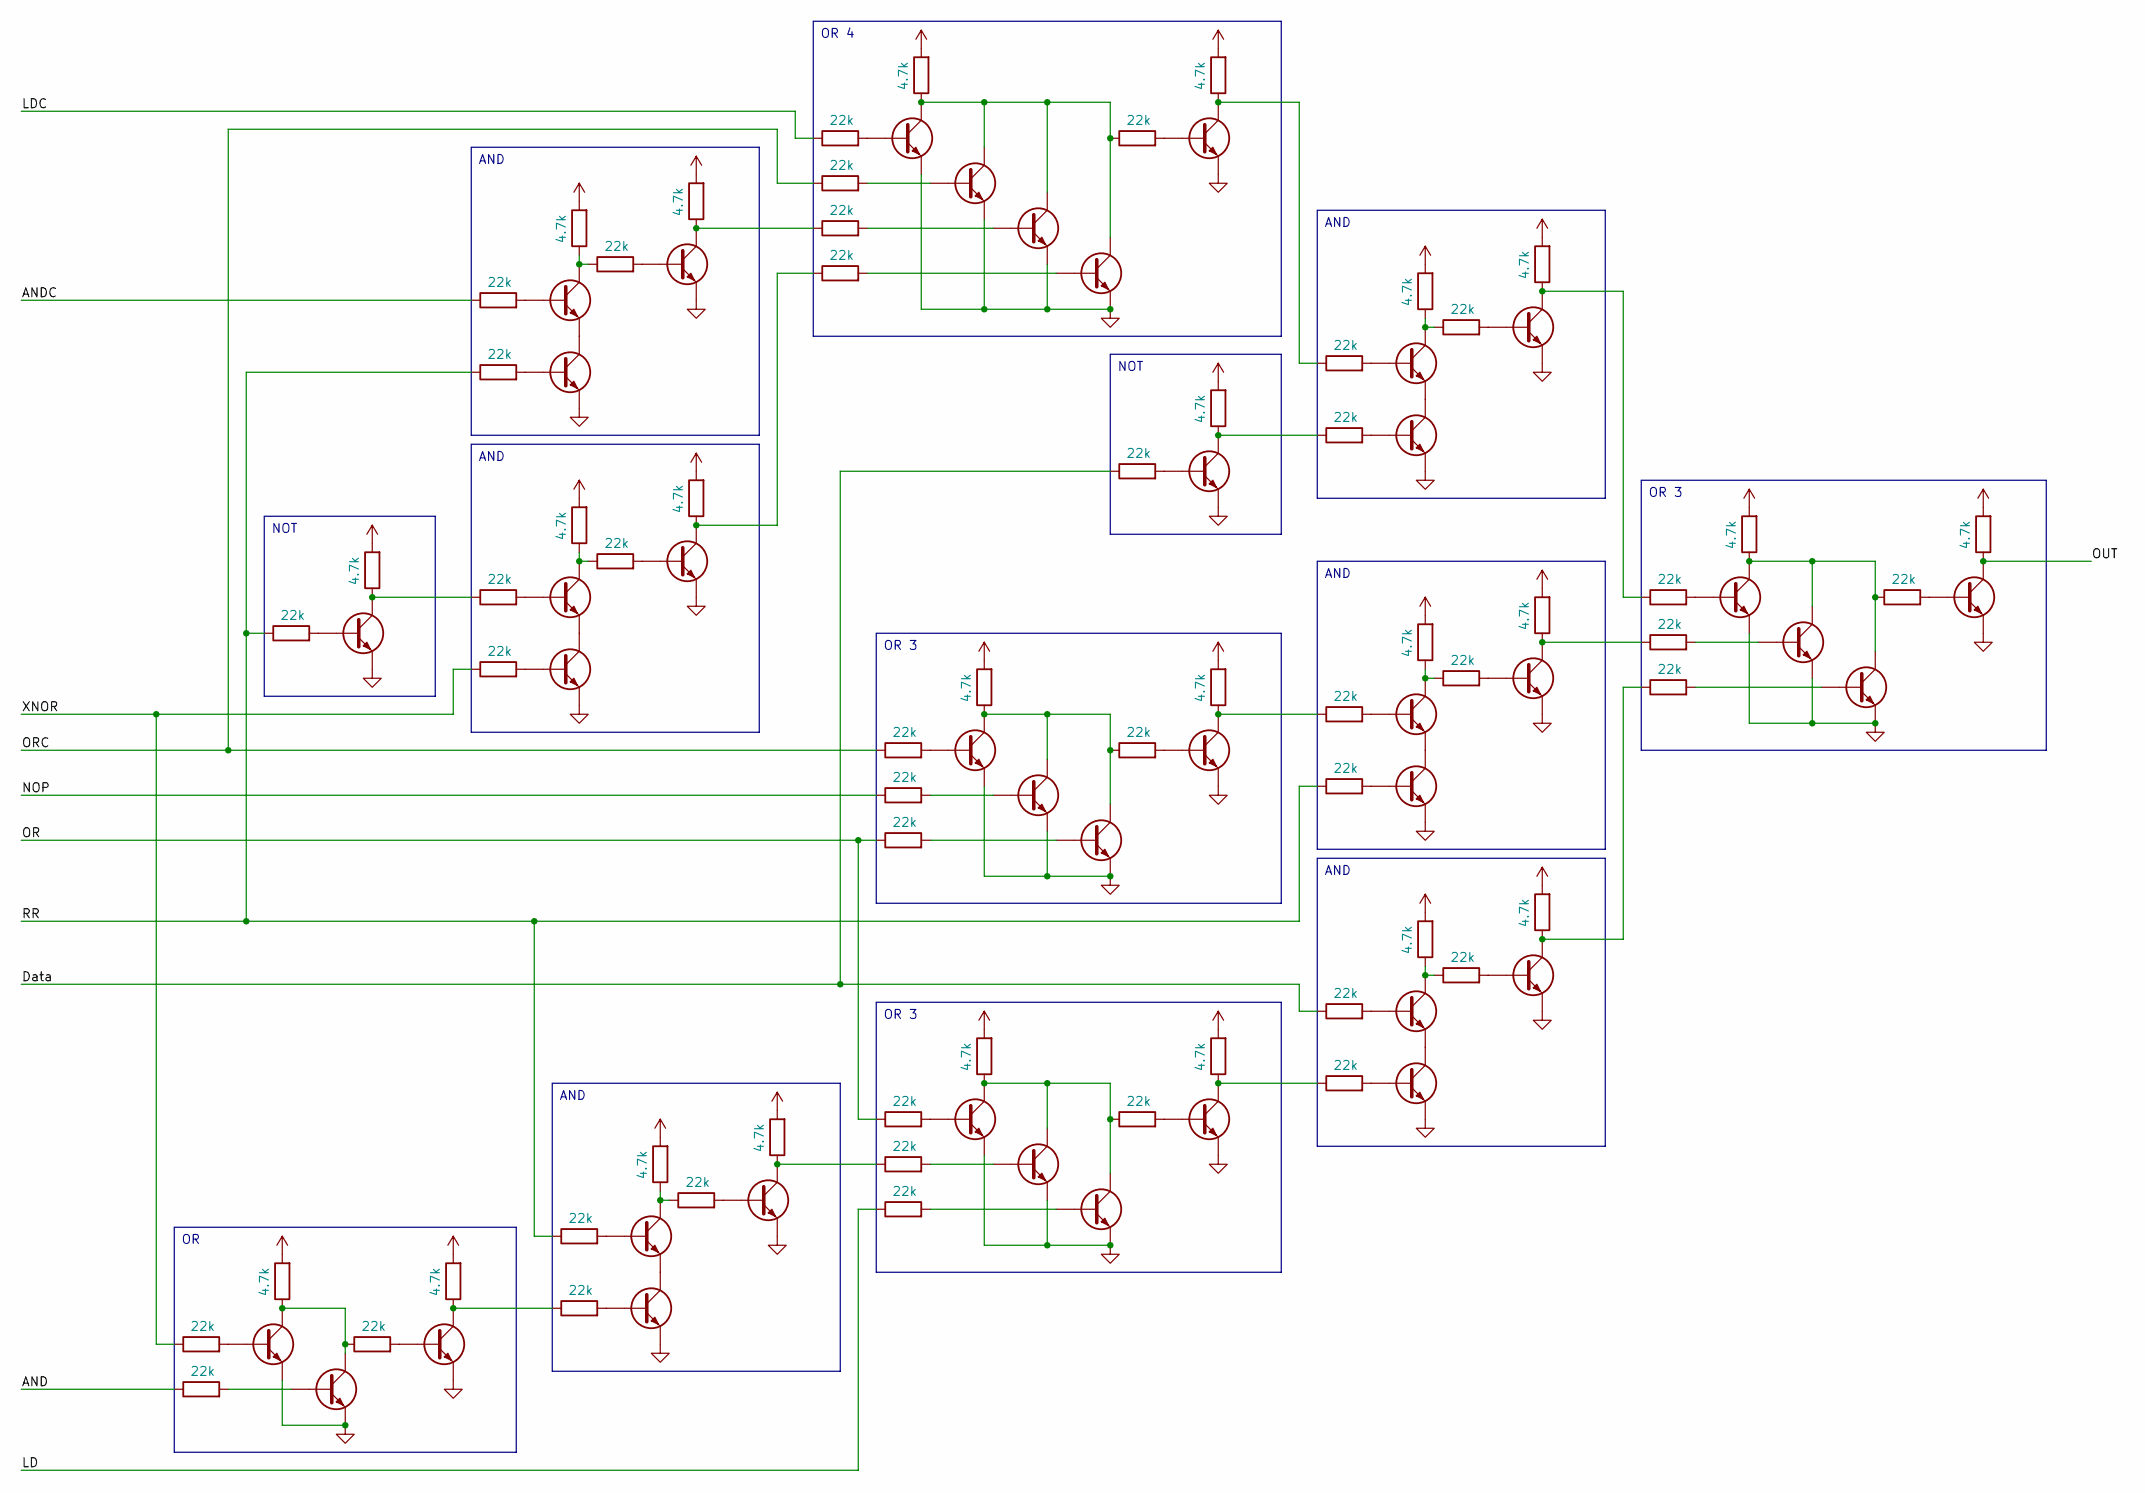
[picture p30: schematic LU.kicad_sch]

Parts:
Q10, Q11, Q12, Q13, Q14, Q15, Q16, Q17, Q18, Q19, Q20, Q21, Q22, Q23, Q24, Q25, Q26, Q28, Q29, Q30, Q31, Q32, Q33, Q34, Q35, Q36, Q37, Q38, Q39, Q40, Q41, Q42, Q43, Q44, Q45, Q46, Q47, Q48, Q49, Q50: NPN
R14, R16, R17, R19, R20, R21, R23, R25, R26, R27, R29, R31, R32, R34, R36, R37, R39, R43, R45, R47, R48, R50, R52, R53, R54, R56, R58, R59, R60, R62, R64, R65, R67, R69, R70, R72, R74, R75, R76, R78: 22k
R15, R18, R22, R24, R28, R30, R33, R35, R38, R40, R44, R46, R49, R51, R55, R57, R61, R63, R66, R68, R71, R73, R77, R79: 4.7k

Connections:
+5V: R15.2, R18.2, R22.2, R24.2, R28.2, R30.2, R33.2, R35.2, R38.2, R40.2, R44.2, R46.2, R49.2, R51.2, R55.2, R57.2, R61.2, R63.2, R66.2, R68.2, R71.2, R73.2, R77.2, R79.2
AND: R20.1
ANDC: R31.1
Data: R45.1, R69.1
GND: Q11.3 (E), Q12.3 (E), Q13.3 (E), Q14.3 (E), Q15.3 (E), Q16.3 (E), Q17.3 (E), Q18.3 (E), Q19.3 (E), Q20.3 (E), Q22.3 (E), Q23.3 (E), Q25.3 (E), Q26.3 (E), Q28.3 (E), Q29.3 (E), Q31.3 (E), Q32.3 (E), Q33.3 (E), Q34.3 (E), Q35.3 (E), Q36.3 (E), Q37.3 (E), Q38.3 (E), Q39.3 (E), Q40.3 (E), Q42.3 (E), Q43.3 (E), Q45.3 (E), Q46.3 (E), Q47.3 (E), Q48.3 (E), Q49.3 (E), Q50.3 (E)
LD: R76.1
LDC: R21.1
NOP: R59.1
unnamed: Q10.1 (C), R15.1, R17.1
unnamed: Q10.2 (B), R14.2
unnamed: Q10.3 (E), Q11.1 (C)
unnamed: Q11.2 (B), R16.2
unnamed: Q12.1 (C), R18.1, R75.1
unnamed: Q12.2 (B), R17.2
unnamed: Q13.1 (C), Q14.1 (C), R22.1, R23.1
unnamed: Q13.2 (B), R19.2
unnamed: Q14.2 (B), R20.2
unnamed: Q15.1 (C), Q17.1 (C), Q18.1 (C), Q19.1 (C), R28.1, R29.1
unnamed: Q15.2 (B), R21.2
unnamed: Q16.1 (C), R16.1, R24.1
unnamed: Q16.2 (B), R23.2
unnamed: Q17.2 (B), R25.2
unnamed: Q18.2 (B), R26.2
unnamed: Q19.2 (B), R27.2
unnamed: Q20.1 (C), R30.1, R47.1
unnamed: Q20.2 (B), R29.2
unnamed: Q21.1 (C), R33.1, R34.1
unnamed: Q21.2 (B), R31.2
unnamed: Q21.3 (E), Q22.1 (C)
unnamed: Q22.2 (B), R32.2
unnamed: Q23.1 (C), R26.1, R35.1
unnamed: Q23.2 (B), R34.2
unnamed: Q24.1 (C), R38.1, R39.1
unnamed: Q24.2 (B), R36.2
unnamed: Q24.3 (E), Q25.1 (C)
unnamed: Q25.2 (B), R37.2
unnamed: Q26.1 (C), R27.1, R40.1
unnamed: Q26.2 (B), R39.2
unnamed: Q28.1 (C), R36.1, R44.1
unnamed: Q28.2 (B), R43.2
unnamed: Q29.1 (C), R46.1, R48.1
unnamed: Q29.2 (B), R45.2
unnamed: Q30.1 (C), R49.1, R50.1
unnamed: Q30.2 (B), R47.2
unnamed: Q30.3 (E), Q31.1 (C)
unnamed: Q31.2 (B), R48.2
unnamed: Q32.1 (C), R51.1, R52.1
unnamed: Q32.2 (B), R50.2
unnamed: Q33.1 (C), Q34.1 (C), Q35.1 (C), R55.1, R56.1
unnamed: Q33.2 (B), R52.2
unnamed: Q34.2 (B), R53.2
unnamed: Q35.2 (B), R54.2
unnamed: Q36.2 (B), R56.2
unnamed: Q37.1 (C), Q38.1 (C), Q39.1 (C), R61.1, R62.1
unnamed: Q37.2 (B), R58.2
unnamed: Q38.2 (B), R59.2
unnamed: Q39.2 (B), R60.2
unnamed: Q40.1 (C), R63.1, R64.1
unnamed: Q40.2 (B), R62.2
unnamed: Q41.1 (C), R66.1, R67.1
unnamed: Q41.2 (B), R64.2
unnamed: Q41.3 (E), Q42.1 (C)
unnamed: Q42.2 (B), R65.2
unnamed: Q43.1 (C), R53.1, R68.1
unnamed: Q43.2 (B), R67.2
unnamed: Q44.1 (C), R71.1, R72.1
unnamed: Q44.2 (B), R69.2
unnamed: Q44.3 (E), Q45.1 (C)
unnamed: Q45.2 (B), R70.2
unnamed: Q46.1 (C), R54.1, R73.1
unnamed: Q46.2 (B), R72.2
unnamed: Q47.1 (C), Q48.1 (C), Q49.1 (C), R77.1, R78.1
unnamed: Q47.2 (B), R74.2
unnamed: Q48.2 (B), R75.2
unnamed: Q49.2 (B), R76.2
unnamed: Q50.1 (C), R70.1, R79.1
unnamed: Q50.2 (B), R78.2
OR: R60.1, R74.1
ORC: R25.1, R58.1
OUT: Q36.1 (C), R57.1
RR: R14.1, R32.1, R43.1, R65.1
XNOR: R19.1, R37.1

Notes on the sheet:
AND
OR 3
NOT
OR 4
